jackhumbert/reform/symbol-for-derived-works/application-example-pcb.png

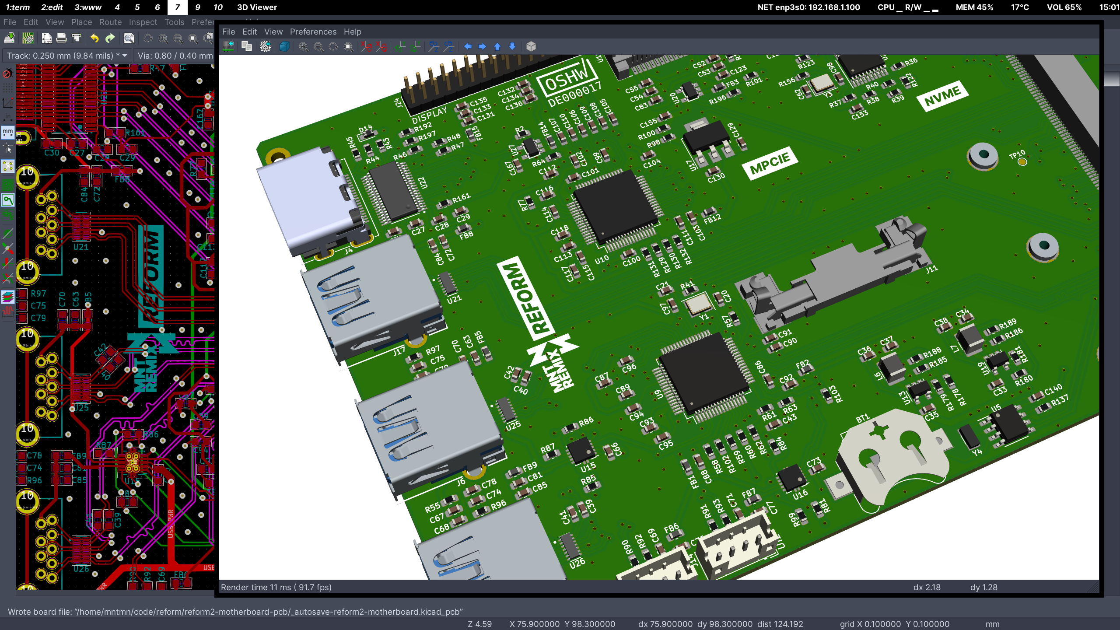
symbol-for-derived-works/application-example-pcb.png
