jackhumbert/reform/reform2-cables/mnt-reform2-serial-cable.png

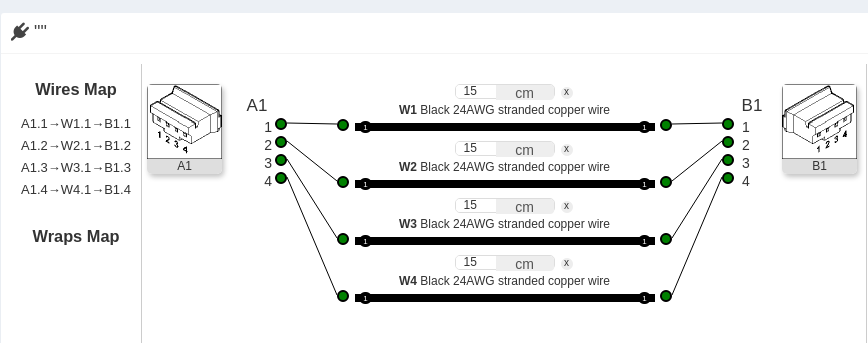
reform2-cables/mnt-reform2-serial-cable.png
