jackhumbert/reform/reform2-cables/mnt-reform2-speakers-cable.png

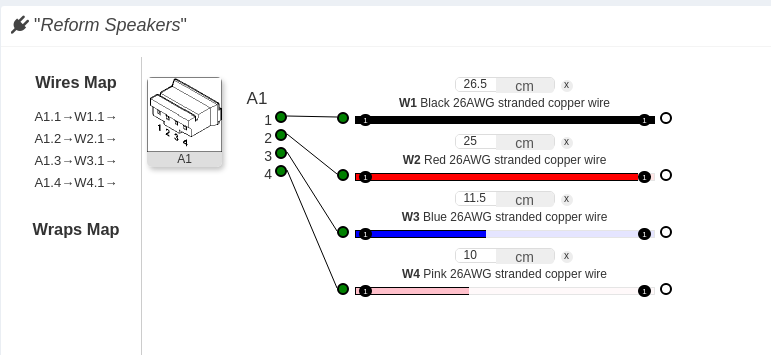
reform2-cables/mnt-reform2-speakers-cable.png
