jackhumbert/reform/reform2-motherboard25-pcb/footprints/mnt-based-reform-symbol.png

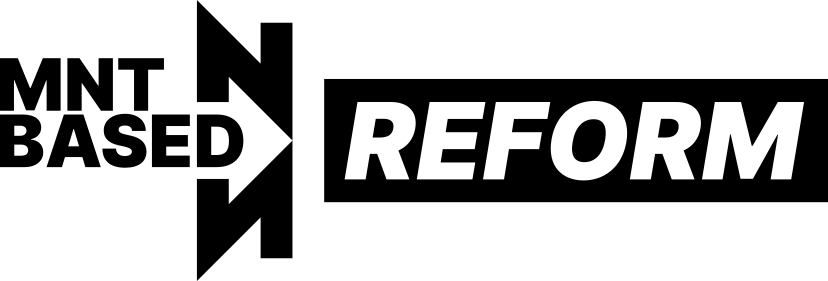
reform2-motherboard25-pcb/footprints/mnt-based-reform-symbol.png
