jackhumbert/reform/reform2-keyboard-pcb/reform2-keyboard_bom_top.csv

Comment | Designator | Footprint | LCSC Part #
Choc | SW1 SW7 SW13 SW19 SW25 SW31 SW37 SW43 SW49 SW55 SW61 SW67 SW73 SW78 SW8 SW14 SW20 SW26 SW32 SW38 SW44 SW50 SW56 SW62 SW68 SW74 SW79 SW9 SW15 SW21 SW27 SW33 SW39 SW45 SW51 SW57 SW63 SW69 SW75 SW80 SW4 SW10 SW16 SW22 SW28 SW34 SW40 SW46 SW52 SW58 SW64 SW70 SW76 SW81 SW5 SW11 SW17 SW23 SW29 SW35 SW41 SW47 SW53 SW59 SW65 SW71 SW77 SW82 SW6 SW12 SW18 SW24 SW30 SW36 SW42 SW3 SW2 SW48 SW54 SW60 SW66 SW72 |  | C400230
MMDL914T1G | D1 D7 D13 D19 D25 D31 D37 D43 D49 D55 D61 D67 D73 D78 D8 D14 D20 D26 D32 D38 D44 D50 D56 D62 D68 D74 D79 D9 D15 D21 D27 D33 D39 D45 D51 D57 D63 D69 D75 D80 D4 D10 D16 D22 D28 D34 D40 D46 D52 D58 D64 D70 D76 D81 D5 D11 D17 D23 D29 D35 D41 D47 D53 D59 D65 D71 D77 D82 D6 D12 D18 D24 D30 D36 D42 D3 D2 D48 D54 D60 D66 D72 |  | C193404
18pF | C1 C2 |  | C107040
1uF | C3 C5 C11 C12 C9 C8 C13 |  | C14664
22 | R2 R1 R17 R18 R19 |  | C107701
0.1uF | C4 C6 |  | C14663
10k | R3 R16 |  | C99198
16MHz | Y1 |  | C70562
RESET | SW83 |  | C318893
SW_DIP_x01 | SW84 |  | C402914
0 | R4 R15 |  | C95177
UART | J2 |  | C265332
AUX | J3 |  | C555410
4.7k | R5 R6 R9 |  | C105428
USB_C_Receptacle_USB2.0 | J4 |  | C165948
5.1k | R13 R14 |  | C105580
MCP1700-3302E_SOT23 | U3 |  | C39051
USBLC6-2SC6 | U4 |  | C2687116
USB | J1 |  | C265332
0ZCJ0075AF2E | F1 |  | C70082
BLM18PG221SH1D | FB1 |  | C14709
BZT52-B5V6J | D164 |  | C173406
AVR-ISP-6 | J5
TPS61185 | U2 |  | C2867853
1M | R11 |  | C107698
4.7uF | C10 C7 |  | C90057
54.9K | R12 |  | C227961
715K | R10 |  | C137685
604K | R8 |  | C245986
62K | R7 |  | C137694
B250-13-F | D83 |  | C2758510
WLED | D84 D85 D86 D87 D88 D89 D90 D91 D94 D95 D96 D97 D98 D99 D100 D101 D104 D105 D106 D107 D108 D109 D110 D111 D114 D115 D116 D117 D118 D119 D120 D121 D124 D125 D126 D127 D128 D129 D130 D131 D134 D135 D136 D137 D138 D139 D140 D141 D144 D145 D146 D147 D148 D149 D150 D151 D154 D155 D156 D157 D158 D159 D160 D161 D92 D93 D102 D103 D112 D113 D122 D123 D132 D133 D142 D143 D152 D153 D162 D163 |  | C389521
10uH | L1 |  | C98364
