jackhumbert/reform/reform2-bom/reform2-batterypack.csv

Designators | Qty | Brand | Part Number
J1 | 1 | Molex | 504050-0591
U1-U8 | 8 | Keystone | 54
