jackhumbert/reform/reform2-case-ports/ports-r1-v2-a-extrude.FCStd

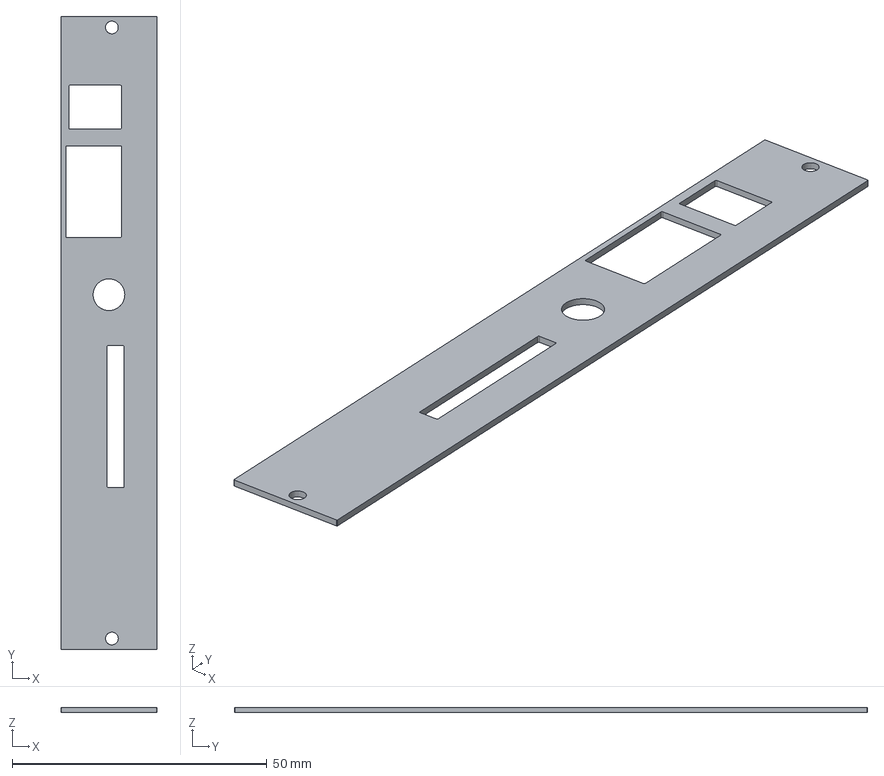
[picture p7: CAD file, 2022-02-27]
reform2-case-ports/ports-r1-v2-a-extrude.FCStd
18.9 x 124.3 x 1.00 mm
