jackhumbert/reform/reform2-imx8mplus/3d-models/FH12-22S-0.5SH.stp

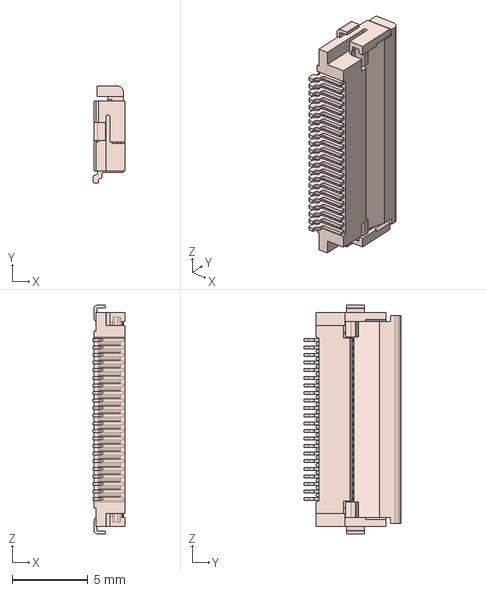
[picture p8: CAD file, 2022-09-06]
reform2-imx8mplus/3d-models/FH12-22S-0.5SH.stp
2.10 x 6.40 x 15.1 mm
