jackhumbert/reform/reform2-motherboard25-pcb/3d-models/HTQFP-80.stp

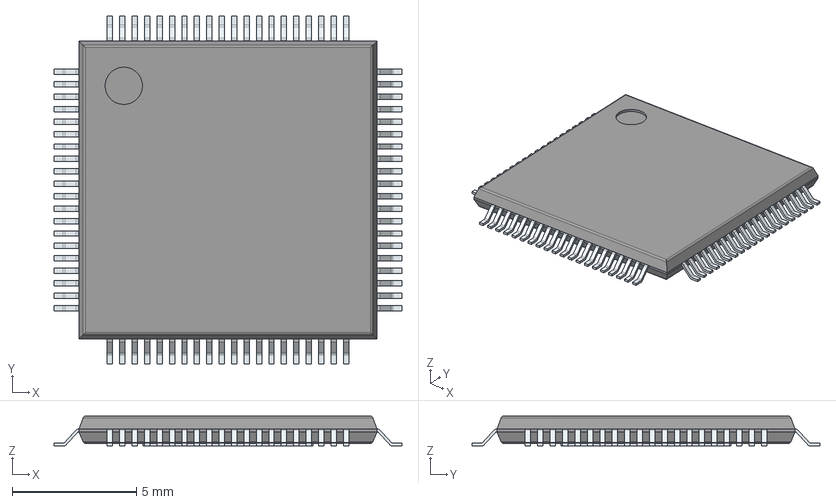
[picture p9: CAD file, 2022-10-27]
reform2-motherboard25-pcb/3d-models/HTQFP-80.stp
14.0 x 14.0 x 1.20 mm
PinsArrayLR
PinsArrayTB
ThermalPad
