jackhumbert/reform/reform2-protected-batterypack-pcb/3d-models/PowerPAK 1212-8 Single Pad.step

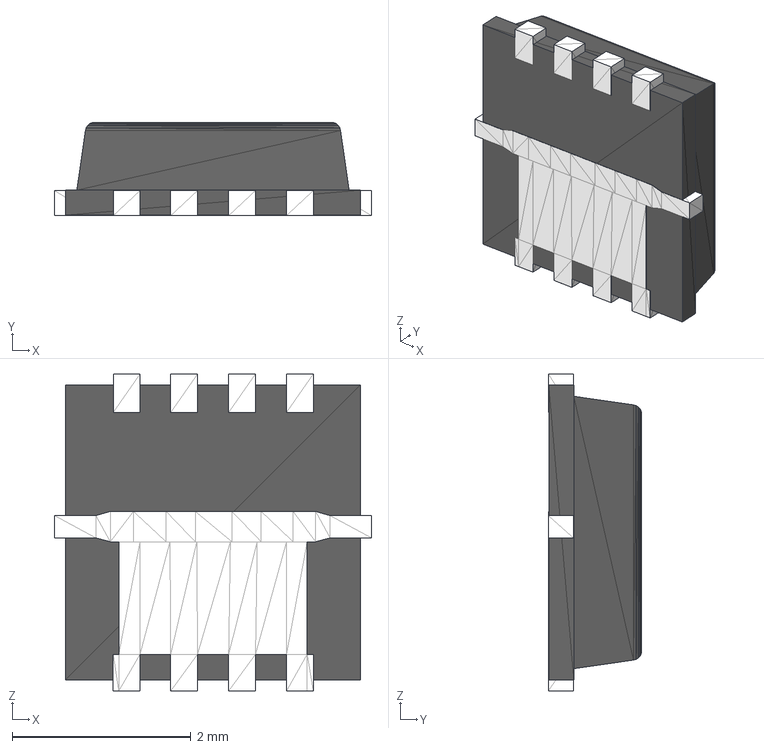
[picture p10: CAD file, 2022-08-30]
reform2-protected-batterypack-pcb/3d-models/PowerPAK 1212-8 Single Pad.step
3.55 x 1.05 x 3.55 mm
