jackhumbert/reform/reform2-trackball-pcb/3d-models/SMD_Polyfuse_1206.stp

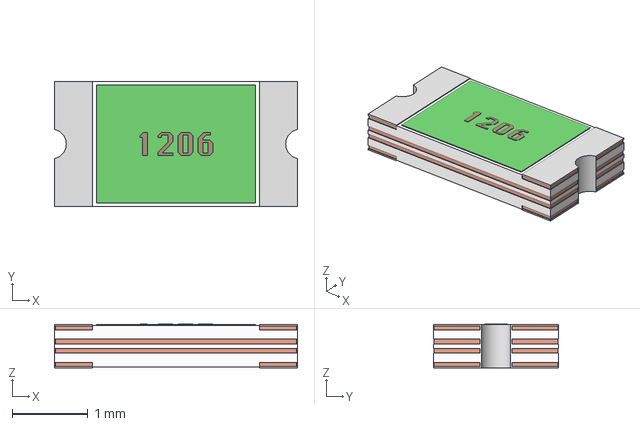
[picture p11: CAD file, 2021-07-25]
reform2-trackball-pcb/3d-models/SMD_Polyfuse_1206.stp
3.20 x 1.65 x 0.575 mm
