jackhumbert/reform/reform2-trackpad-pcb/3d-models/FH12-6S-0.5SH.stp

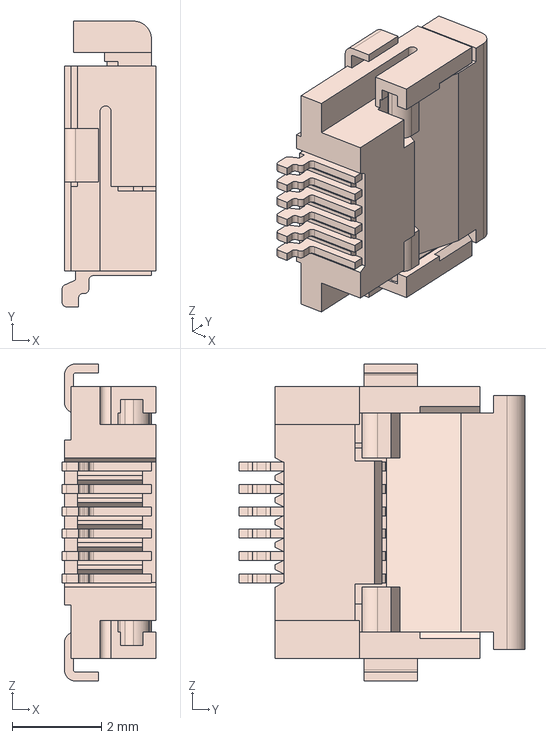
[picture p12: CAD file, 2021-07-25]
reform2-trackpad-pcb/3d-models/FH12-6S-0.5SH.stp
2.10 x 6.40 x 7.10 mm
