jackhumbert/reform/reform2-trackpad-pcb/trackpad-glass-glue-gasket-20200807.step

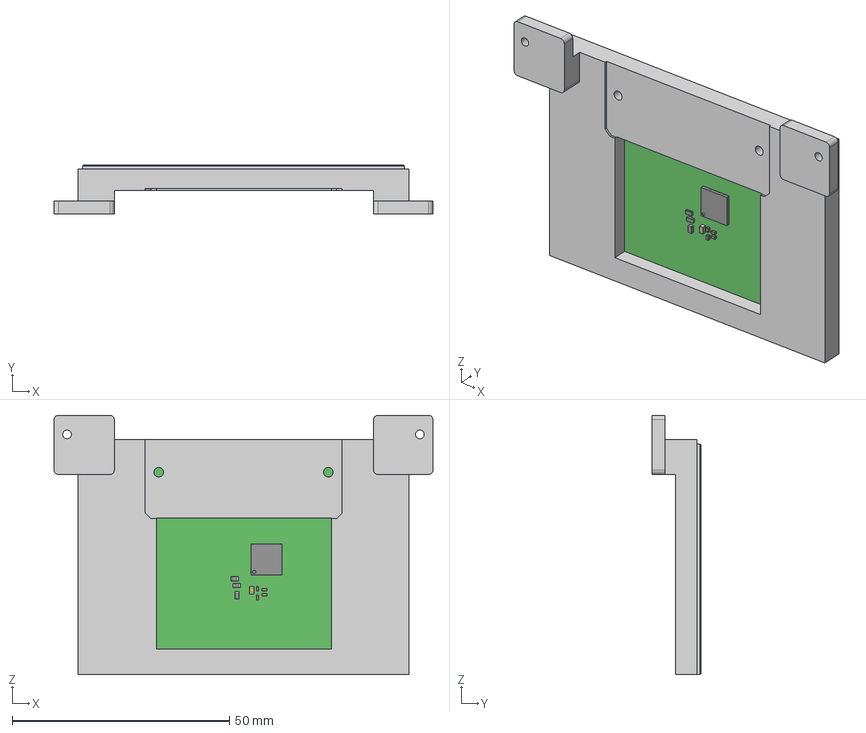
[picture p13: CAD file, 2021-07-30]
reform2-trackpad-pcb/trackpad-glass-glue-gasket-20200807.step
87.2 x 11.4 x 59.6 mm
trackingpad support (1)
glass (1)
GLUE AZOTEQ
GLUE SLA
C-0402 x 4
C-0603
R-0603 x 3
U-QFN-P0.5-7X7-48
GASKET
