jackhumbert/reform/reform2-keyboard3-pcb/3d-models/EG1271A.step

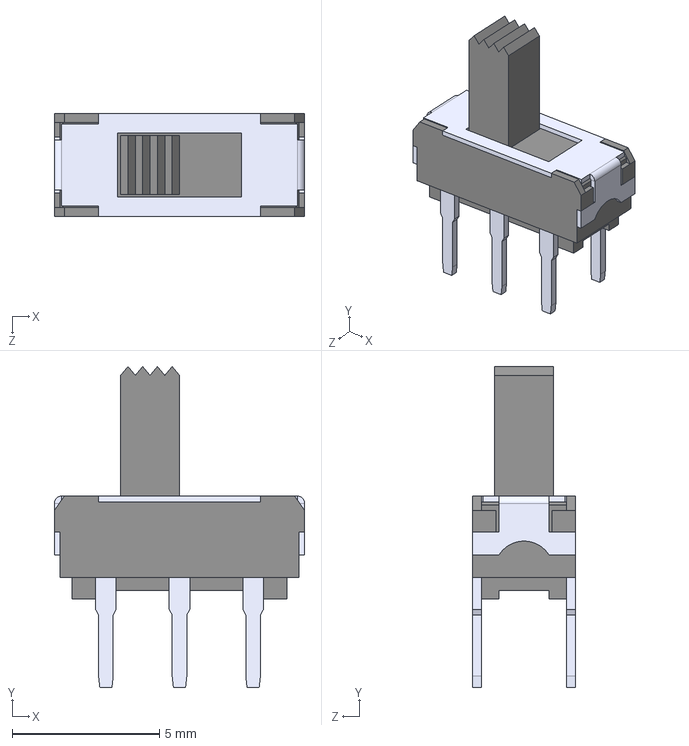
[picture p15: CAD file, 2023-02-02]
reform2-keyboard3-pcb/3d-models/EG1271A.step
8.50 x 10.9 x 3.50 mm
