jackhumbert/reform/reform2-protected-batterypack-pcb/3d-models/KEYSTONE 54 18650.step

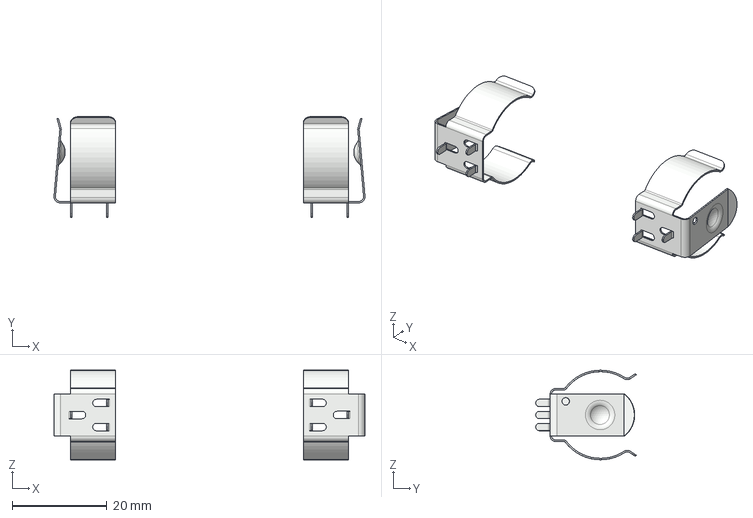
[picture p16: CAD file, 2022-08-30]
reform2-protected-batterypack-pcb/3d-models/KEYSTONE 54 18650.step
65.6 x 21.2 x 18.9 mm
KEYSTONE 54 x 2
