jackhumbert/reform/reform2-motherboard25-pcb/3d-models/srr1210.stp

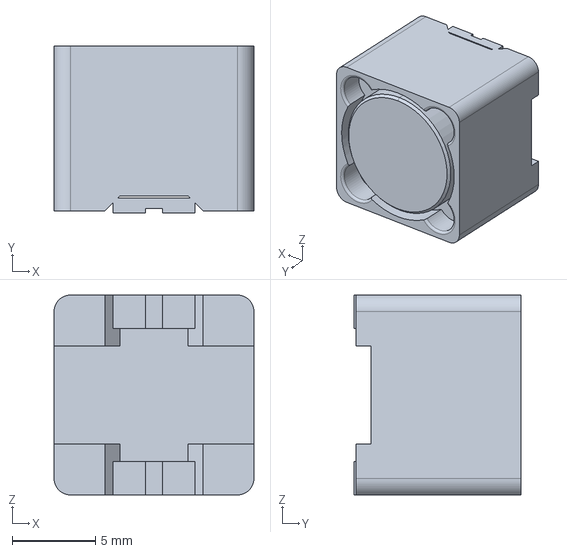
[picture p17: CAD file, 2022-10-14]
reform2-motherboard25-pcb/3d-models/srr1210.stp
12.0 x 10.0 x 12.0 mm
