jackhumbert/reform/reform2-protected-batterypack-pcb/3d-models/Bateria 18650 3.7 V 1300 mAh d.18 mm.STEP

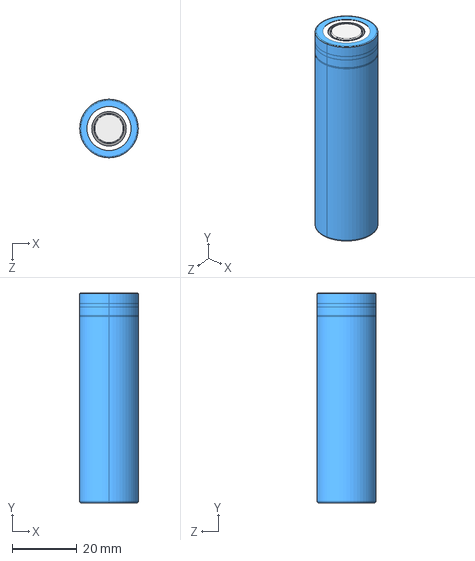
[picture p18: CAD file, 2022-08-30]
reform2-protected-batterypack-pcb/3d-models/Bateria 18650 3.7 V 1300 mAh d.18 mm.STEP
18.1 x 64.7 x 18.1 mm
