jackhumbert/reform/reform2-trackball-pcb/3d-models/c-1734839-6-c-3d.stp

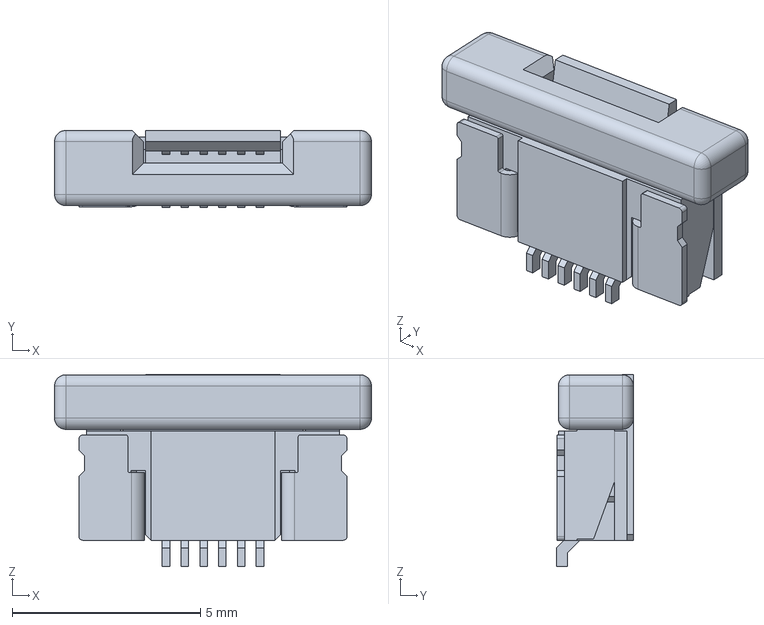
[picture p19: CAD file, 2021-07-25]
reform2-trackball-pcb/3d-models/c-1734839-6-c-3d.stp
8.43 x 2.05 x 5.11 mm
