jackhumbert/reform/reform2-keyboard3-pcb/3d-models/Kailh - keycap 1.5 v2.step

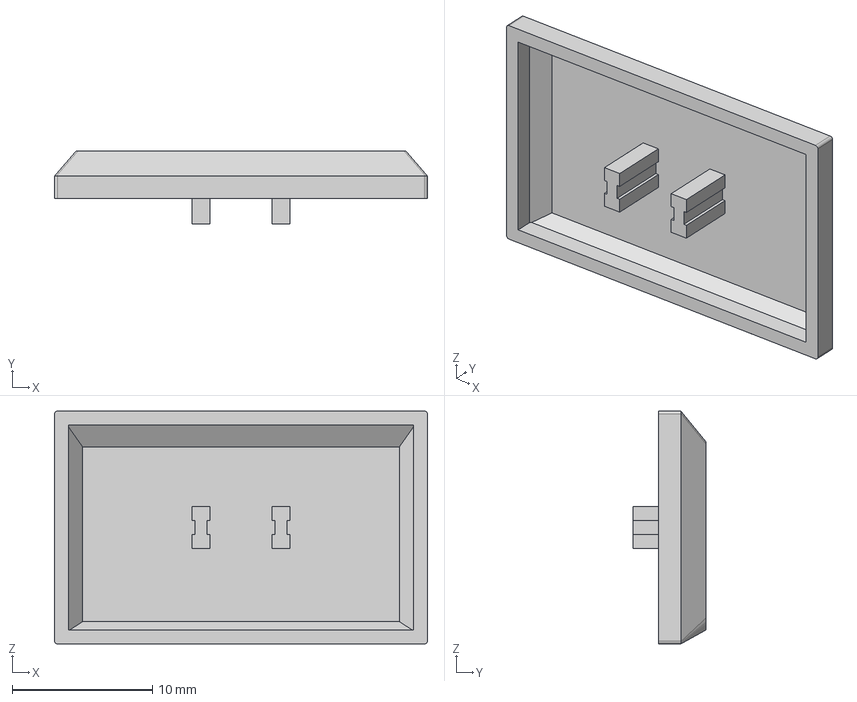
[picture p20: CAD file, 2023-02-02]
reform2-keyboard3-pcb/3d-models/Kailh - keycap 1.5 v2.step
26.6 x 5.23 x 16.6 mm
