jackhumbert/reform/reform2-keyboard3-pcb/3d-models/S4B-PH-SM4-TB.stp

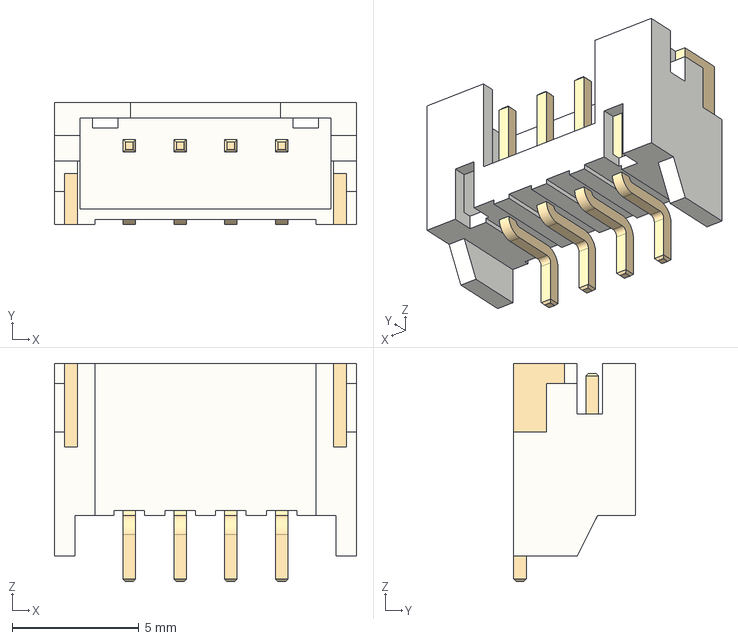
[picture p21: CAD file, 2023-02-02]
reform2-keyboard3-pcb/3d-models/S4B-PH-SM4-TB.stp
11.9 x 4.80 x 8.60 mm
