jackhumbert/reform/reform2-keyboard3-pcb/3d-models/Kailh_keycap-switch_system_1x1.step

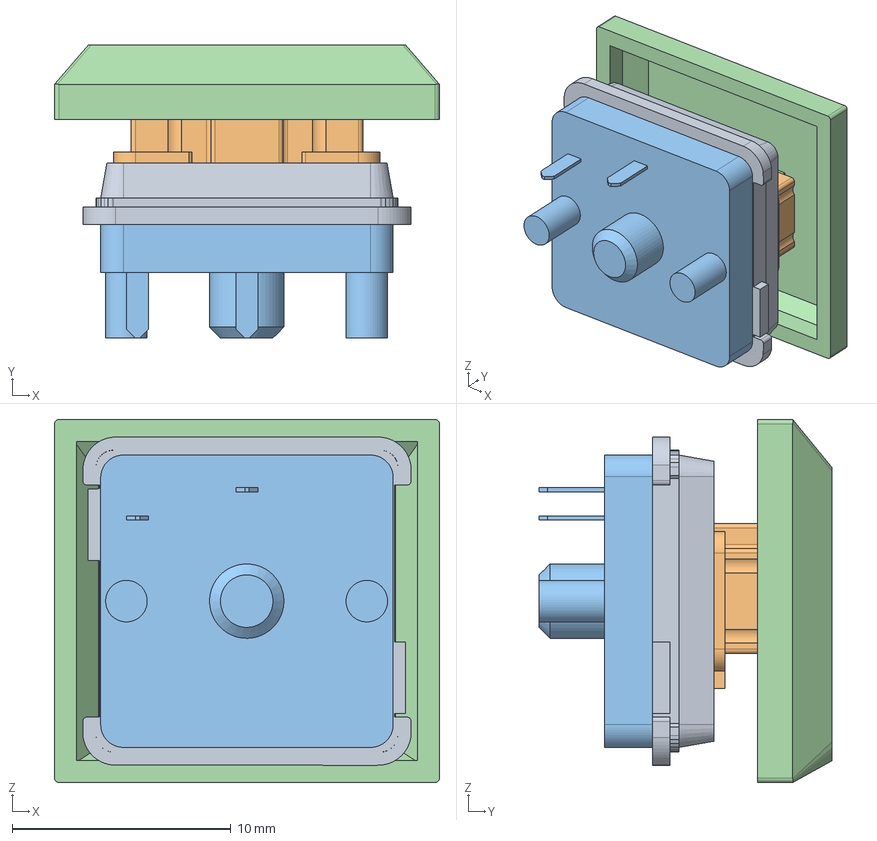
[picture p22: CAD file, 2023-02-02]
reform2-keyboard3-pcb/3d-models/Kailh_keycap-switch_system_1x1.step
17.6 x 13.4 x 16.6 mm
CPG135001D02 BROWN
Kailh_keycap
