jackhumbert/reform/reform2-protected-batterypack-pcb/3d-models/KEYSTONE 54 A.step

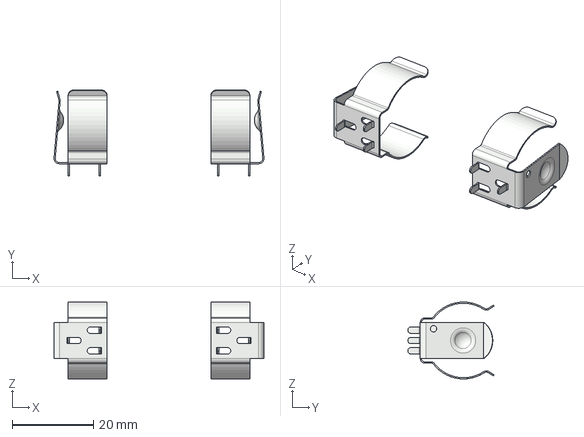
[picture p23: CAD file, 2022-08-30]
reform2-protected-batterypack-pcb/3d-models/KEYSTONE 54 A.step
51.6 x 21.2 x 18.9 mm
KEYSTONE 54 x 2
