jackhumbert/reform/reform2-keyboard3-pcb/3d-models/Kailh_keycap-switch_system_1.5x1.step

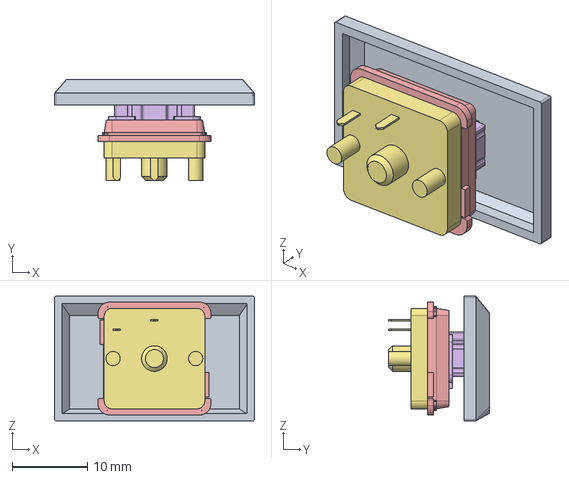
[picture p24: CAD file, 2023-02-02]
reform2-keyboard3-pcb/3d-models/Kailh_keycap-switch_system_1.5x1.step
26.6 x 13.4 x 16.6 mm
