jackhumbert/reform/reform2-motherboard25-pcb/3d-models/SMD_Polyfuse_2920.stp

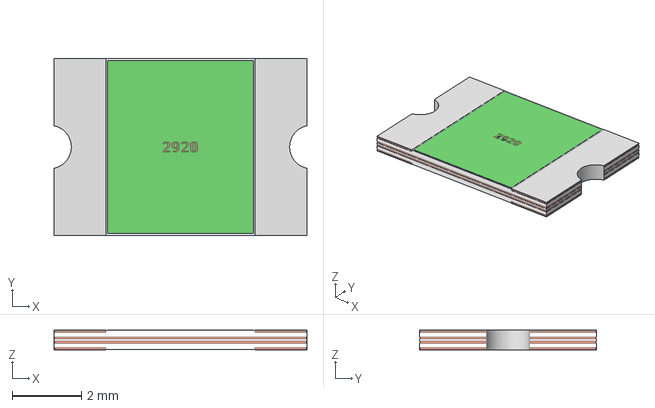
[picture p25: CAD file, 2022-10-14]
reform2-motherboard25-pcb/3d-models/SMD_Polyfuse_2920.stp
7.30 x 5.10 x 0.575 mm
