jackhumbert/reform/reform2-protected-batterypack-pcb/3d-models/POWERPAK 1212-8.STEP

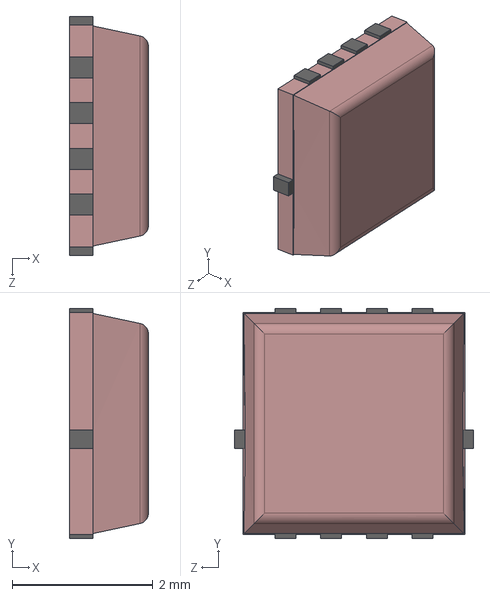
[picture p26: CAD file, 2022-08-30]
reform2-protected-batterypack-pcb/3d-models/POWERPAK 1212-8.STEP
1.12 x 3.27 x 3.40 mm
