jackhumbert/reform/reform2-keyboard3-pcb/3d-models/500SSPxS2M2xEA.stp

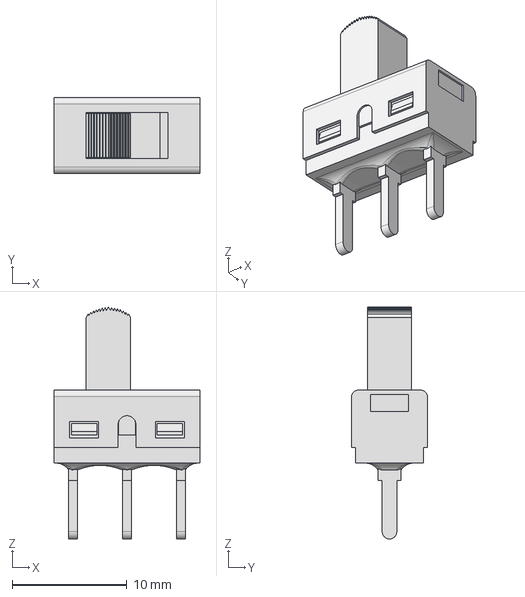
[picture p27: CAD file, 2023-02-02]
reform2-keyboard3-pcb/3d-models/500SSPxS2M2xEA.stp
12.7 x 6.60 x 20.2 mm
