jackhumbert/reform/reform2-motherboard25-pcb/3d-models/CM2020-00TR--3DModel-STEP-56544.STEP

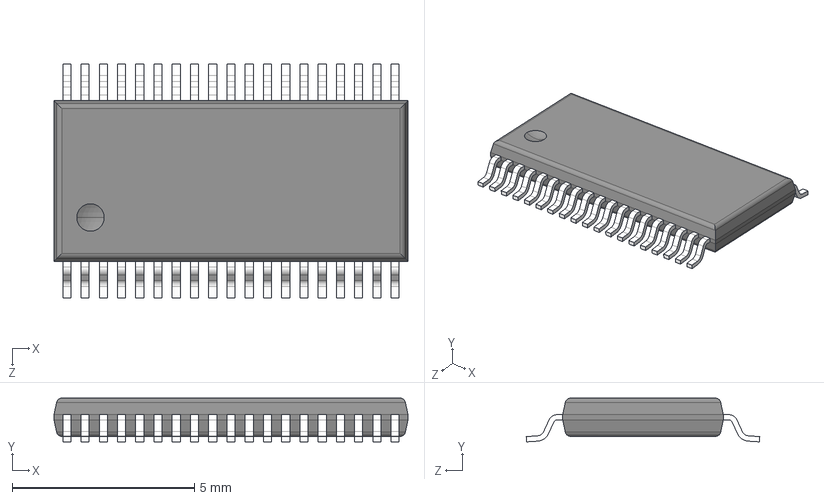
[picture p28: CAD file, 2022-10-14]
reform2-motherboard25-pcb/3d-models/CM2020-00TR--3DModel-STEP-56544.STEP
9.70 x 1.20 x 6.40 mm
