jackhumbert/reform/reform2-protected-batterypack-pcb/3d-models/keystone-PN54.STEP

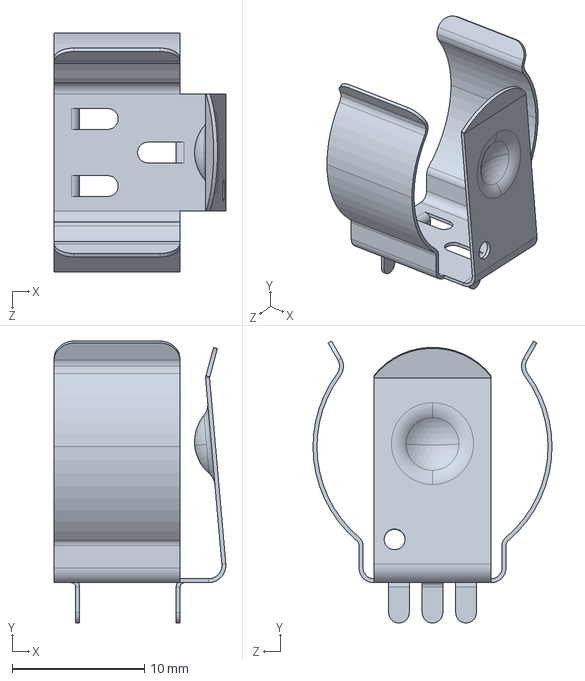
[picture p29: CAD file, 2022-08-30]
reform2-protected-batterypack-pcb/3d-models/keystone-PN54.STEP
13.0 x 21.4 x 18.1 mm
