jackhumbert/reform/reform2-keyboard3-pcb/3d-models/srp4020.stp

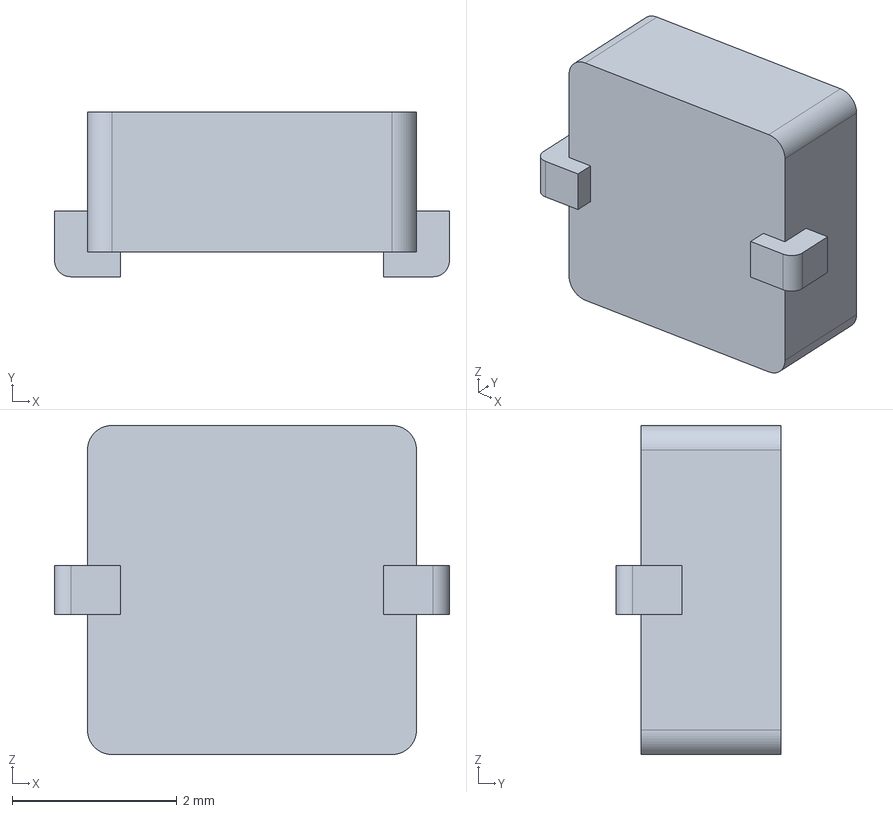
[picture p30: CAD file, 2023-02-02]
reform2-keyboard3-pcb/3d-models/srp4020.stp
4.80 x 2.00 x 4.00 mm
