jackhumbert/reform/reform2-motherboard25-pcb/3d-models/L8BE-1G1T-BFH--3DModel-STEP-56544.STEP

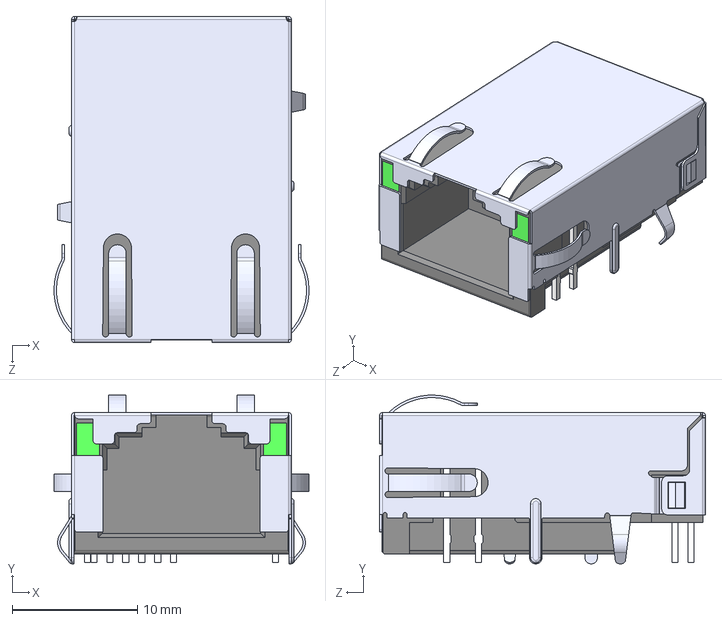
[picture p31: CAD file, 2022-10-14]
reform2-motherboard25-pcb/3d-models/L8BE-1G1T-BFH--3DModel-STEP-56544.STEP
20.4 x 13.5 x 26.1 mm
