jackhumbert/reform/reform2-keyboard3-pcb/3d-models/TYPE-C-31-M-12--3DModel-STEP-56544.STEP

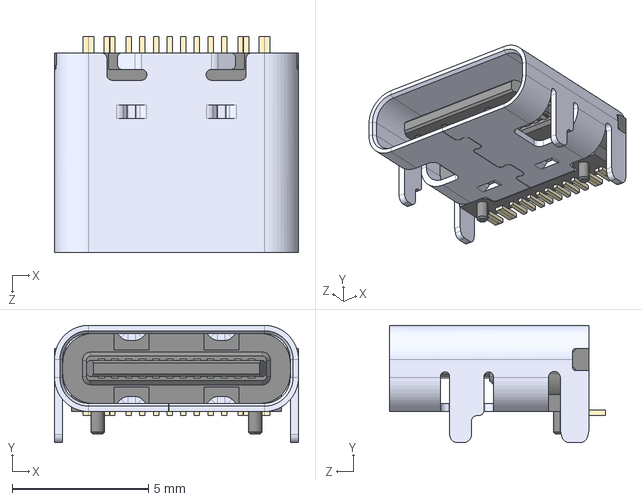
[picture p32: CAD file, 2022-09-01]
reform2-keyboard3-pcb/3d-models/TYPE-C-31-M-12--3DModel-STEP-56544.STEP
8.94 x 4.30 x 7.90 mm
