jackhumbert/reform/reform2-keyboard3-pcb/3d-models/KMR221GLFS.step

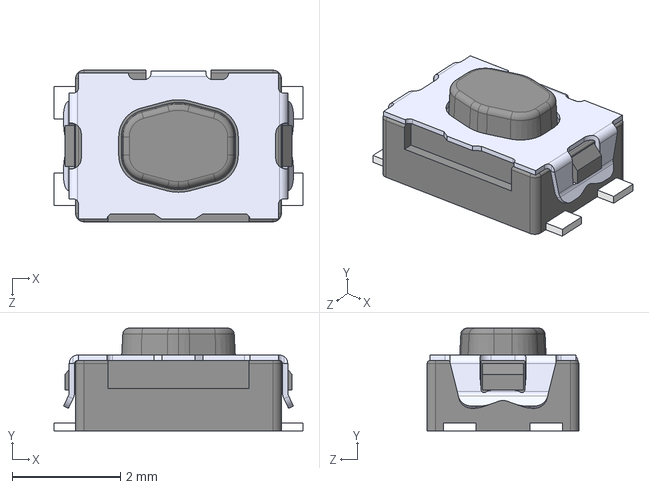
[picture p33: CAD file, 2021-07-25]
reform2-keyboard3-pcb/3d-models/KMR221GLFS.step
4.60 x 1.90 x 2.80 mm
