jackhumbert/reform/reform2-motherboard25-pcb/3d-models/J0G-0003NL.step

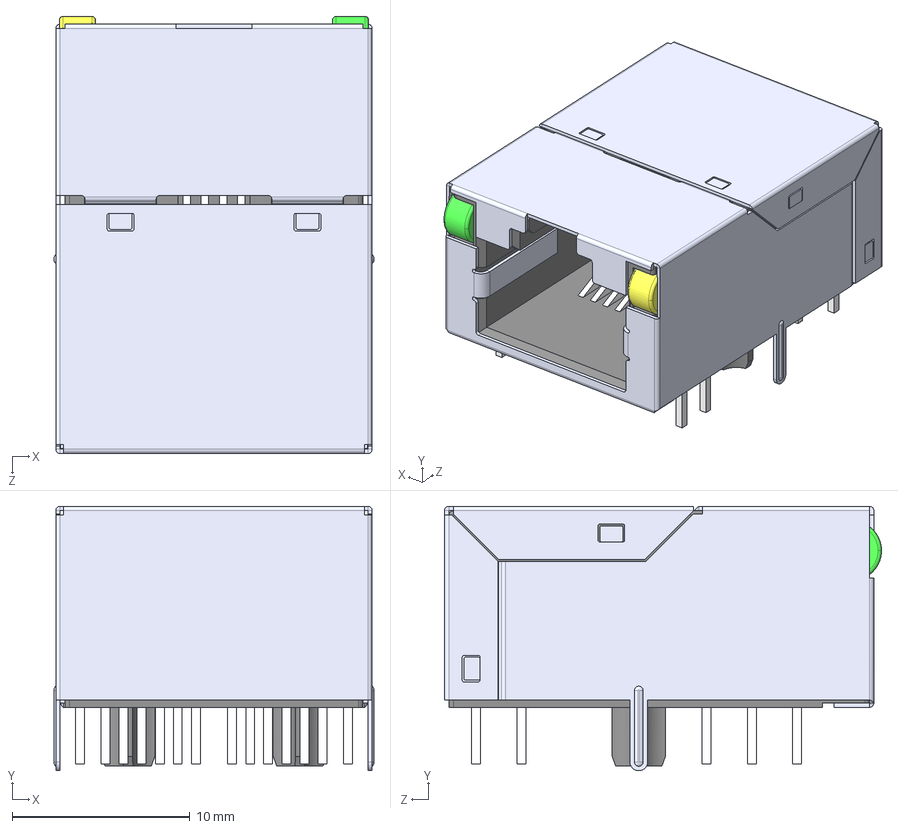
[picture p34: CAD file, 2022-10-14]
reform2-motherboard25-pcb/3d-models/J0G-0003NL.step
18.0 x 14.9 x 24.6 mm
