jackhumbert/reform/reform2-motherboard25-pcb/3d-models/21-0140L_T1655-2.step

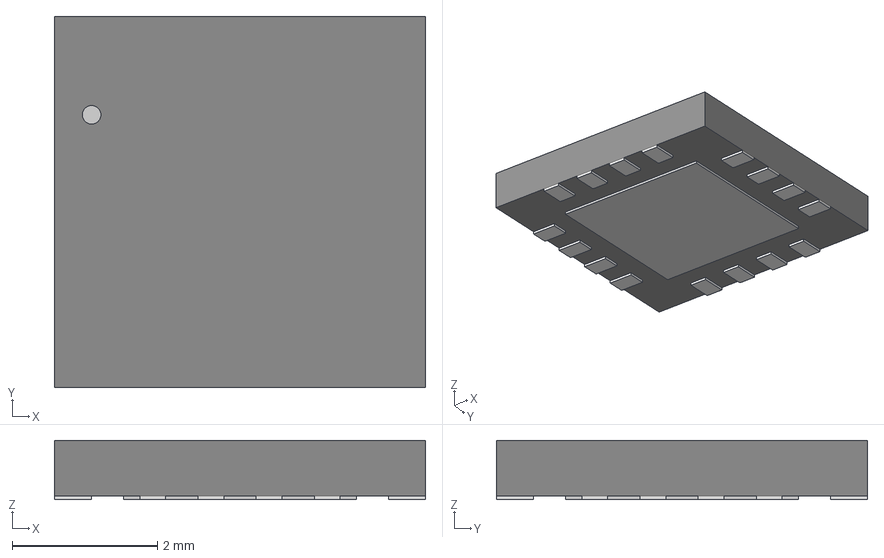
[picture p35: CAD file, 2022-10-14]
reform2-motherboard25-pcb/3d-models/21-0140L_T1655-2.step
5.11 x 5.11 x 0.815 mm
