jackhumbert/reform/reform2-motherboard25-pcb/3d-models/SW3dPS-rapc722.STEP

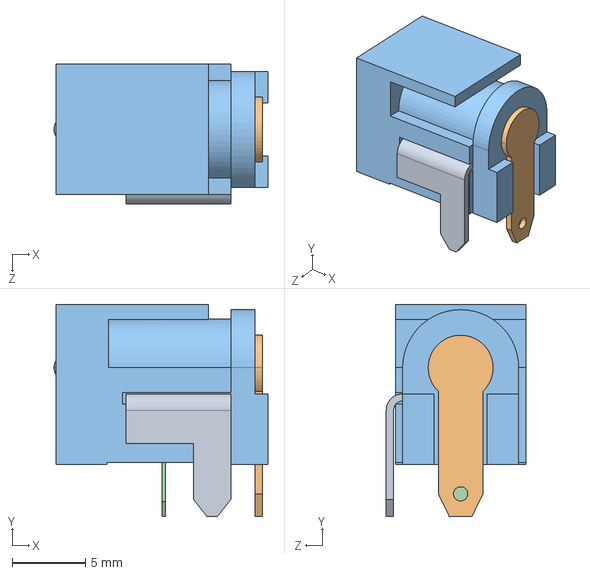
[picture p36: CAD file, 2022-10-14]
reform2-motherboard25-pcb/3d-models/SW3dPS-rapc722.STEP
14.6 x 14.5 x 9.52 mm
