jackhumbert/reform/reform2-motherboard25-pcb/3d-models/sj-43516-smt.step

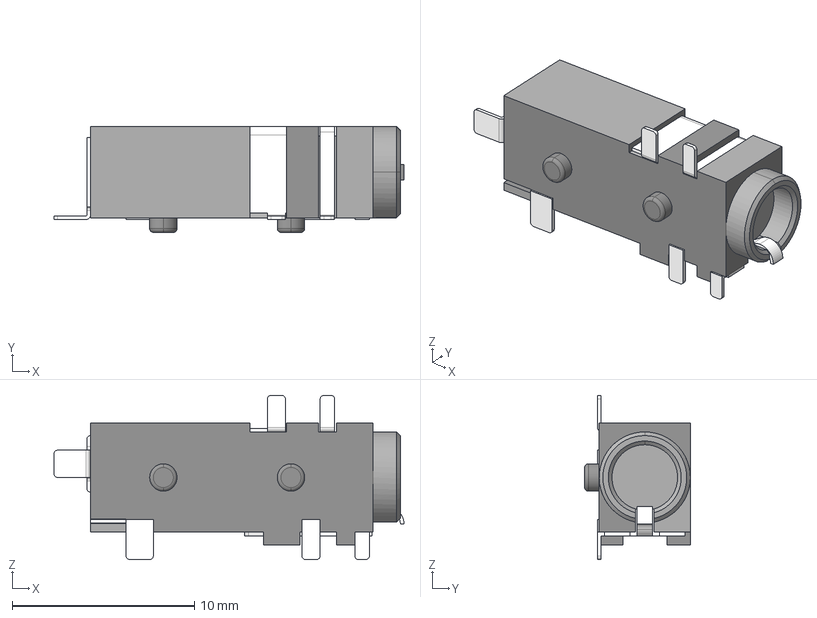
[picture p37: CAD file, 2022-10-14]
reform2-motherboard25-pcb/3d-models/sj-43516-smt.step
19.2 x 5.80 x 9.00 mm
