jackhumbert/reform/reform2-motherboard25-pcb/3d-models/c-5-2069716-2-c-3d.stp

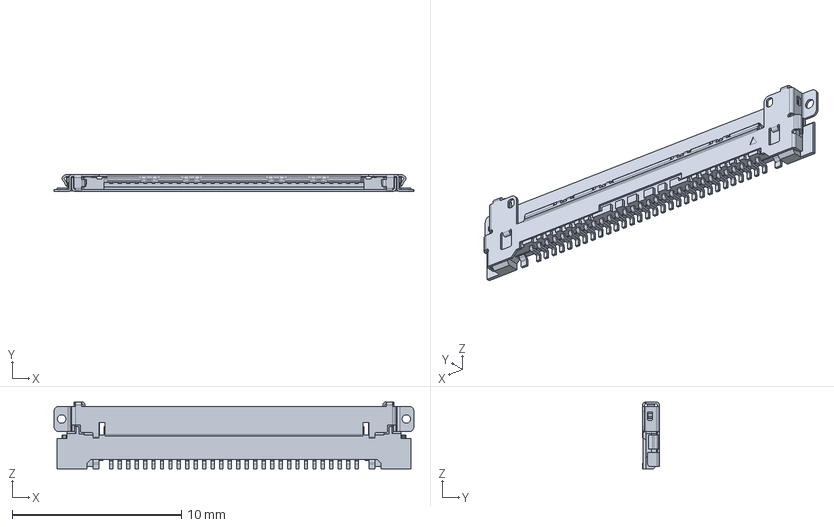
[picture p38: CAD file, 2022-10-14]
reform2-motherboard25-pcb/3d-models/c-5-2069716-2-c-3d.stp
21.2 x 1.00 x 3.95 mm
