jackhumbert/reform/reform2-motherboard25-pcb/3d-models/uj3-ah-4-th.step

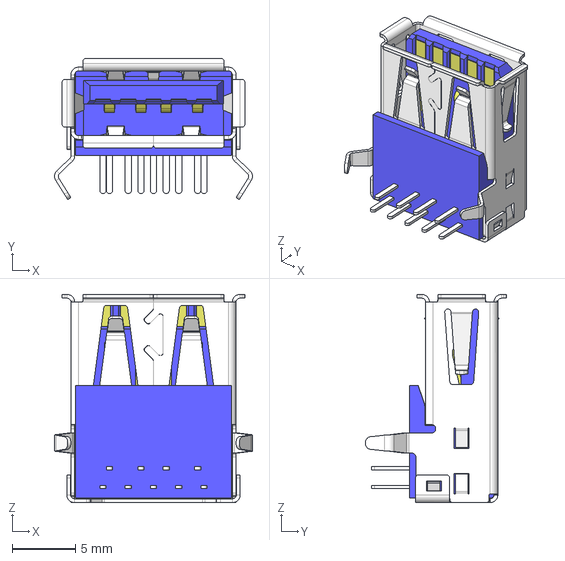
[picture p40: CAD file, 2022-10-14]
reform2-motherboard25-pcb/3d-models/uj3-ah-4-th.step
15.7 x 11.2 x 16.5 mm
