jackhumbert/reform/reform2-motherboard25-pcb/3d-models/KMR243GLFG.stp

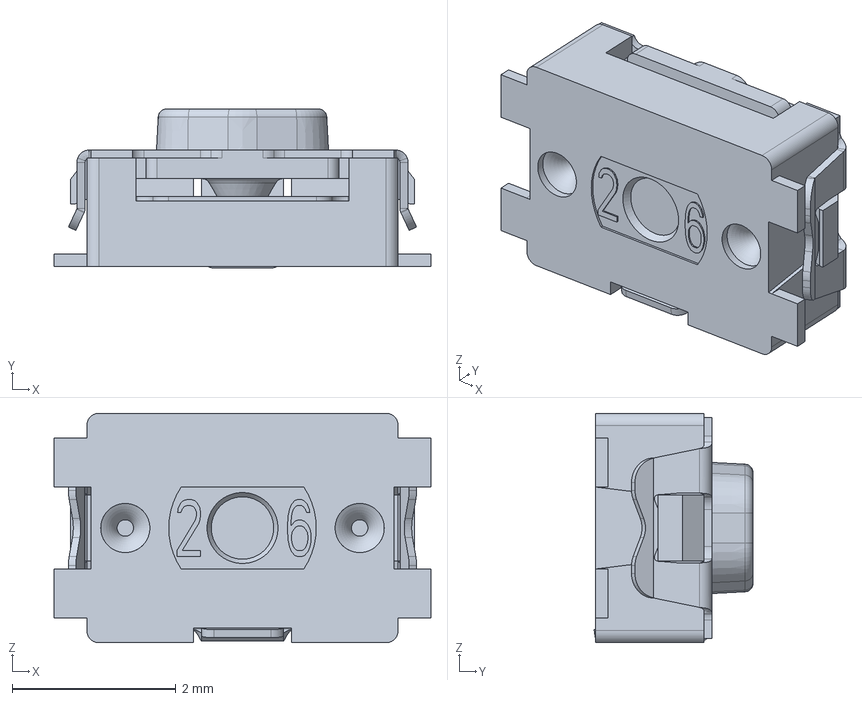
[picture p41: CAD file, 2022-10-14]
reform2-motherboard25-pcb/3d-models/KMR243GLFG.stp
4.60 x 1.94 x 2.80 mm
