jackhumbert/reform/reform2-motherboard25-pcb/3d-models/SP3012-06UTG.stp

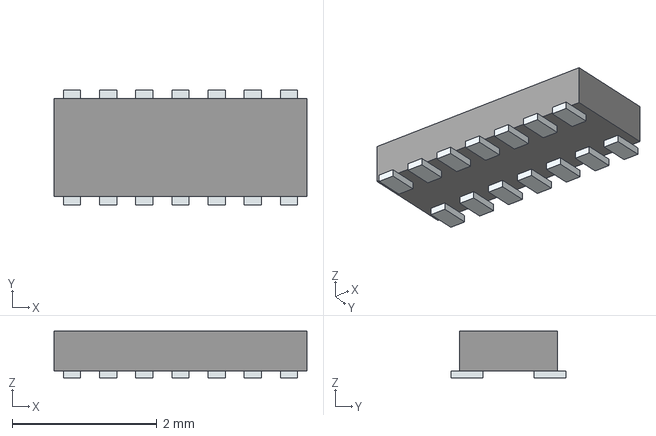
[picture p43: CAD file, 2022-10-14]
reform2-motherboard25-pcb/3d-models/SP3012-06UTG.stp
3.50 x 1.59 x 0.65 mm
Pins
