jackhumbert/reform/reform2-motherboard25-pcb/3d-models/c-1775059-1-d-3d.stp

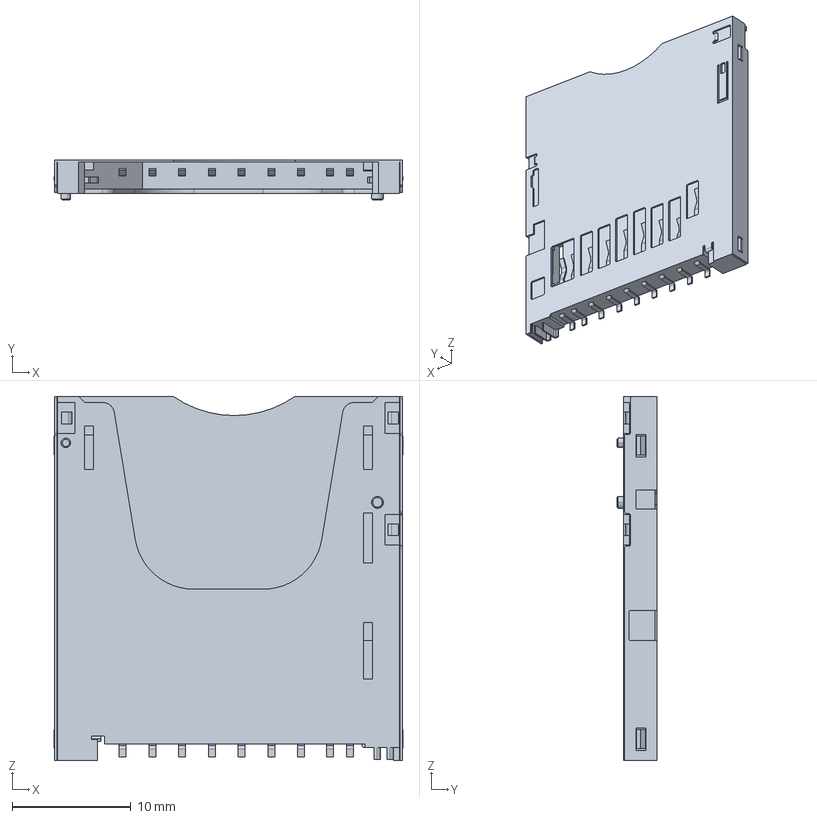
[picture p44: CAD file, 2022-10-14]
reform2-motherboard25-pcb/3d-models/c-1775059-1-d-3d.stp
29.3 x 3.40 x 30.6 mm
