jackhumbert/reform/reform2-motherboard25-pcb/3d-models/FH12-33S-0.5SH.stp

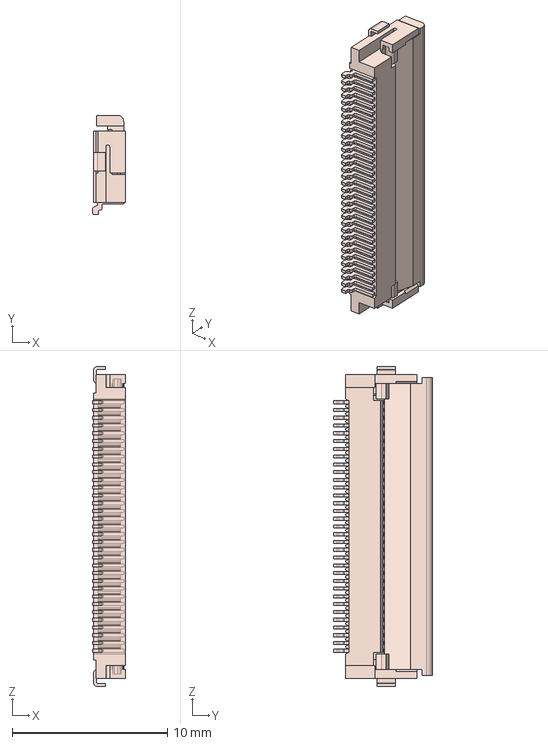
[picture p45: CAD file, 2022-09-06]
reform2-motherboard25-pcb/3d-models/FH12-33S-0.5SH.stp
2.10 x 6.40 x 20.6 mm
