jackhumbert/reform/reform2-motherboard25-pcb/3d-models/PowerPAK SO-8.stp

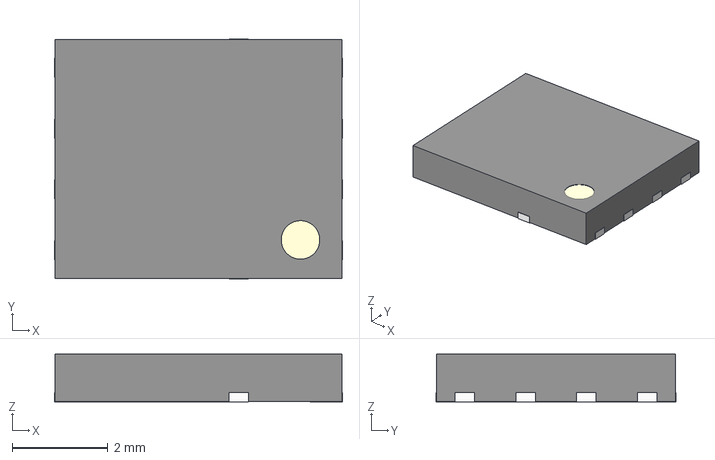
[picture p46: CAD file, 2022-08-30]
reform2-motherboard25-pcb/3d-models/PowerPAK SO-8.stp
6.02 x 5.02 x 1.00 mm
pins
