jackhumbert/reform/(list of files, cad)

Other CAD files:
reform2-trackpad-pcb/3d-models/FH12-6S-0.stl
reform2-case-ports/ports-r1-v2-a.step
reform2-case-ports/ports-r1-v2-b.step
reform2-keyboard3-pcb/3d-models/Kailh_keycap-switch_system_1-5x1.step
reform2-motherboard25-pcb/3d-models/CUI_SJ-43516-SMT-TR.step
reform2-keyboard3-pcb/3d-models/2005280040.stp
reform2-keyboard3-pcb/3d-models/CPG135001D02 BROWN v5.step
reform2-motherboard25-pcb/3d-models/1050170001.stp
reform2-motherboard25-pcb/3d-models/1054051110.stp
reform2-motherboard25-pcb/3d-models/1747981-1.step
reform2-motherboard25-pcb/3d-models/2013357-1.step
reform2-motherboard25-pcb/3d-models/436500500.stp
reform2-motherboard25-pcb/3d-models/480995701.stp
reform2-motherboard25-pcb/3d-models/483930001.stp
reform2-motherboard25-pcb/3d-models/484050003.stp
reform2-motherboard25-pcb/3d-models/5035000993.stp
reform2-motherboard25-pcb/3d-models/5040500591.stp
reform2-motherboard25-pcb/3d-models/629105136821.stp
reform2-motherboard25-pcb/3d-models/679105700.stp
reform2-motherboard25-pcb/3d-models/687133149022_Download_STP_687133149022_rev1.stp
reform2-motherboard25-pcb/3d-models/7447709001.stp
reform2-motherboard25-pcb/3d-models/9774010243R.stp
reform2-protected-batterypack-pcb/3d-models/1053091105.stp
reform2-protected-batterypack-pcb/3d-models/5040500891.stp
reform2-trackball-pcb/3d-models/527450697.stp
reform2-trackball-pcb/3d-models/687106183722_Download_STP_687106183722_rev1.stp
