jackhumbert/reform/reform2-imx8mplus/reform2-imx8mplus.kicad_pcb

## KiCad design reform2-imx8mplus/reform2-imx8mplus.kicad_pcb (2023-02-02)

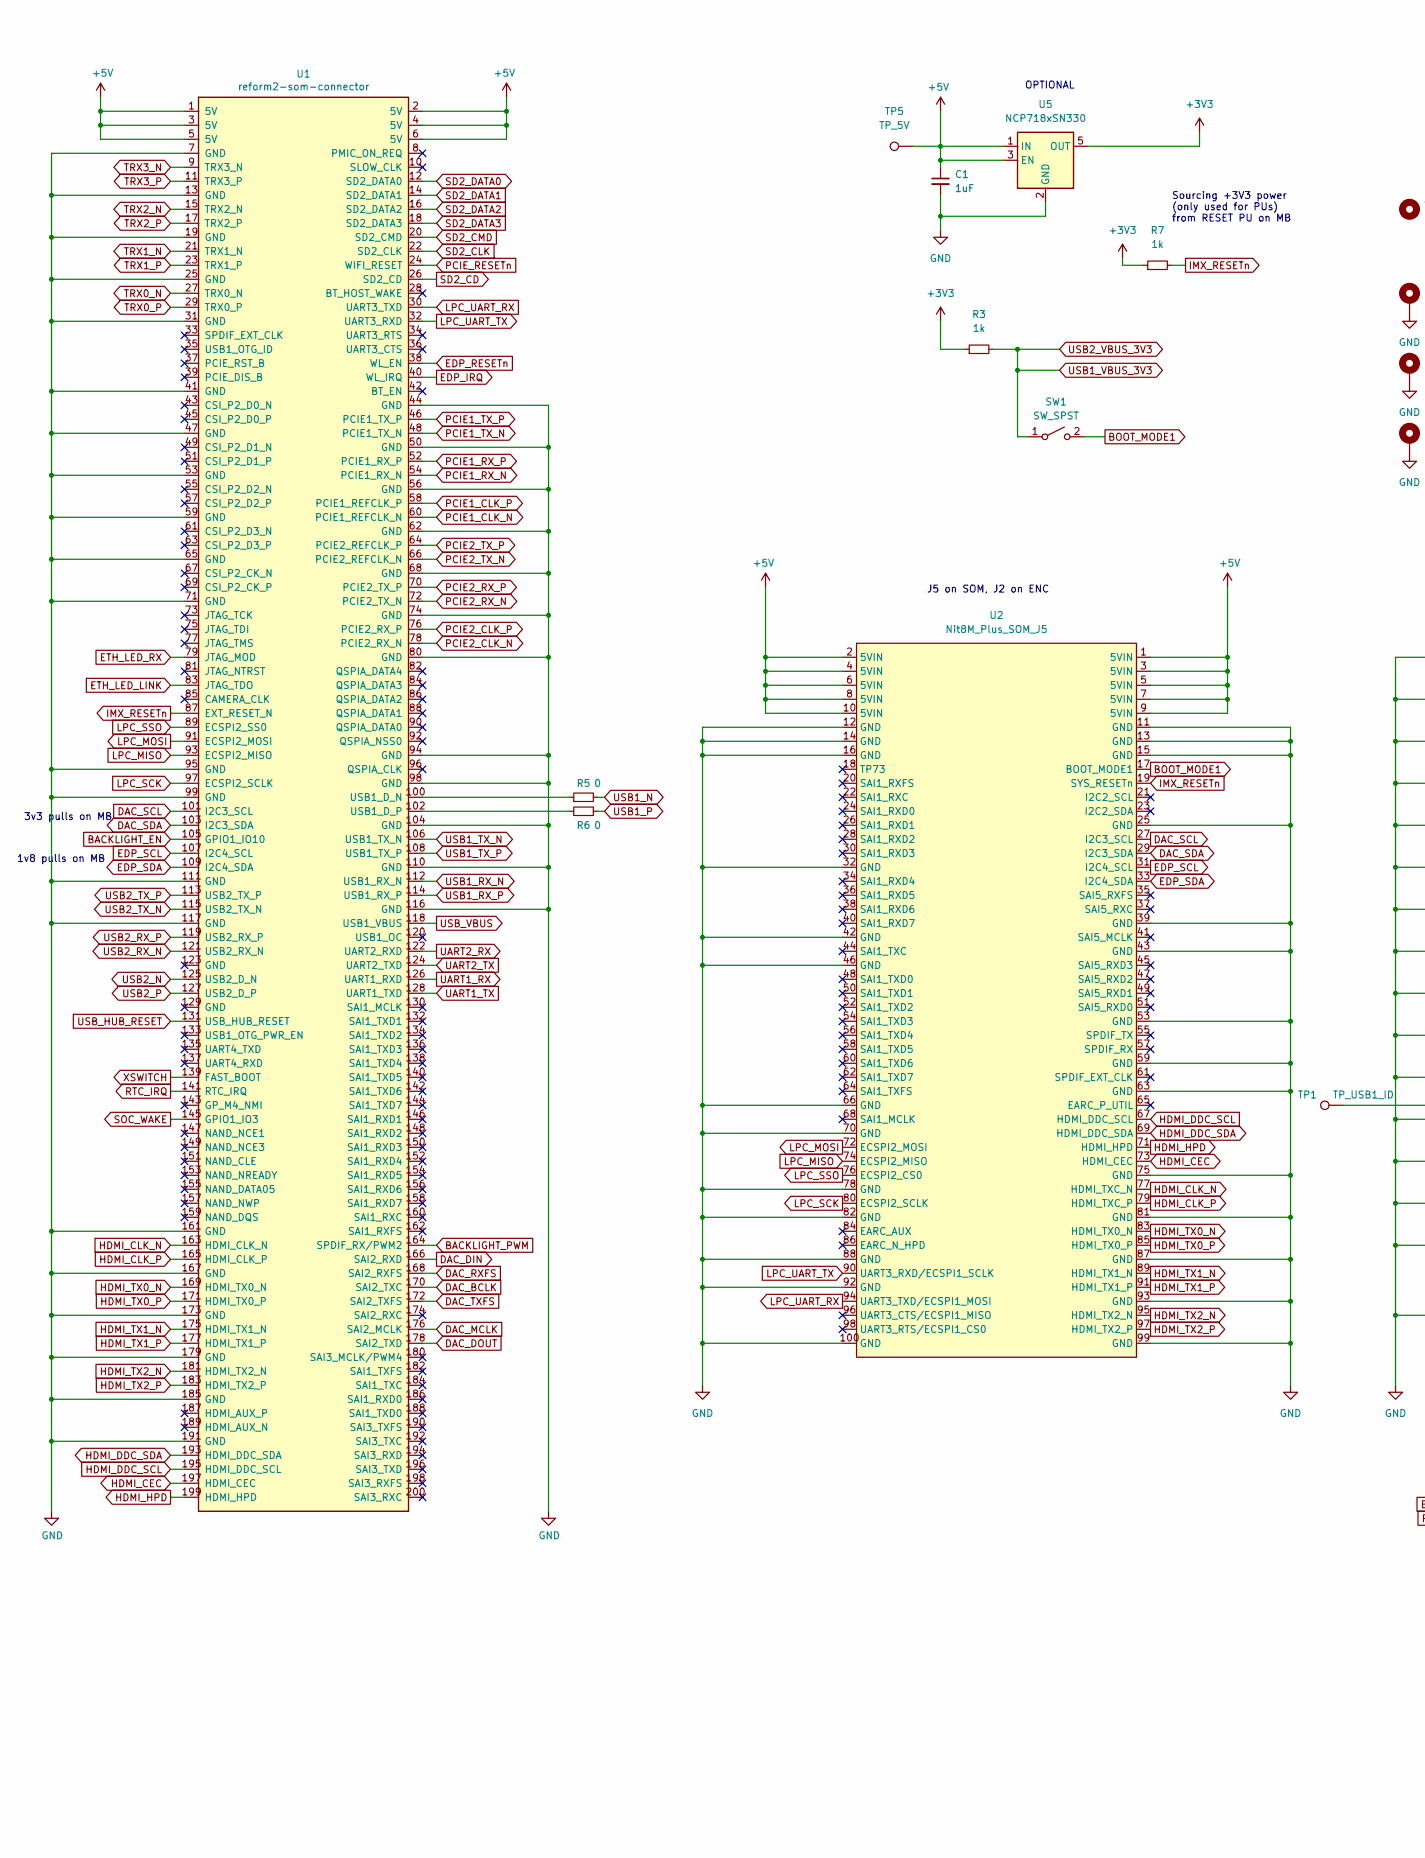
[picture p47: schematic reform2-imx8mplus.kicad_sch, part in row 1, column 1]

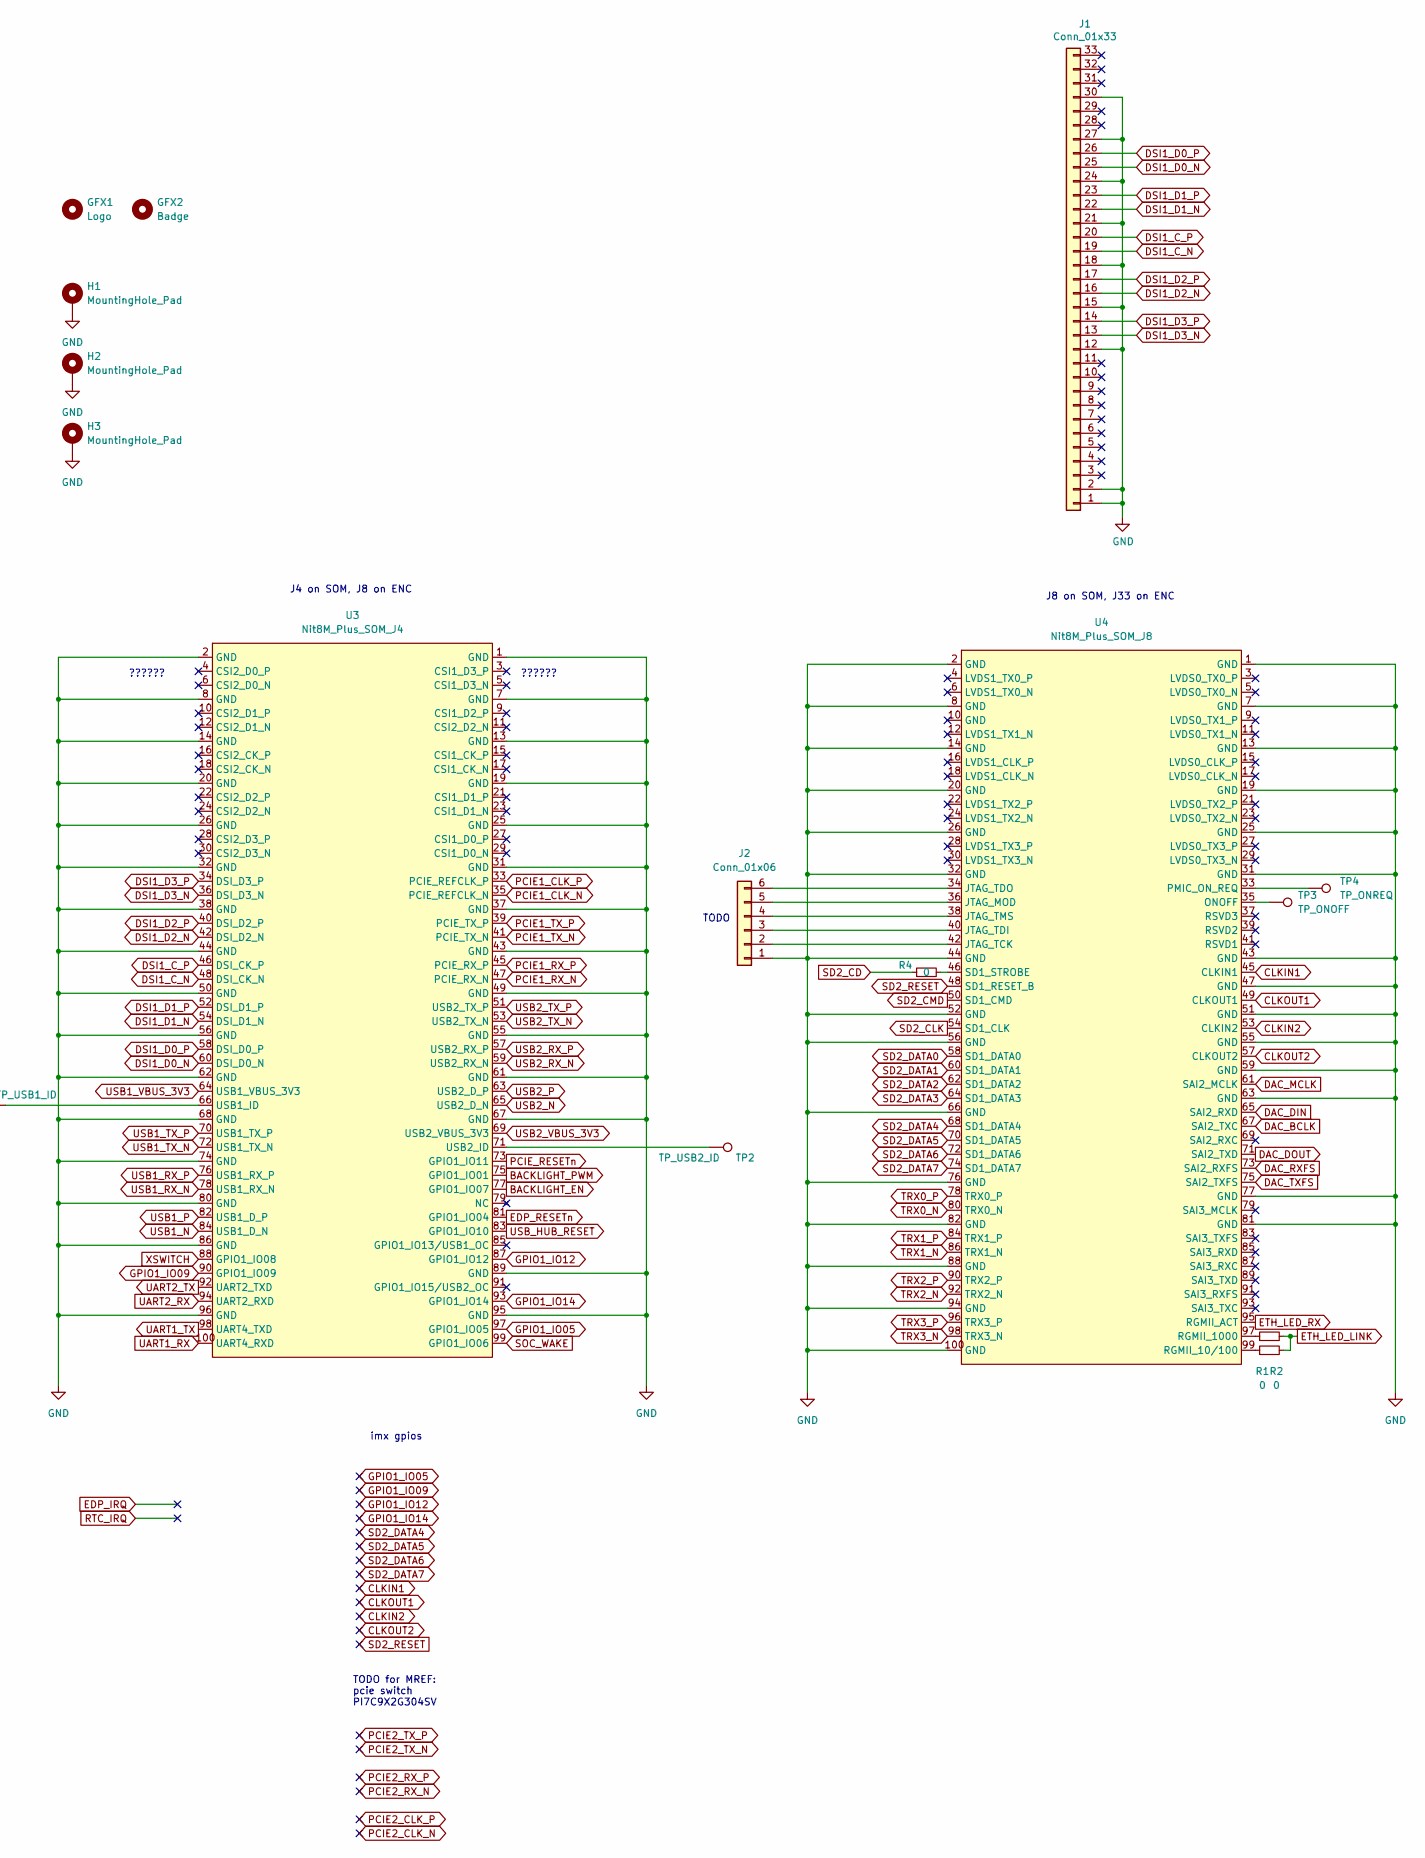
[picture p48: schematic reform2-imx8mplus.kicad_sch, part in row 1, column 2]

Parts:
C1: 1uF; C_0603_1608Metric
GFX1: Logo; mntreform
GFX2: Badge; reform2-imx8mplus-badge
H1, H2, H3: MountingHole_Pad; MountingHole_2.2mm_M2_DIN965_Pad
J1: Conn_01x33; Hirose_FH12-33S-0.5SH_1x33-1MP_P0.50mm_Horizontal; MPN FH12-33S-0.5SH
J2: Conn_01x06; PinHeader_1x06_P2.00mm_Vertical
R1, R2, R5, R6: 0; R_0603_1608Metric
R3, R7: 1k; C_0603_1608Metric
R4: 0; C_0603_1608Metric
SW1: SW_SPST; PinHeader_1x02_P2.00mm_Horizontal
TP1: TP_USB1_ID; TestPoint_Pad_1.0x1.0mm
TP2: TP_USB2_ID; TestPoint_Pad_1.0x1.0mm
TP3: TP_ONOFF; TestPoint_Pad_1.0x1.0mm
TP4: TP_ONREQ; TestPoint_Pad_1.0x1.0mm
TP5: TP_5V; TestPoint_Pad_1.0x1.0mm
U1: reform2-som-connector; ddr2-sodimm200; MPN DNP
U2: Nit8M_Plus_SOM_J5; HRS_DF40C-100DS-0.4V(51)
U3: Nit8M_Plus_SOM_J4; HRS_DF40C-100DS-0.4V(51)
U4: Nit8M_Plus_SOM_J8; HRS_DF40C-100DS-0.4V(51)
U5: NCP718xSN330; SOT-23-5

Connections:
+3V3: R3.1, R7.1, U5.5 (OUT)
+5V: C1.1, TP5.1, U1.1 (5V), U1.2 (5V), U1.3 (5V), U1.4 (5V), U1.5 (5V), U1.6 (5V), U2.1 (5VIN), U2.2 (5VIN), U2.3 (5VIN), U2.4 (5VIN), U2.5 (5VIN), U2.6 (5VIN), U2.7 (5VIN), U2.8 (5VIN), U2.9 (5VIN), U2.10 (5VIN), U5.1 (IN), U5.3 (EN)
BACKLIGHT_EN: U1.105 (GPIO1_IO10), U3.77 (GPIO1_IO07)
BACKLIGHT_PWM: U1.164 (SPDIF_RX/PWM2), U3.75 (GPIO1_IO01)
BOOT_MODE1: SW1.2 (B), U2.17 (BOOT_MODE1)
CLKIN1: U4.45 (CLKIN1)
CLKIN2: U4.53 (CLKIN2)
CLKOUT1: U4.49 (CLKOUT1)
CLKOUT2: U4.57 (CLKOUT2)
DAC_BCLK: U1.170 (SAI2_TXC), U4.67 (SAI2_TXC)
DAC_DIN: U1.166 (SAI2_RXD), U4.65 (SAI2_RXD)
DAC_DOUT: U1.178 (SAI2_TXD), U4.71 (SAI2_TXD)
DAC_MCLK: U1.176 (SAI2_MCLK), U4.61 (SAI2_MCLK)
DAC_RXFS: U1.168 (SAI2_RXFS), U4.73 (SAI2_RXFS)
DAC_SCL: U1.101 (I2C3_SCL), U2.27 (I2C3_SCL)
DAC_SDA: U1.103 (I2C3_SDA), U2.29 (I2C3_SDA)
DAC_TXFS: U1.172 (SAI2_TXFS), U4.75 (SAI2_TXFS)
DSI1_C_N: J1.19, U3.48 (DSI_CK_N)
DSI1_C_P: J1.20, U3.46 (DSI_CK_P)
DSI1_D0_N: J1.25, U3.60 (DSI_D0_N)
DSI1_D0_P: J1.26, U3.58 (DSI_D0_P)
DSI1_D1_N: J1.22, U3.54 (DSI_D1_N)
DSI1_D1_P: J1.23, U3.52 (DSI_D1_P)
DSI1_D2_N: J1.16, U3.42 (DSI_D2_N)
DSI1_D2_P: J1.17, U3.40 (DSI_D2_P)
DSI1_D3_N: J1.13, U3.36 (DSI_D3_N)
DSI1_D3_P: J1.14, U3.34 (DSI_D3_P)
EDP_IRQ: U1.40 (WL_IRQ)
EDP_RESETn: U1.38 (WL_EN), U3.81 (GPIO1_IO04)
EDP_SCL: U1.107 (I2C4_SCL), U2.31 (I2C4_SCL)
EDP_SDA: U1.109 (I2C4_SDA), U2.33 (I2C4_SDA)
ETH_LED_LINK: R1.2, R2.2, U1.83 (JTAG_TDO)
ETH_LED_RX: U1.79 (JTAG_MOD), U4.95 (RGMII_ACT)
GND: C1.2, H1.1, H2.1, H3.1, J1.1, J1.2, J1.12, J1.15, J1.18, J1.21, J1.24, J1.27, J1.30, J2.1, U1.7 (GND), U1.13 (GND), U1.19 (GND), U1.25 (GND), U1.31 (GND), U1.41 (GND), U1.44 (GND), U1.47 (GND), U1.50 (GND), U1.53 (GND), U1.56 (GND), U1.59 (GND), U1.62 (GND), U1.65 (GND), U1.68 (GND), U1.71 (GND), U1.74 (GND), U1.80 (GND), U1.94 (GND), U1.95 (GND), U1.98 (GND), U1.99 (GND), U1.104 (GND), U1.110 (GND), U1.111 (GND), U1.116 (GND), U1.117 (GND), U1.161 (GND), U1.167 (GND), U1.173 (GND), U1.179 (GND), U1.185 (GND), U1.191 (GND), U2.11 (GND), U2.12 (GND), U2.13 (GND), U2.14 (GND), U2.15 (GND), U2.16 (GND), U2.25 (GND), U2.32 (GND), U2.39 (GND), U2.42 (GND), U2.43 (GND), U2.46 (GND), U2.53 (GND), U2.59 (GND), U2.63 (GND), U2.66 (GND), U2.70 (GND), U2.75 (GND), U2.78 (GND), U2.81 (GND), U2.82 (GND), U2.87 (GND), U2.88 (GND), U2.92 (GND), U2.93 (GND), U2.99 (GND), U2.100 (GND), U3.1 (GND), U3.2 (GND), U3.7 (GND), U3.8 (GND), U3.13 (GND), U3.14 (GND), U3.19 (GND), U3.20 (GND), U3.25 (GND), U3.26 (GND), U3.31 (GND), U3.32 (GND), U3.37 (GND), U3.38 (GND), U3.43 (GND), U3.44 (GND), U3.49 (GND), U3.50 (GND), U3.55 (GND), U3.56 (GND), U3.61 (GND), U3.62 (GND), U3.67 (GND), U3.68 (GND), U3.74 (GND), U3.80 (GND), U3.86 (GND), U3.89 (GND), U3.95 (GND), U3.96 (GND), U4.1 (GND), U4.2 (GND), U4.7 (GND), U4.8 (GND), U4.13 (GND), U4.14 (GND), U4.19 (GND), U4.20 (GND), U4.25 (GND), U4.26 (GND), U4.31 (GND), U4.32 (GND), U4.43 (GND), U4.44 (GND), U4.47 (GND), U4.51 (GND), U4.52 (GND), U4.55 (GND), U4.56 (GND), U4.59 (GND), U4.63 (GND), U4.66 (GND), U4.76 (GND), U4.77 (GND), U4.81 (GND), U4.82 (GND), U4.88 (GND), U4.94 (GND), U4.100 (GND), U5.2 (GND)
GPIO1_IO05: U3.97 (GPIO1_IO05)
GPIO1_IO09: U3.90 (GPIO1_IO09)
GPIO1_IO12: U3.87 (GPIO1_IO12)
GPIO1_IO14: U3.93 (GPIO1_IO14)
HDMI_CEC: U1.197 (HDMI_CEC), U2.73 (HDMI_CEC)
HDMI_CLK_N: U1.163 (HDMI_CLK_N), U2.77 (HDMI_TXC_N)
HDMI_CLK_P: U1.165 (HDMI_CLK_P), U2.79 (HDMI_TXC_P)
HDMI_DDC_SCL: U1.195 (HDMI_DDC_SCL), U2.67 (HDMI_DDC_SCL)
HDMI_DDC_SDA: U1.193 (HDMI_DDC_SDA), U2.69 (HDMI_DDC_SDA)
HDMI_HPD: U1.199 (HDMI_HPD), U2.71 (HDMI_HPD)
HDMI_TX0_N: U1.169 (HDMI_TX0_N), U2.83 (HDMI_TX0_N)
HDMI_TX0_P: U1.171 (HDMI_TX0_P), U2.85 (HDMI_TX0_P)
HDMI_TX1_N: U1.175 (HDMI_TX1_N), U2.89 (HDMI_TX1_N)
HDMI_TX1_P: U1.177 (HDMI_TX1_P), U2.91 (HDMI_TX1_P)
HDMI_TX2_N: U1.181 (HDMI_TX2_N), U2.95 (HDMI_TX2_N)
HDMI_TX2_P: U1.183 (HDMI_TX2_P), U2.97 (HDMI_TX2_P)
IMX_RESETn: R7.2, U1.87 (EXT_RESET_N), U2.19 (SYS_RESETn)
LPC_MISO: U1.93 (ECSPI2_MISO), U2.74 (ECSPI2_MISO)
LPC_MOSI: U1.91 (ECSPI2_MOSI), U2.72 (ECSPI2_MOSI)
LPC_SCK: U1.97 (ECSPI2_SCLK), U2.80 (ECSPI2_SCLK)
LPC_SSO: U1.89 (ECSPI2_SS0), U2.76 (ECSPI2_CS0)
LPC_UART_RX: U1.30 (UART3_TXD), U2.94 (UART3_TXD/ECSPI1_MOSI)
LPC_UART_TX: U1.32 (UART3_RXD), U2.90 (UART3_RXD/ECSPI1_SCLK)
unnamed: J2.2, U4.42 (JTAG_TCK)
unnamed: J2.3, U4.40 (JTAG_TDI)
unnamed: J2.4, U4.38 (JTAG_TMS)
unnamed: J2.5, U4.36 (JTAG_MOD)
unnamed: J2.6, U4.34 (JTAG_TDO)
unnamed: R1.1, U4.97 (RGMII_1000)
unnamed: R2.1, U4.99 (RGMII_10/100)
unnamed: R4.2, U4.46 (SD1_STROBE)
unnamed: R5.1, U1.100 (USB1_D_N)
unnamed: R6.1, U1.102 (USB1_D_P)
unnamed: TP1.1, U3.66 (USB1_ID)
unnamed: TP2.1, U3.71 (USB2_ID)
unnamed: TP3.1, U4.35 (ONOFF)
unnamed: TP4.1, U4.33 (PMIC_ON_REQ)
PCIE1_CLK_N: U1.60 (PCIE1_REFCLK_N), U3.35 (PCIE_REFCLK_N)
PCIE1_CLK_P: U1.58 (PCIE1_REFCLK_P), U3.33 (PCIE_REFCLK_P)
PCIE1_RX_N: U1.54 (PCIE1_RX_N), U3.47 (PCIE_RX_N)
PCIE1_RX_P: U1.52 (PCIE1_RX_P), U3.45 (PCIE_RX_P)
PCIE1_TX_N: U1.48 (PCIE1_TX_N), U3.41 (PCIE_TX_N)
PCIE1_TX_P: U1.46 (PCIE1_TX_P), U3.39 (PCIE_TX_P)
PCIE2_CLK_N: U1.78 (PCIE2_RX_N)
PCIE2_CLK_P: U1.76 (PCIE2_RX_P)
PCIE2_RX_N: U1.72 (PCIE2_TX_N)
PCIE2_RX_P: U1.70 (PCIE2_TX_P)
PCIE2_TX_N: U1.66 (PCIE2_REFCLK_N)
PCIE2_TX_P: U1.64 (PCIE2_REFCLK_P)
PCIE_RESETn: U1.24 (WIFI_RESET), U3.73 (GPIO1_IO11)
RTC_IRQ: U1.141 (RTC_IRQ)
SD2_CD: R4.1, U1.26 (SD2_CD)
SD2_CLK: U1.22 (SD2_CLK), U4.54 (SD1_CLK)
SD2_CMD: U1.20 (SD2_CMD), U4.50 (SD1_CMD)
SD2_DATA0: U1.12 (SD2_DATA0), U4.58 (SD1_DATA0)
SD2_DATA1: U1.14 (SD2_DATA1), U4.60 (SD1_DATA1)
SD2_DATA2: U1.16 (SD2_DATA2), U4.62 (SD1_DATA2)
SD2_DATA3: U1.18 (SD2_DATA3), U4.64 (SD1_DATA3)
SD2_DATA4: U4.68 (SD1_DATA4)
SD2_DATA5: U4.70 (SD1_DATA5)
SD2_DATA6: U4.72 (SD1_DATA6)
SD2_DATA7: U4.74 (SD1_DATA7)
SD2_RESET: U4.48 (SD1_RESET_B)
SOC_WAKE: U1.145 (GPIO1_IO3), U3.99 (GPIO1_IO06)
TRX0_N: U1.27 (TRX0_N), U4.80 (TRX0_N)
TRX0_P: U1.29 (TRX0_P), U4.78 (TRX0_P)
TRX1_N: U1.21 (TRX1_N), U4.86 (TRX1_N)
TRX1_P: U1.23 (TRX1_P), U4.84 (TRX1_P)
TRX2_N: U1.15 (TRX2_N), U4.92 (TRX2_N)
TRX2_P: U1.17 (TRX2_P), U4.90 (TRX2_P)
TRX3_N: U1.9 (TRX3_N), U4.98 (TRX3_N)
TRX3_P: U1.11 (TRX3_P), U4.96 (TRX3_P)
UART1_RX: U1.126 (UART1_RXD), U3.100 (UART4_RXD)
UART1_TX: U1.128 (UART1_TXD), U3.98 (UART4_TXD)
UART2_RX: U1.122 (UART2_RXD), U3.94 (UART2_RXD)
UART2_TX: U1.124 (UART2_TXD), U3.92 (UART2_TXD)
USB1_N: R5.2, U3.84 (USB1_D_N)
USB1_P: R6.2, U3.82 (USB1_D_P)
USB1_RX_N: U1.112 (USB1_RX_N), U3.78 (USB1_RX_N)
USB1_RX_P: U1.114 (USB1_RX_P), U3.76 (USB1_RX_P)
USB1_TX_N: U1.106 (USB1_TX_N), U3.72 (USB1_TX_N)
USB1_TX_P: U1.108 (USB1_TX_P), U3.70 (USB1_TX_P)
USB1_VBUS_3V3: R3.2, SW1.1 (A), U3.64 (USB1_VBUS_3V3), U3.69 (USB2_VBUS_3V3)
USB2_N: U1.125 (USB2_D_N), U3.65 (USB2_D_N)
USB2_P: U1.127 (USB2_D_P), U3.63 (USB2_D_P)
USB2_RX_N: U1.121 (USB2_RX_N), U3.59 (USB2_RX_N)
USB2_RX_P: U1.119 (USB2_RX_P), U3.57 (USB2_RX_P)
USB2_TX_N: U1.115 (USB2_TX_N), U3.53 (USB2_TX_N)
USB2_TX_P: U1.113 (USB2_TX_P), U3.51 (USB2_TX_P)
USB_HUB_RESET: U1.131 (USB_HUB_RESET), U3.83 (GPIO1_IO10)
USB_VBUS: U1.118 (USB1_VBUS)
XSWITCH: U1.139 (FAST_BOOT), U3.88 (GPIO1_IO08)

Notes on the sheet:
J4 on SOM, J8 on ENC
3v3 pulls on MB
OPTIONAL
imx gpios
1v8 pulls on MB
J8 on SOM, J33 on ENC
??????
TODO
J5 on SOM, J2 on ENC
Sourcing +3V3 power (only used for PUs) from RESET PU on MB
TODO for MREF: pcie switch PI7C9X2G304SV

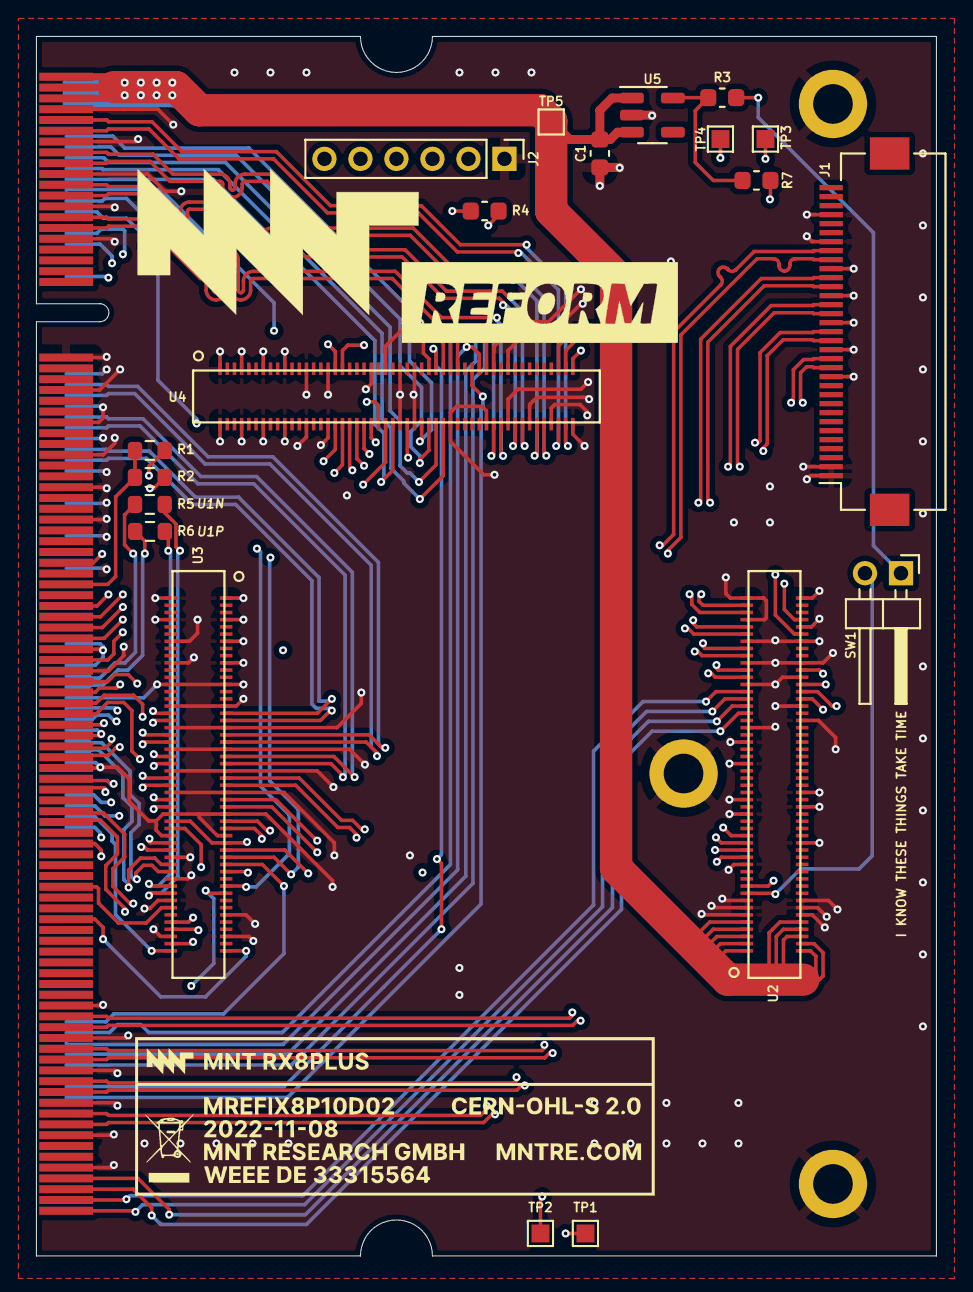
[picture p49: board reform2-imx8mplus.kicad_pcb from above]

Board: 6 copper layers, 50.0 x 67.8 mm, 26 parts (0 on the bottom side), 104 nets.
