jackhumbert/reform/reform2-motherboard25-pcb/reform2-motherboard25.kicad_pcb

## KiCad design reform2-motherboard25-pcb/reform2-motherboard25.kicad_pcb (2022-10-14)

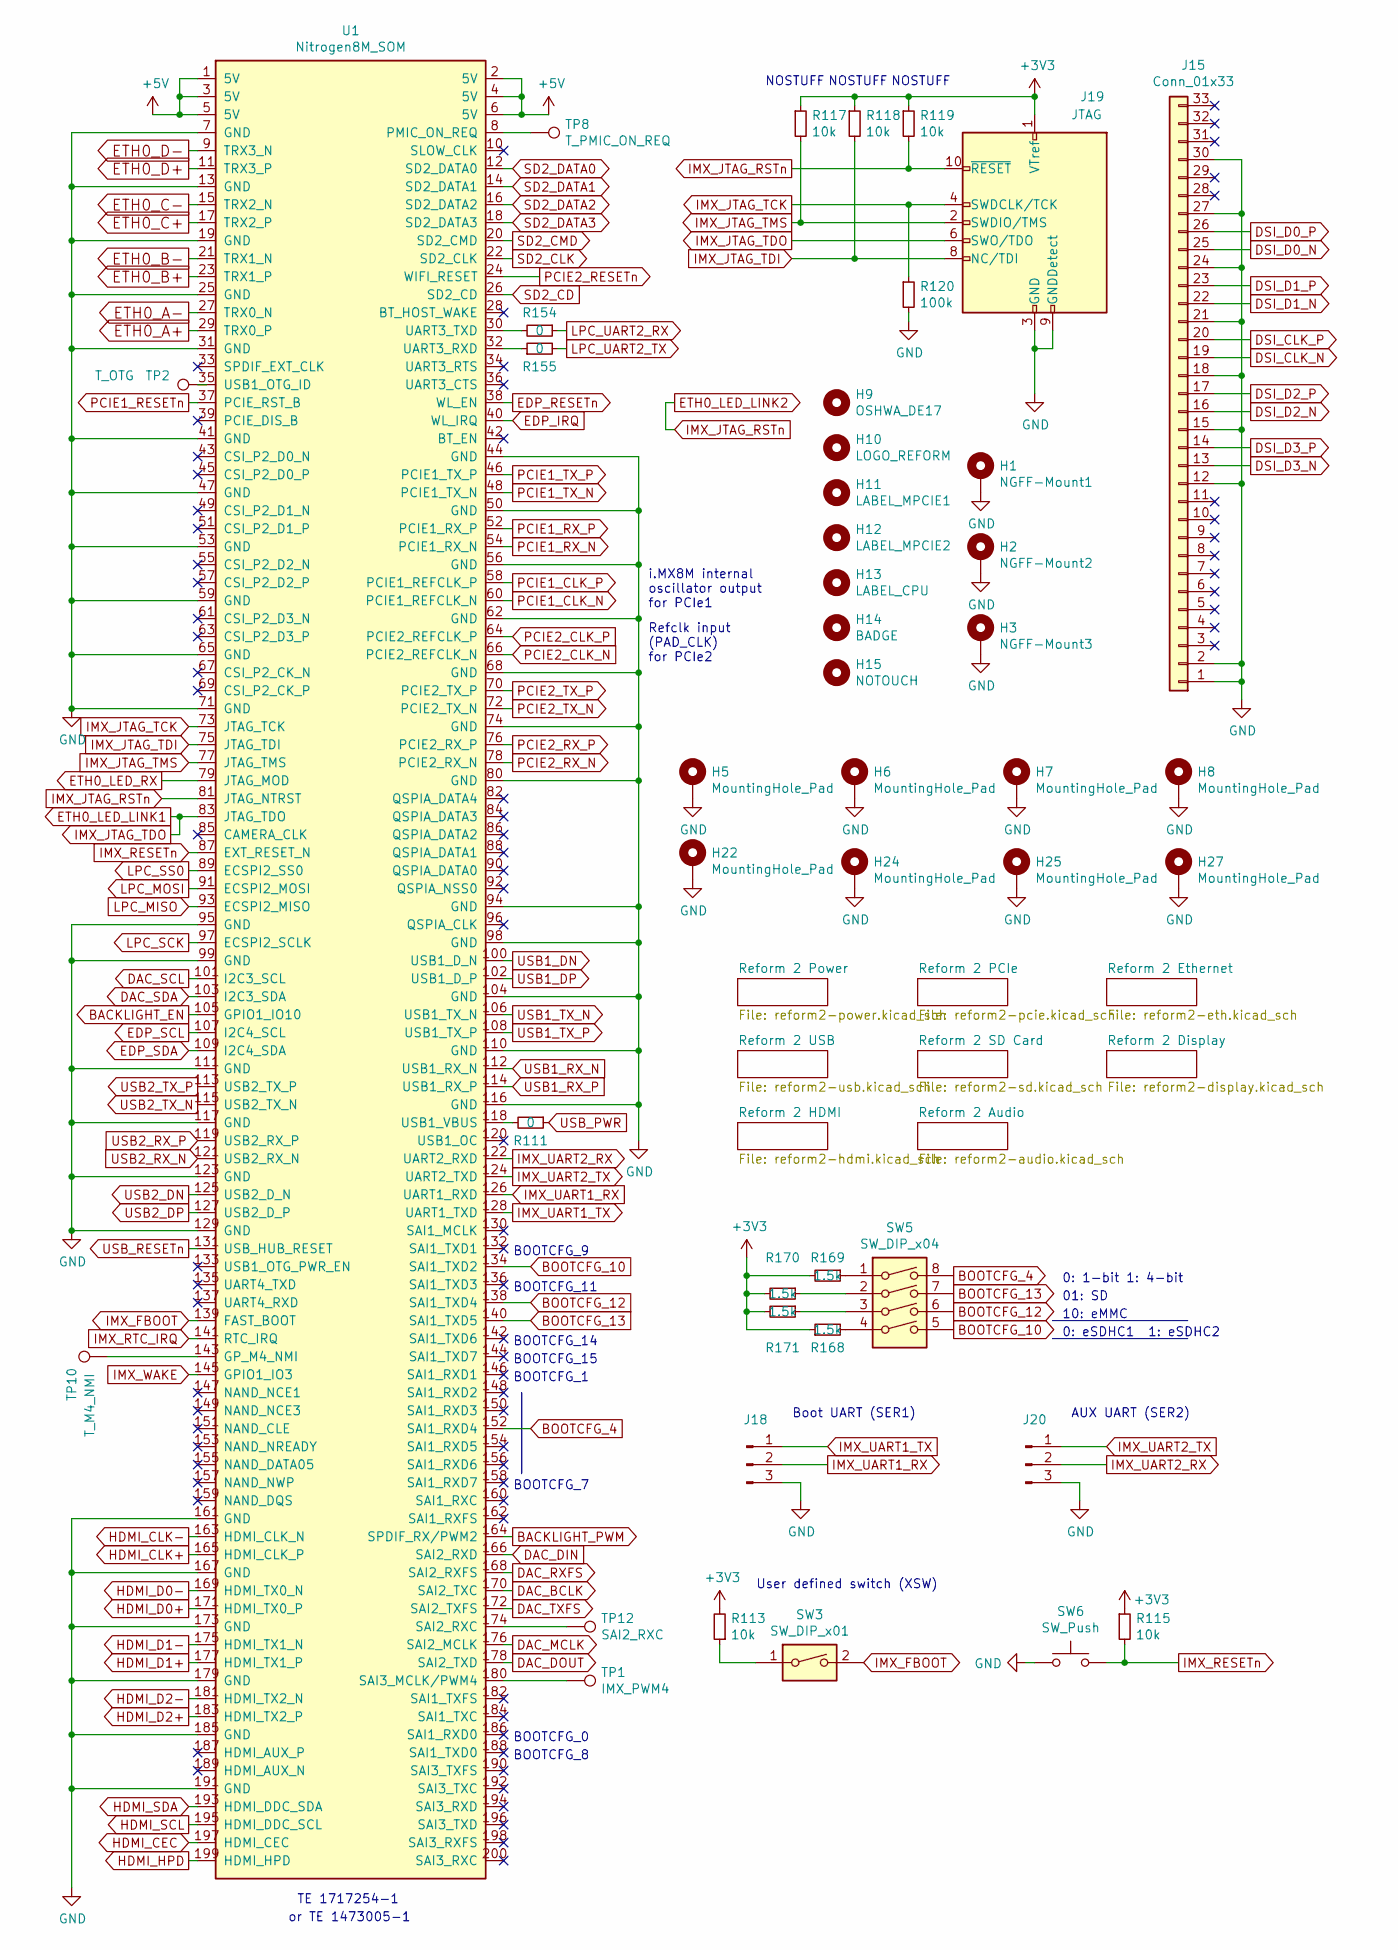
[picture p50: schematic reform2-motherboard25.kicad_sch, MNT Reform 2]

Parts:
H1: NGFF-Mount1; WA-SMSI-M2
H2: NGFF-Mount2; WA-SMSI-M2
H3: NGFF-Mount3; WA-SMSI-M2
H5, H6, H7, H8: MountingHole_Pad; MountingHole_2.2mm_M2_DIN965_Pad
H9: OSHWA_DE17; oshwa-de17
H10: LOGO_REFORM; mntreform
H11: LABEL_MPCIE1; mpcie
H12: LABEL_MPCIE2; nvme
H13: LABEL_CPU; cpu
H14: BADGE; reform2-motherboard-badge
H15: NOTOUCH; ESD-Logo_8.9x8mm_SilkScreen
H22, H24, H25, H27: MountingHole_Pad; WA-SMSI-M2
J15: Conn_01x33; Hirose_FH12-33S-0.5SH_1x33-1MP_P0.50mm_Horizontal
J18: Conn_01x03_Male; PinHeader_1x03_P2.54mm_Horizontal
J19: JTAG; PinHeader_2x05_P1.27mm_Vertical
J20: Conn_01x03_Male; PinHeader_1x03_P2.54mm_Vertical
R111, R154, R155: 0; R_0603_1608Metric
R113, R115, R117, R118, R119: 10k; R_0603_1608Metric
R120: 100k; R_0603_1608Metric
R168, R169, R170, R171: 1.5k; R_0603_1608Metric
SW3: SW_DIP_x01; SW_DIP_SPSTx01_Slide_Omron_A6S-110x_W8.9mm_P2.54mm
SW5: SW_DIP_x04; SW_DIP_SPSTx04_Slide_Copal_CHS-04B_W7.62mm_P1.27mm
SW6: SW_Push; UK-B0206-G3.8-250-JZ
TP1: IMX_PWM4; TestPoint_Pad_D1.0mm
TP2: T_OTG; TestPoint_Pad_D1.0mm
TP8: T_PMIC_ON_REQ; TestPoint_Pad_D1.0mm
TP10: T_M4_NMI; TestPoint_Pad_D1.0mm
TP12: SAI2_RXC; TestPoint_Pad_D1.0mm
U1: Nitrogen8M_SOM; TE_1473149-4

Connections:
+3V3: J19.1 (VTref), R113.2, R115.1, R117.1, R118.1, R119.1, R168.1, R169.2, R170.2, R171.2; also elsewhere on the board
+5V: U1.1 (5V), U1.2 (5V), U1.3 (5V), U1.4 (5V), U1.5 (5V), U1.6 (5V); also elsewhere on the board
BACKLIGHT_EN: U1.105 (GPIO1_IO10); also elsewhere on the board
BACKLIGHT_PWM: U1.164 (SPDIF_RX/PWM2); also elsewhere on the board
BOOTCFG_4: SW5.8, U1.152 (SAI1_RXD4)
BOOTCFG_10: SW5.5, U1.134 (SAI1_TXD2)
BOOTCFG_12: SW5.6, U1.138 (SAI1_TXD4)
BOOTCFG_13: SW5.7, U1.140 (SAI1_TXD5)
DAC_BCLK: U1.170 (SAI2_TXC); also elsewhere on the board
DAC_DIN: U1.166 (SAI2_RXD); also elsewhere on the board
DAC_DOUT: U1.178 (SAI2_TXD); also elsewhere on the board
DAC_MCLK: U1.176 (SAI2_MCLK); also elsewhere on the board
DAC_RXFS: U1.168 (SAI2_RXFS); also elsewhere on the board
DAC_SCL: U1.101 (I2C3_SCL); also elsewhere on the board
DAC_SDA: U1.103 (I2C3_SDA); also elsewhere on the board
DAC_TXFS: U1.172 (SAI2_TXFS); also elsewhere on the board
DSI_CLK_N: J15.19; also elsewhere on the board
DSI_CLK_P: J15.20; also elsewhere on the board
DSI_D0_N: J15.25; also elsewhere on the board
DSI_D0_P: J15.26; also elsewhere on the board
DSI_D1_N: J15.22; also elsewhere on the board
DSI_D1_P: J15.23; also elsewhere on the board
DSI_D2_N: J15.16; also elsewhere on the board
DSI_D2_P: J15.17; also elsewhere on the board
DSI_D3_N: J15.13; also elsewhere on the board
DSI_D3_P: J15.14; also elsewhere on the board
EDP_IRQ: U1.40 (WL_IRQ); also elsewhere on the board
EDP_RESETn: U1.38 (WL_EN); also elsewhere on the board
EDP_SCL: U1.107 (I2C4_SCL); also elsewhere on the board
EDP_SDA: U1.109 (I2C4_SDA); also elsewhere on the board
ETH0_A+: U1.29 (TRX0_P); also elsewhere on the board
ETH0_A-: U1.27 (TRX0_N); also elsewhere on the board
ETH0_B+: U1.23 (TRX1_P); also elsewhere on the board
ETH0_B-: U1.21 (TRX1_N); also elsewhere on the board
ETH0_C+: U1.17 (TRX2_P); also elsewhere on the board
ETH0_C-: U1.15 (TRX2_N); also elsewhere on the board
ETH0_D+: U1.11 (TRX3_P); also elsewhere on the board
ETH0_D-: U1.9 (TRX3_N); also elsewhere on the board
ETH0_LED_LINK1: J19.6 (SWO/TDO), U1.83 (JTAG_TDO); also elsewhere on the board
ETH0_LED_LINK2: J19.10 (~RESET), R119.2, U1.81 (JTAG_NTRST); also elsewhere on the board
ETH0_LED_RX: U1.79 (JTAG_MOD); also elsewhere on the board
GND: H1.1, H2.1, H3.1, H5.1, H6.1, H7.1, H8.1, H22.1, H24.1, H25.1, H27.1, J15.1, J15.2, J15.12, J15.15, J15.18, J15.21, J15.24, J15.27, J15.30, J18.3, J19.3 (GND), J19.5 (GND), J19.9 (GNDDetect), J20.3, R120.2, SW6.1, U1.7 (GND), U1.13 (GND), U1.19 (GND), U1.25 (GND), U1.31 (GND), U1.41 (GND), U1.44 (GND), U1.47 (GND), U1.50 (GND), U1.53 (GND), U1.56 (GND), U1.59 (GND), U1.62 (GND), U1.65 (GND), U1.68 (GND), U1.71 (GND), U1.74 (GND), U1.80 (GND), U1.94 (GND), U1.95 (GND), U1.98 (GND), U1.99 (GND), U1.104 (GND), U1.110 (GND), U1.111 (GND), U1.116 (GND), U1.117 (GND), U1.123 (GND), U1.129 (GND), U1.161 (GND), U1.167 (GND), U1.173 (GND), U1.179 (GND), U1.185 (GND), U1.191 (GND); also elsewhere on the board
HDMI_CEC: U1.197 (HDMI_CEC); also elsewhere on the board
HDMI_CLK+: U1.165 (HDMI_CLK_P); also elsewhere on the board
HDMI_CLK-: U1.163 (HDMI_CLK_N); also elsewhere on the board
HDMI_D0+: U1.171 (HDMI_TX0_P); also elsewhere on the board
HDMI_D0-: U1.169 (HDMI_TX0_N); also elsewhere on the board
HDMI_D1+: U1.177 (HDMI_TX1_P); also elsewhere on the board
HDMI_D1-: U1.175 (HDMI_TX1_N); also elsewhere on the board
HDMI_D2+: U1.183 (HDMI_TX2_P); also elsewhere on the board
HDMI_D2-: U1.181 (HDMI_TX2_N); also elsewhere on the board
HDMI_HPD: U1.199 (HDMI_HPD); also elsewhere on the board
HDMI_SCL: U1.195 (HDMI_DDC_SCL); also elsewhere on the board
HDMI_SDA: U1.193 (HDMI_DDC_SDA); also elsewhere on the board
IMX_FBOOT: SW3.2, U1.139 (FAST_BOOT)
IMX_JTAG_TCK: J19.4 (SWDCLK/TCK), R120.1, U1.73 (JTAG_TCK)
IMX_JTAG_TDI: J19.8 (NC/TDI), R118.2, U1.75 (JTAG_TDI)
IMX_JTAG_TMS: J19.2 (SWDIO/TMS), R117.2, U1.77 (JTAG_TMS)
IMX_RESETn: R115.2, SW6.2, U1.87 (EXT_RESET_N); also elsewhere on the board
IMX_RTC_IRQ: U1.141 (RTC_IRQ); also elsewhere on the board
IMX_UART1_RX: J18.2, U1.126 (UART1_RXD)
IMX_UART1_TX: J18.1, U1.128 (UART1_TXD)
IMX_UART2_RX: J20.2, U1.122 (UART2_RXD)
IMX_UART2_TX: J20.1, U1.124 (UART2_TXD)
IMX_WAKE: U1.145 (GPIO1_IO3); also elsewhere on the board
LPC_MISO: U1.93 (ECSPI2_MISO); also elsewhere on the board
LPC_MOSI: U1.91 (ECSPI2_MOSI); also elsewhere on the board
LPC_SCK: U1.97 (ECSPI2_SCLK); also elsewhere on the board
LPC_SS0: U1.89 (ECSPI2_SS0); also elsewhere on the board
LPC_UART2_RX: R154.1; also elsewhere on the board
LPC_UART2_TX: R155.2; also elsewhere on the board
unnamed: R111.2, U1.118 (USB1_VBUS)
unnamed: R113.1, SW3.1
unnamed: R154.2, U1.30 (UART3_TXD)
unnamed: R155.1, U1.32 (UART3_RXD)
unnamed: R168.2, SW5.4
unnamed: R169.1, SW5.1
unnamed: R170.1, SW5.2
unnamed: R171.1, SW5.3
unnamed: TP1.1, U1.180 (SAI3_MCLK/PWM4)
unnamed: TP2.1, U1.35 (USB1_OTG_ID)
unnamed: TP8.1, U1.8 (PMIC_ON_REQ)
unnamed: TP10.1, U1.143 (GP_M4_NMI)
unnamed: TP12.1, U1.174 (SAI2_RXC)
PCIE1_CLK_N: U1.60 (PCIE1_REFCLK_N); also elsewhere on the board
PCIE1_CLK_P: U1.58 (PCIE1_REFCLK_P); also elsewhere on the board
PCIE1_RESETn: U1.37 (PCIE_RST_B); also elsewhere on the board
PCIE1_RX_N: U1.54 (PCIE1_RX_N); also elsewhere on the board
PCIE1_RX_P: U1.52 (PCIE1_RX_P); also elsewhere on the board
PCIE1_TX_N: U1.48 (PCIE1_TX_N); also elsewhere on the board
PCIE1_TX_P: U1.46 (PCIE1_TX_P); also elsewhere on the board
PCIE2_CLK_N: U1.66 (PCIE2_REFCLK_N); also elsewhere on the board
PCIE2_CLK_P: U1.64 (PCIE2_REFCLK_P); also elsewhere on the board
PCIE2_RESETn: U1.24 (WIFI_RESET); also elsewhere on the board
PCIE2_RX_N: U1.78 (PCIE2_RX_N); also elsewhere on the board
PCIE2_RX_P: U1.76 (PCIE2_RX_P); also elsewhere on the board
PCIE2_TX_N: U1.72 (PCIE2_TX_N); also elsewhere on the board
PCIE2_TX_P: U1.70 (PCIE2_TX_P); also elsewhere on the board
SD2_CD: U1.26 (SD2_CD); also elsewhere on the board
SD2_CLK: U1.22 (SD2_CLK); also elsewhere on the board
SD2_CMD: U1.20 (SD2_CMD); also elsewhere on the board
SD2_DATA0: U1.12 (SD2_DATA0); also elsewhere on the board
SD2_DATA1: U1.14 (SD2_DATA1); also elsewhere on the board
SD2_DATA2: U1.16 (SD2_DATA2); also elsewhere on the board
SD2_DATA3: U1.18 (SD2_DATA3); also elsewhere on the board
USB1_DN: U1.100 (USB1_D_N); also elsewhere on the board
USB1_DP: U1.102 (USB1_D_P); also elsewhere on the board
USB1_RX_N: U1.112 (USB1_RX_N)
USB1_RX_P: U1.114 (USB1_RX_P)
USB1_TX_N: U1.106 (USB1_TX_N)
USB1_TX_P: U1.108 (USB1_TX_P)
USB2_DN: U1.125 (USB2_D_N); also elsewhere on the board
USB2_DP: U1.127 (USB2_D_P); also elsewhere on the board
USB2_RX_N: U1.121 (USB2_RX_N); also elsewhere on the board
USB2_RX_P: U1.119 (USB2_RX_P); also elsewhere on the board
USB2_TX_N: U1.115 (USB2_TX_N); also elsewhere on the board
USB2_TX_P: U1.113 (USB2_TX_P); also elsewhere on the board
USB_PWR: R111.1; also elsewhere on the board
USB_RESETn: U1.131 (USB_HUB_RESET); also elsewhere on the board

Notes on the sheet:
NOSTUFF
01: SD
BOOTCFG_7
BOOTCFG_0
10: eMMC
TE 1717254-1
BOOTCFG_9
Boot UART (SER1)
User defined switch (XSW)
BOOTCFG_14
BOOTCFG_15
0: 1-bit 1: 4-bit
BOOTCFG_1
BOOTCFG_11
BOOTCFG_8
i.MX8M internal oscillator output for PCIe1
Refclk input (PAD_CLK) for PCIe2
or TE 1473005-1
AUX UART (SER2)
0: eSDHC1 1: eSDHC2
