jackhumbert/reform/reform2-motherboard25-pcb/reform2-motherboard25.kicad_pcb

## KiCad design reform2-motherboard25-pcb/reform2-motherboard25.kicad_pcb (continued)

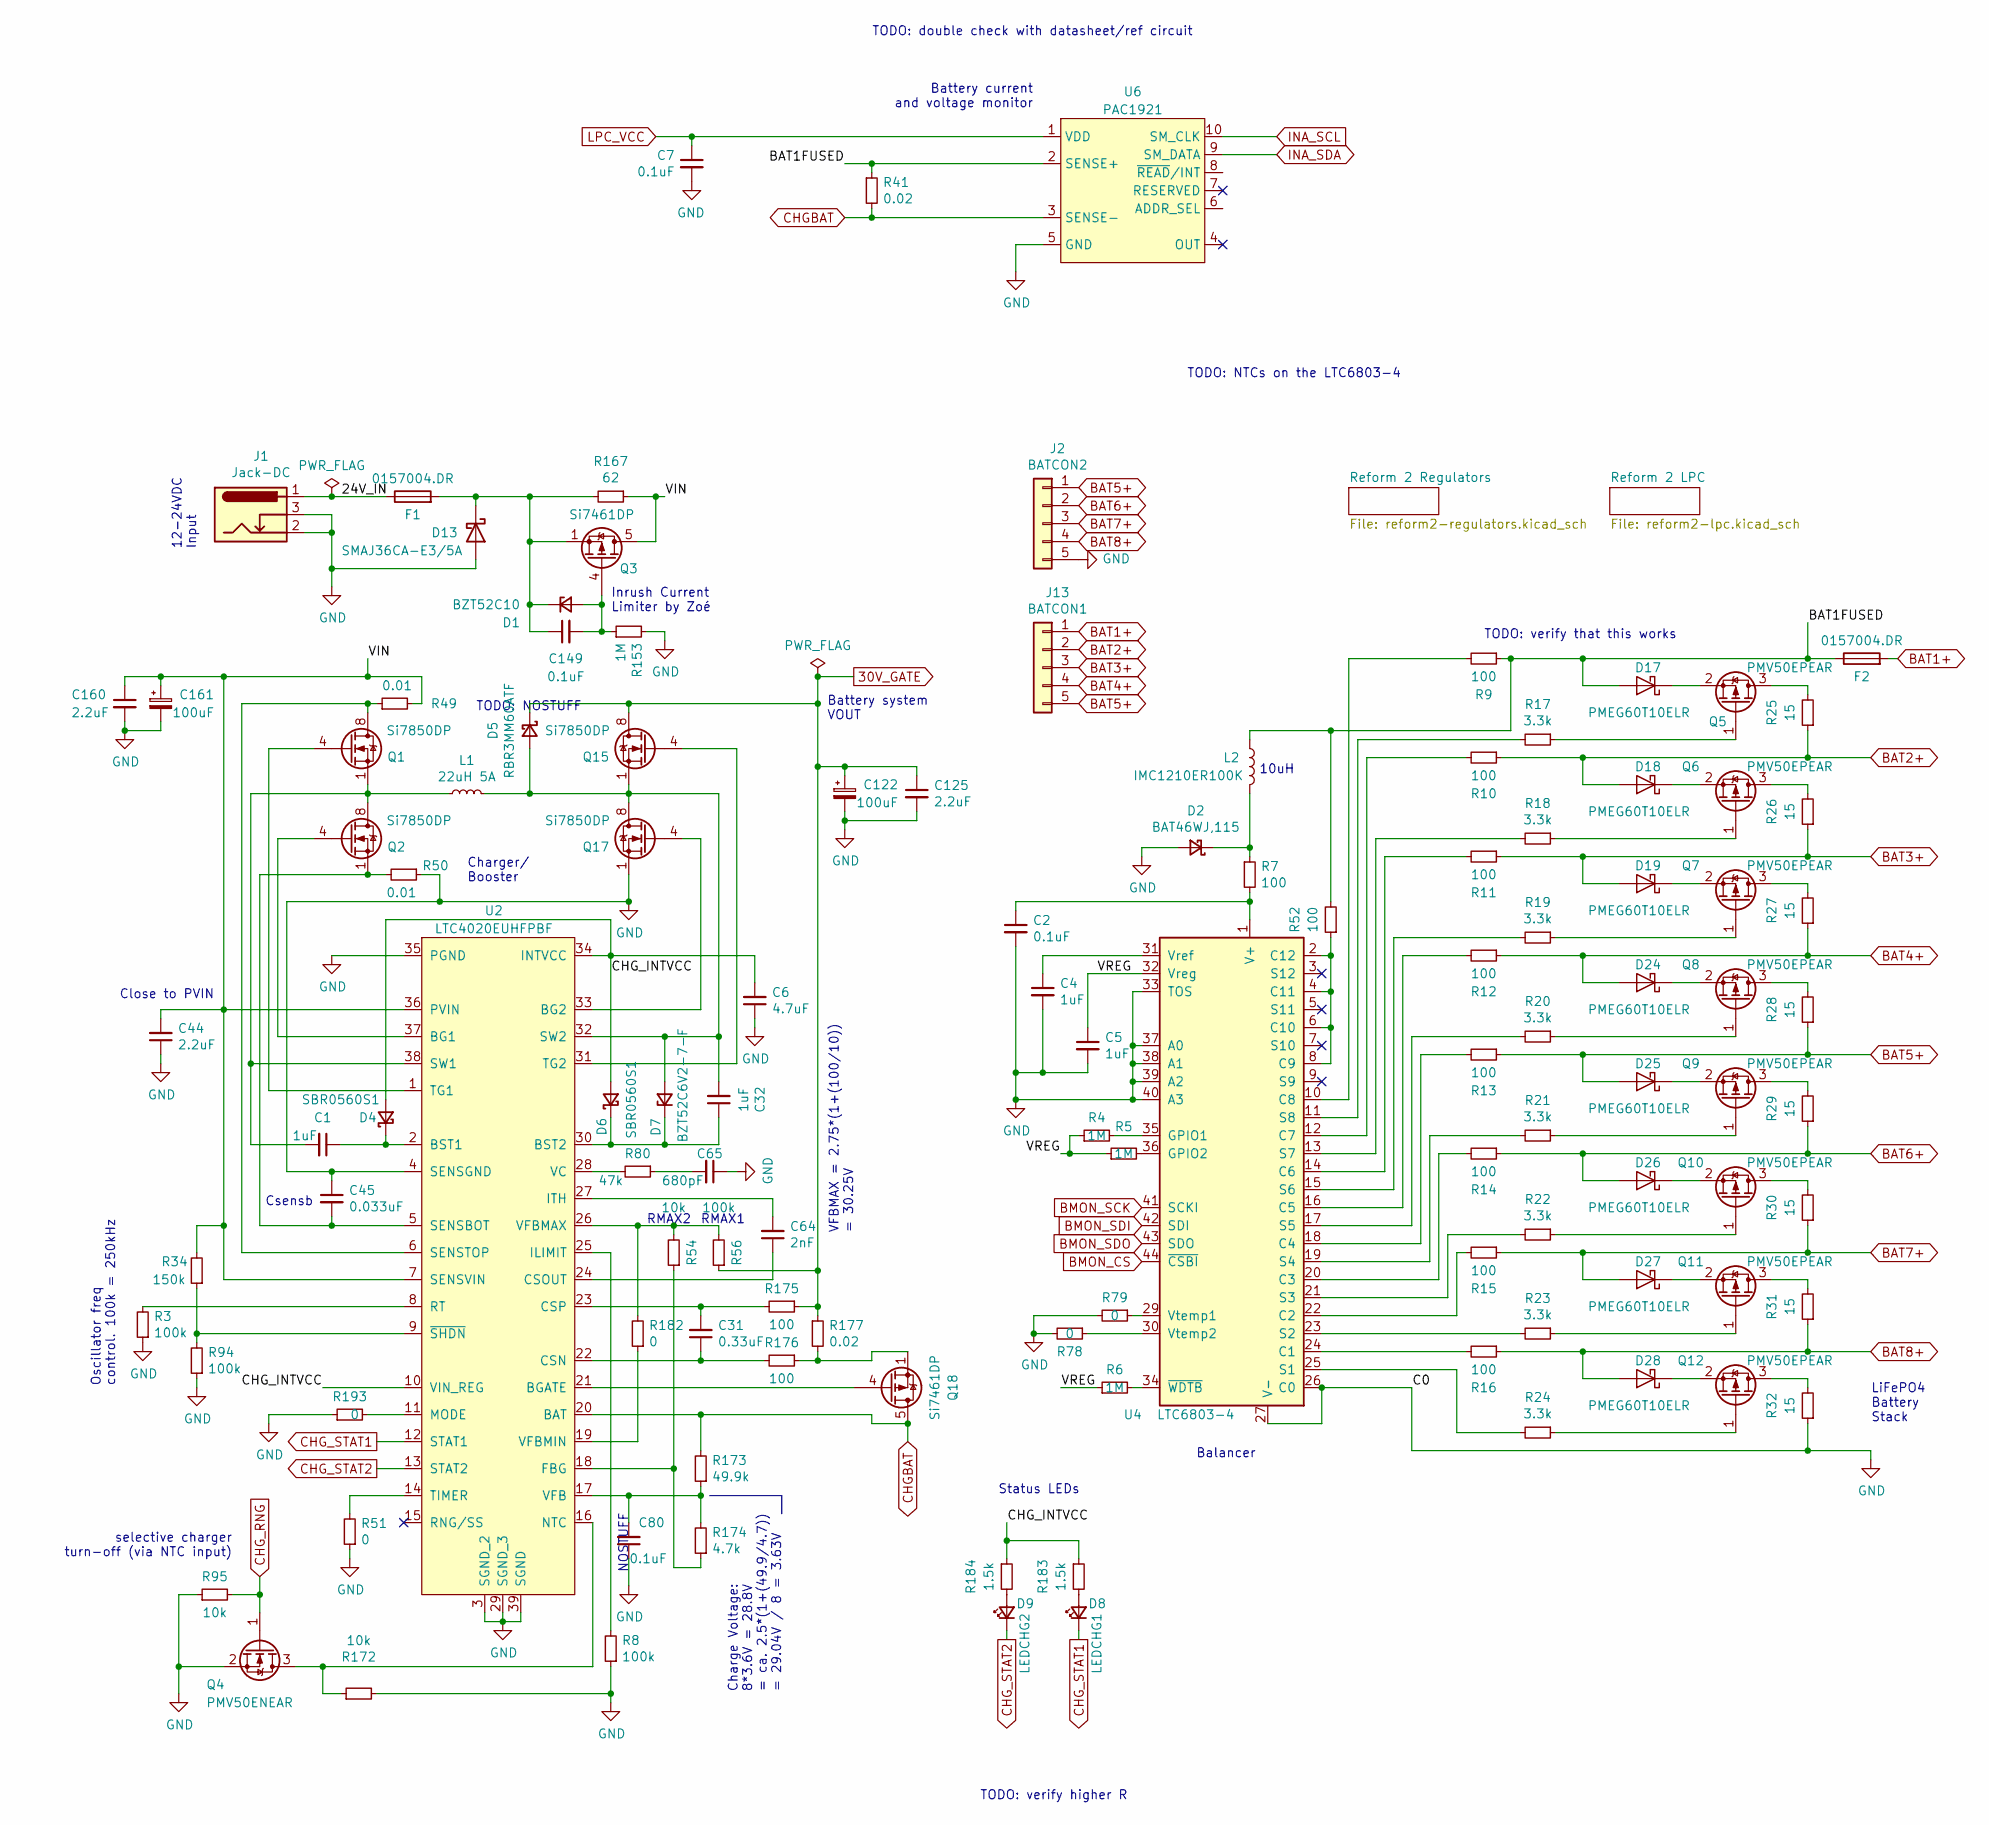
[picture p51: schematic reform2-power.kicad_sch, MNT Reform 2 Power System]

Parts:
C1, C4, C5, C32: 1uF; C_0603_1608Metric
C2, C7, C80, C149: 0.1uF; C_0603_1608Metric
C6: 4.7uF; C_0603_1608Metric
C31: 0.33uF; C_0603_1608Metric
C44, C125, C160: 2.2uF; C_0603_1608Metric
C45: 0.033uF; C_0603_1608Metric
C64: 2nF; C_0603_1608Metric
C65: 680pF; C_0603_1608Metric
C122, C161: 100uF; CP_Elec_6.3x7.7
D1: BZT52C10; D_SOD-123
D2: BAT46WJ,115; D_SOD-323
D4, D6: SBR0560S1; D_SOD-123
D5: RBR3MM60ATF; D_SOD-123
D7: BZT52C6V2-7-F; D_SOD-123
D8: LEDCHG1; LED_0603_1608Metric
D9: LEDCHG2; LED_0603_1608Metric
D13: SMAJ36CA-E3/5A; D_SMA
D17, D18, D19, D24, D25, D26, D27, D28: PMEG60T10ELR; Nexperia_CFP3_SOD-123W
F1, F2: 0157004.DR; fuse_smf
J1: Jack-DC; SWC_RAPC712X
J2: BATCON2; Molex_Pico-Lock_504050-0591_1x05-1MP_P1.50mm_Horizontal
J13: BATCON1; Molex_Pico-Lock_504050-0591_1x05-1MP_P1.50mm_Horizontal
L1: 22uH 5A; L_12x12mm_H6mm
L2: IMC1210ER100K; L_1210_3225Metric
Q1, Q2, Q15, Q17: Si7850DP; PowerPAK_SO-8_Single_8Pads
Q3, Q18: Si7461DP; PowerPAK_SO-8_Single_8Pads
Q4: PMV50ENEAR; SOT-23
Q5, Q6, Q7, Q8, Q9, Q10, Q11, Q12: PMV50EPEAR; SOT-23
R3, R8, R56, R94: 100k; R_0603_1608Metric
R4, R5, R6, R153: 1M; R_0603_1608Metric
R7, R9, R10, R11, R12, R13, R14, R15, R16, R52, R175, R176: 100; R_0603_1608Metric
R17, R18, R19, R20, R21, R22, R23, R24: 3.3k; R_0603_1608Metric
R25, R26, R27, R28, R29, R30, R31, R32: 15; R_2512_6332Metric
R34: 150k; R_0603_1608Metric
R41, R177: 0.02; R_0612_1632Metric
R49, R50: 0.01; R_0612_1632Metric
R51, R78, R79, R182, R193: 0; R_0603_1608Metric
R54, R95, R172: 10k; R_0603_1608Metric
R80: 47k; R_0603_1608Metric
R167: 62; R_0603_1608Metric
R173: 49.9k; R_0603_1608Metric
R174: 4.7k; R_0603_1608Metric
R183, R184: 1.5k; R_0603_1608Metric
U2: LTC4020EUHFPBF; QFN-38-1EP_5x7mm_P0.5mm_EP3.15x5.15mm
U4: LTC6803-4; SSOP-44_5.3x12.8mm_P0.5mm
U6: PAC1921

Connections:
30V_GATE: C122.1, C125.1, D5.1 (K), Q15.5 (D), Q15.6 (D), Q15.7 (D), Q15.8 (D), R56.1, R175.1, R177.1; also elsewhere on the board
/Reform 2 Power/24V_IN: F1.1, J1.1
/Reform 2 Power/BAT1FUSED: D17.2 (A), F2.1, L2.1, R9.1, R41.1, R52.2, U6.2 (SENSE+)
/Reform 2 Power/CHG_INTVCC: C6.2, D4.2 (A), D6.2 (A), R183.1, R184.1, U2.10 (VIN_REG), U2.34 (INTVCC)
/Reform 2 Power/VIN: C44.2, C160.1, C161.1, Q3.5 (D), Q3.6 (D), Q3.7 (D), Q3.8 (D), R34.2, R49.2, R167.1, U2.7 (SENSVIN), U2.36 (PVIN)
/Reform 2 Power/VREG: C5.1, R4.1, R5.1, R6.1, U4.32 (Vreg)
BAT1+: F2.2, J13.1
BAT2+: D18.2 (A), J13.2, R10.1, R25.1
BAT3+: D19.2 (A), J13.3, R11.1, R26.1
BAT4+: D24.2 (A), J13.4, R12.1, R27.1
BAT5+: D25.2 (A), J2.1, J13.5, R13.1, R28.1
BAT6+: D26.2 (A), J2.2, R14.1, R29.1
BAT7+: D27.2 (A), J2.3, R15.1, R30.1
BAT8+: D28.2 (A), J2.4, R16.1, R31.1
BMON_CS: U4.44 (~CSBI); also elsewhere on the board
BMON_SCK: U4.41 (SCKI); also elsewhere on the board
BMON_SDI: U4.42 (SDI); also elsewhere on the board
BMON_SDO: U4.43 (SDO); also elsewhere on the board
CHGBAT: Q18.5 (D), Q18.6 (D), Q18.7 (D), Q18.8 (D), R41.2, R173.2, U2.20 (BAT), U6.3 (SENSE-)
CHG_RNG: Q4.1 (G), R95.2; also elsewhere on the board
CHG_STAT1: D8.1 (K), U2.12 (STAT1)
CHG_STAT2: D9.1 (K), U2.13 (STAT2)
GND: C2.2, C4.2, C5.2, C6.1, C7.2, C44.1, C45.1, C65.1, C80.1, C122.2, C125.2, C160.2, C161.2, D2.2 (A), D13.2 (A), J1.2, J1.3, J2.5, Q4.2 (S), Q17.1 (S), Q17.2 (S), Q17.3 (S), R3.1, R8.1, R32.1, R50.1, R51.1, R78.2, R79.2, R94.1, R95.1, R153.2, R172.2, R193.1, U2.3 (SGND_2), U2.4 (SENSGND), U2.29 (SGND_3), U2.35 (PGND), U2.39 (SGND), U4.26 (C0), U4.27 (V-), U4.33 (TOS), U4.37 (A0), U4.38 (A1), U4.39 (A2), U4.40 (A3), U6.5 (GND); also elsewhere on the board
INA_SCL: U6.10 (SM_CLK); also elsewhere on the board
INA_SDA: U6.9 (SM_DATA); also elsewhere on the board
LPC_VCC: C7.1, U6.1 (VDD); also elsewhere on the board
unnamed: C1.1, D4.1 (K), U2.2 (BST1)
unnamed: C1.2, L1.1, Q1.1 (S), Q1.2 (S), Q1.3 (S), Q2.5 (D), Q2.6 (D), Q2.7 (D), Q2.8 (D), U2.38 (SW1)
unnamed: C2.1, R7.2, U4.1 (V+)
unnamed: C4.1, U4.31 (Vref)
unnamed: C31.1, R176.2, U2.22 (CSN)
unnamed: C31.2, R175.2, U2.23 (CSP)
unnamed: C32.1, D6.1 (K), D7.1 (K), U2.30 (BST2)
unnamed: C32.2, D5.2 (A), D7.2 (A), L1.2, Q15.1 (S), Q15.2 (S), Q15.3 (S), Q17.5 (D), Q17.6 (D), Q17.7 (D), Q17.8 (D), U2.32 (SW2)
unnamed: C45.2, Q2.1 (S), Q2.2 (S), Q2.3 (S), R50.2, U2.5 (SENSBOT)
unnamed: C64.1, U2.24 (CSOUT)
unnamed: C64.2, U2.27 (ITH)
unnamed: C65.2, R80.1
unnamed: C80.2, R173.1, R174.2, U2.17 (VFB)
unnamed: C149.1, D1.1 (K), D13.1 (K), F1.2, Q3.1 (S), Q3.2 (S), Q3.3 (S), R167.2
unnamed: C149.2, D1.2 (A), Q3.4 (G), R153.1
unnamed: D2.1 (K), L2.2, R7.1
unnamed: D8.2 (A), R183.2
unnamed: D9.2 (A), R184.2
unnamed: Q1.4 (G), U2.1 (TG1)
unnamed: Q1.5 (D), Q1.6 (D), Q1.7 (D), Q1.8 (D), R49.1, U2.6 (SENSTOP)
unnamed: Q2.4 (G), U2.37 (BG1)
unnamed: Q4.3 (D), R172.1, U2.16 (NTC)
unnamed: Q5.1 (G), R17.1
unnamed: D17.1 (K), Q5.2 (S)
unnamed: Q5.3 (D), R25.2
unnamed: Q6.1 (G), R18.1
unnamed: D18.1 (K), Q6.2 (S)
unnamed: Q6.3 (D), R26.2
unnamed: Q7.1 (G), R19.1
unnamed: D19.1 (K), Q7.2 (S)
unnamed: Q7.3 (D), R27.2
unnamed: Q8.1 (G), R20.1
unnamed: D24.1 (K), Q8.2 (S)
unnamed: Q8.3 (D), R28.2
unnamed: Q9.1 (G), R21.1
unnamed: D25.1 (K), Q9.2 (S)
unnamed: Q9.3 (D), R29.2
unnamed: Q10.1 (G), R22.1
unnamed: D26.1 (K), Q10.2 (S)
unnamed: Q10.3 (D), R30.2
unnamed: Q11.1 (G), R23.1
unnamed: D27.1 (K), Q11.2 (S)
unnamed: Q11.3 (D), R31.2
unnamed: Q12.1 (G), R24.1
unnamed: D28.1 (K), Q12.2 (S)
unnamed: Q12.3 (D), R32.2
unnamed: Q15.4 (G), U2.31 (TG2)
unnamed: Q17.4 (G), U2.33 (BG2)
unnamed: Q18.1 (S), Q18.2 (S), Q18.3 (S), R176.1, R177.2
unnamed: Q18.4 (G), U2.21 (BGATE)
unnamed: R3.2, U2.8 (RT)
unnamed: R4.2, U4.35 (GPIO1)
unnamed: R5.2, U4.36 (GPIO2)
unnamed: R6.2, U4.34 (~WDTB)
unnamed: R8.2, U2.25 (ILIMIT)
unnamed: R9.2, U4.10 (C8)
unnamed: R10.2, U4.12 (C7)
unnamed: R11.2, U4.14 (C6)
unnamed: R12.2, U4.16 (C5)
unnamed: R13.2, U4.18 (C4)
unnamed: R14.2, U4.20 (C3)
unnamed: R15.2, U4.22 (C2)
unnamed: R16.2, U4.24 (C1)
unnamed: R17.2, U4.11 (S8)
unnamed: R18.2, U4.13 (S7)
unnamed: R19.2, U4.15 (S6)
unnamed: R20.2, U4.17 (S5)
unnamed: R21.2, U4.19 (S4)
unnamed: R22.2, U4.21 (S3)
unnamed: R23.2, U4.23 (S2)
unnamed: R24.2, U4.25 (S1)
unnamed: R34.1, R94.2, U2.9 (~SHDN)
unnamed: R51.2, U2.14 (TIMER)
unnamed: R52.1, U4.2 (C12), U4.4 (C11), U4.6 (C10), U4.8 (C9)
unnamed: R78.1, U4.30 (Vtemp2)
unnamed: R79.1, U4.29 (Vtemp1)
unnamed: R80.2, U2.28 (VC)
unnamed: R54.1, R174.1, U2.18 (FBG)
unnamed: R182.1, U2.19 (VFBMIN)
unnamed: R54.2, R56.2, R182.2, U2.26 (VFBMAX)
unnamed: R193.2, U2.11 (MODE)

Notes on the sheet:
Oscillator freq control. 100k = 250kHz
TODO: double check with datasheet/ref circuit
Csensb
Charge Voltage: 8*3.6V = 28.8V = ca. 2.5*(1+(49.9/4.7)) = 29.04V / 8 = 3.63V
Close to PVIN
Battery current and voltage monitor
10uH
TODO: verify higher R
12-24VDC Input
Inrush Current Limiter by Zoé
LiFePO4 Battery Stack
Battery system VOUT
selective charger turn-off (via NTC input)
TODO: NTCs on the LTC6803-4
Status LEDs
VFBMAX = 2.75*(1+(100/10)) = 30.25V
RMAX2
RMAX1
Balancer
TODO: verify that this works
Charger/ Booster
TODO: NOSTUFF
NOSTUFF

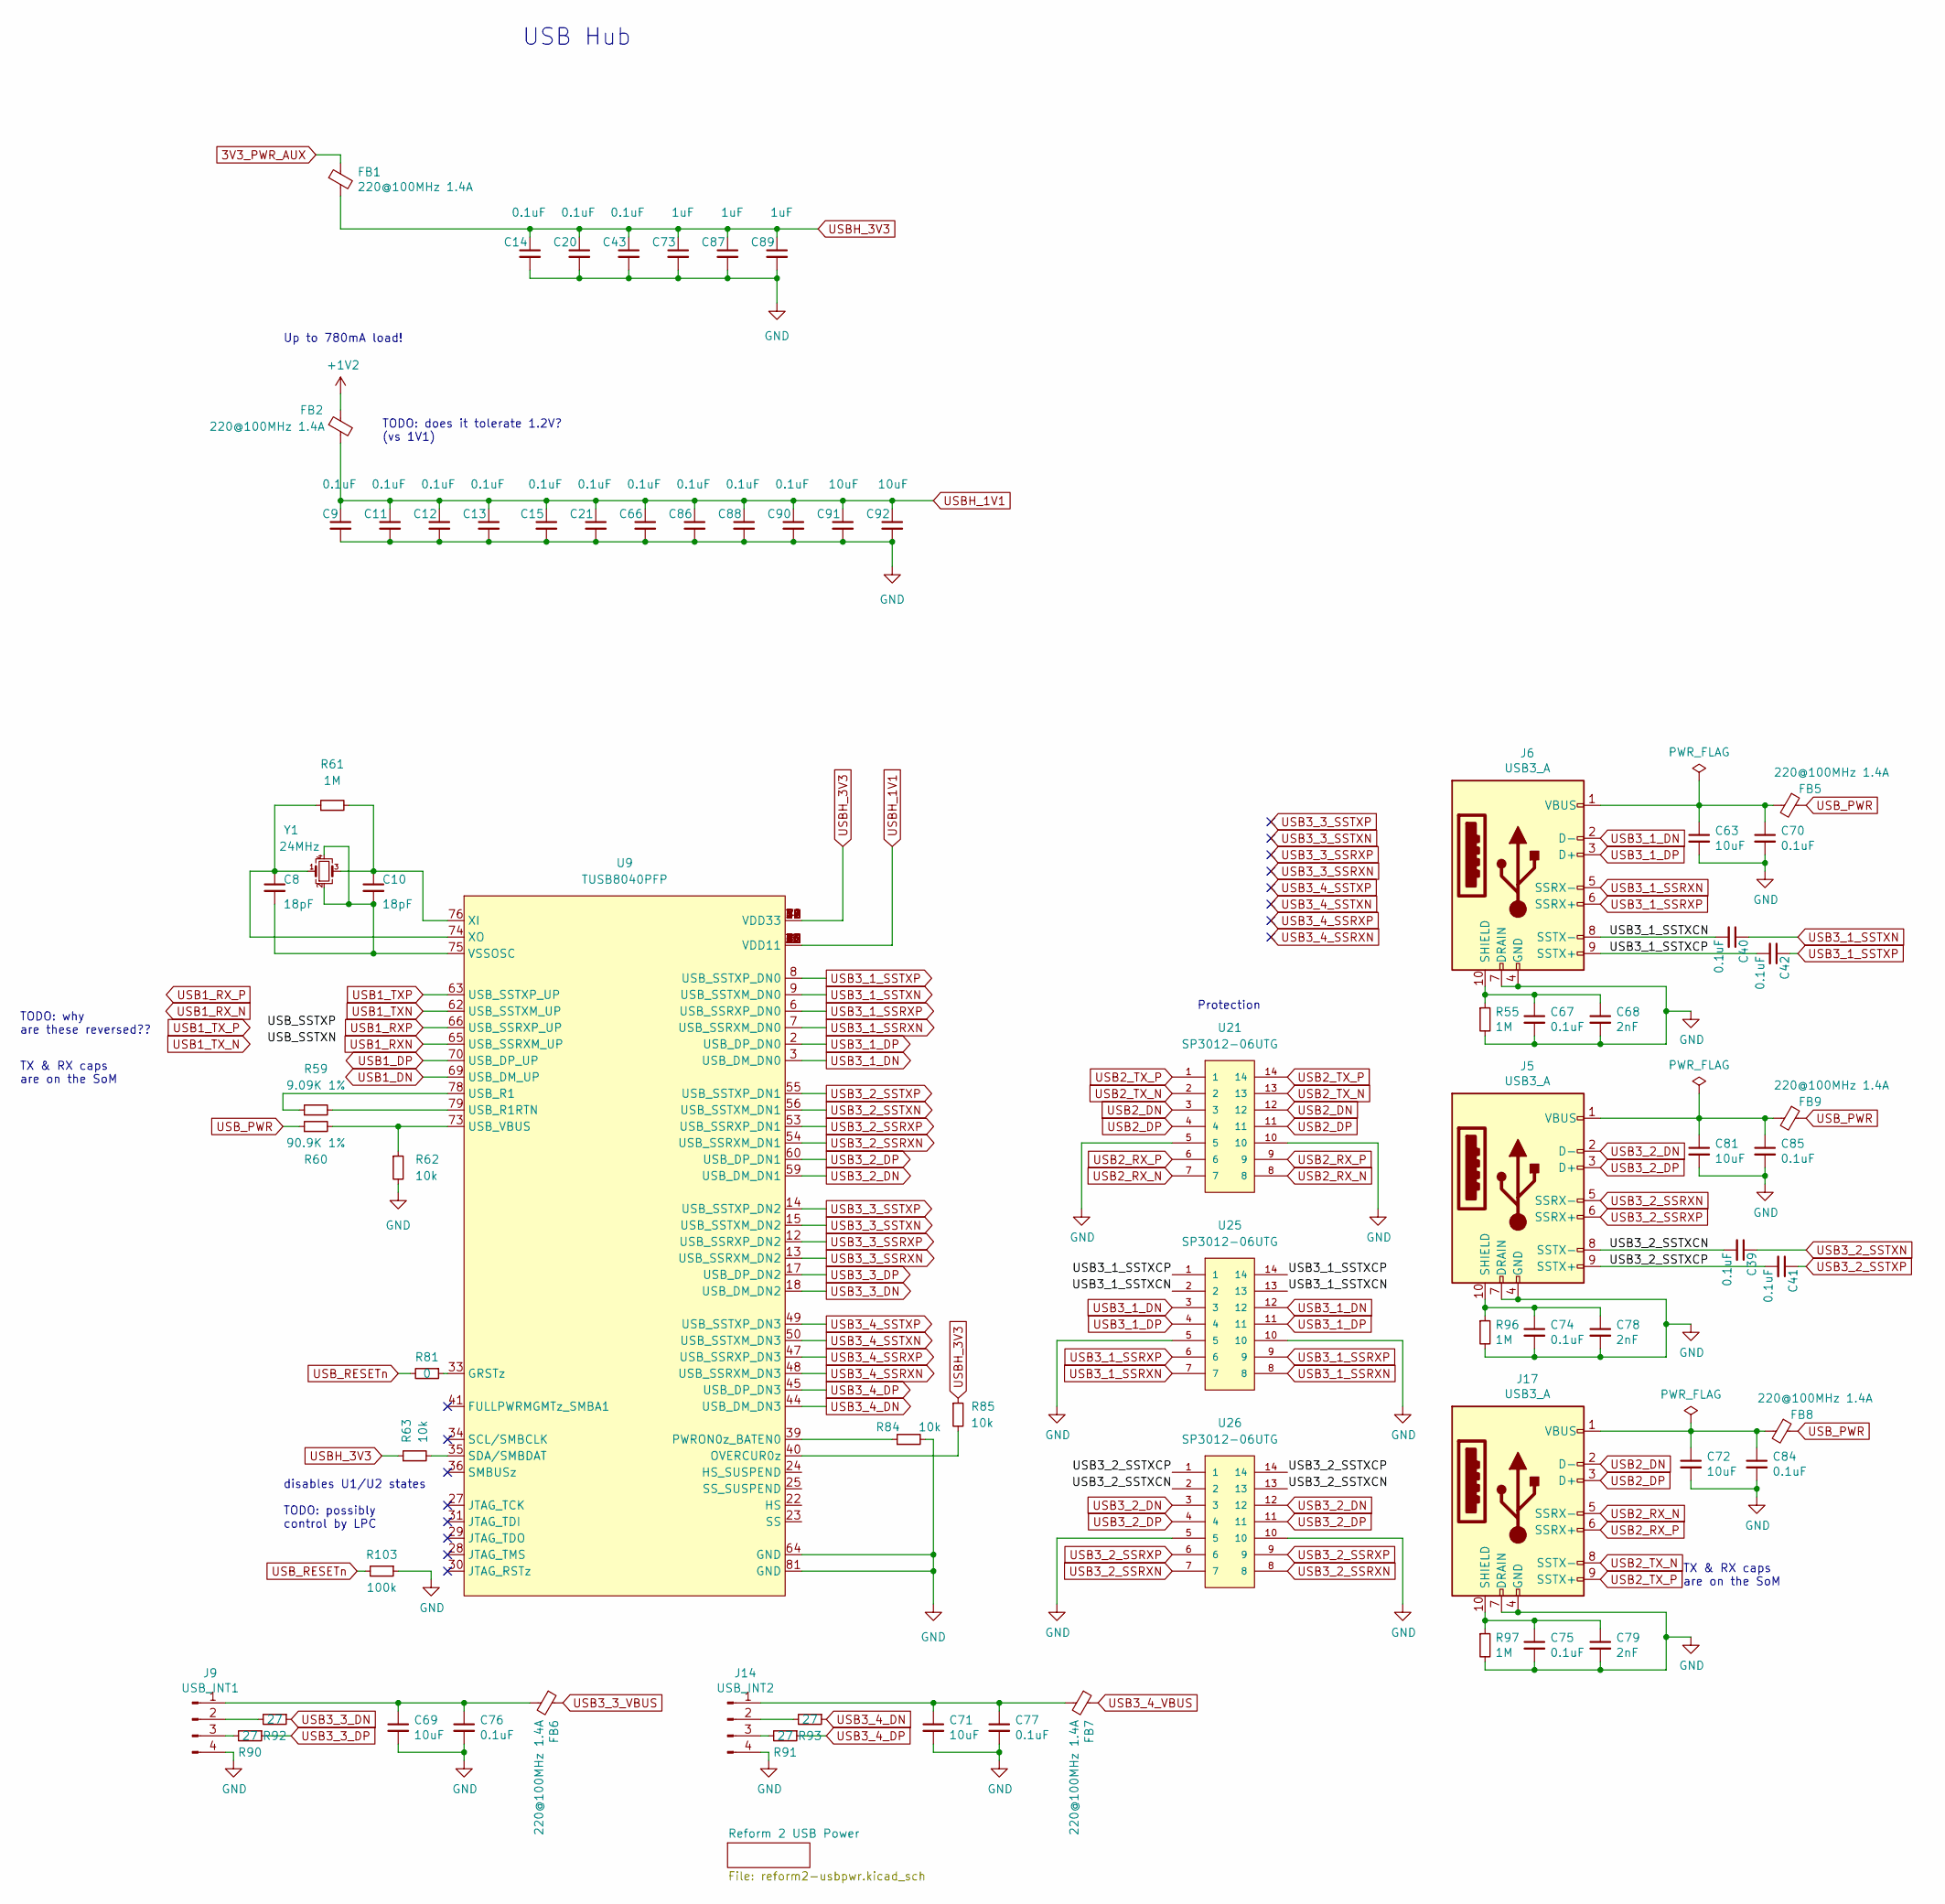
[picture p52: schematic reform2-usb.kicad_sch, MNT Reform 2 USB]

Parts:
C8, C10: 18pF; C_0603_1608Metric; LCSC C107040
C9, C11, C12, C13, C14, C15, C20, C21, C43, C66, C86, C88, C90: 0.1uF; C_0402_1005Metric; LCSC C1525
C39, C40, C41, C42, C67, C70, C74, C75, C76, C77, C84, C85: 0.1uF; C_0603_1608Metric
C63, C69, C71, C72, C81: 10uF; C_0603_1608Metric
C68, C78, C79: 2nF; C_0603_1608Metric
C73, C87, C89: 1uF; C_0402_1005Metric; LCSC C14445
C91, C92: 10uF; C_0402_1005Metric; LCSC C315248
FB1, FB2, FB5, FB6, FB7, FB8, FB9: 220@100MHz 1.4A; L_0603_1608Metric
J5, J6, J17: USB3_A; 692121030100
J9: USB_INT1; JST_PH_B4B-PH-K_1x04_P2.00mm_Vertical
J14: USB_INT2; JST_PH_B4B-PH-K_1x04_P2.00mm_Vertical
R55, R96, R97: 1M; R_0603_1608Metric
R59: 9.09K 1%; R_0402_1005Metric; LCSC C400642
R60: 90.9K 1%; R_0402_1005Metric; LCSC C26989
R61: 1M; R_0402_1005Metric; LCSC C144787
R62, R63, R84, R85: 10k; R_0402_1005Metric; LCSC C60490
R81: 0; R_0402_1005Metric; LCSC C242160
R90, R91, R92, R93: 27; R_0603_1608Metric
R103: 100k; R_0603_1608Metric
U9: TUSB8040PFP; QFP50P1400X1400X120-81N; LCSC C2872001
U21, U25, U26: SP3012-06UTG; SON50P350X135X55-14N
Y1: 24MHz; Crystal_SMD_Abracon_ABM8G-4Pin_3.2x2.5mm; LCSC C91744

Connections:
3V3_PWR_AUX: FB1.1; also elsewhere on the board
+1V2: FB2.1; also elsewhere on the board
/Reform 2 USB/USB3_1_SSTXCN: C40.2, J6.8 (SSTX-), U25.2, U25.13
/Reform 2 USB/USB3_1_SSTXCP: C42.2, J6.9 (SSTX+), U25.1, U25.14
/Reform 2 USB/USB3_2_SSTXCN: C39.2, J5.8 (SSTX-), U26.2, U26.13
/Reform 2 USB/USB3_2_SSTXCP: C41.2, J5.9 (SSTX+), U26.1, U26.14
GND: C9.2, C11.2, C12.2, C13.2, C14.2, C15.2, C20.2, C21.2, C43.2, C63.2, C66.2, C67.2, C68.2, C69.2, C70.2, C71.2, C72.2, C73.2, C74.2, C75.2, C76.2, C77.2, C78.2, C79.2, C81.2, C84.2, C85.2, C86.2, C87.2, C88.2, C89.2, C90.2, C91.2, C92.2, J5.4 (GND), J5.7 (DRAIN), J6.4 (GND), J6.7 (DRAIN), J9.4, J14.4, J17.4 (GND), J17.7 (DRAIN), R55.2, R62.2, R84.2, R96.2, R97.2, R103.1, U9.64 (GND), U9.81 (GND), U21.5, U21.10, U25.5, U25.10, U26.5, U26.10; also elsewhere on the board
unnamed: C8.1, R61.1, U9.74 (XO), Y1.1
unnamed: C10.1, R61.2, U9.76 (XI), Y1.3
unnamed: C8.2, C10.2, U9.75 (VSSOSC), Y1.2, Y1.4
unnamed: C63.1, C70.1, FB5.2, J6.1 (VBUS)
unnamed: C67.1, C68.1, J6.10 (SHIELD), R55.1
unnamed: C69.1, C76.1, FB6.2, J9.1
unnamed: C71.1, C77.1, FB7.2, J14.1
unnamed: C72.1, C84.1, FB8.2, J17.1 (VBUS)
unnamed: C74.1, C78.1, J5.10 (SHIELD), R96.1
unnamed: C75.1, C79.1, J17.10 (SHIELD), R97.1
unnamed: C81.1, C85.1, FB9.2, J5.1 (VBUS)
unnamed: J9.2, R92.2
unnamed: J9.3, R90.2
unnamed: J14.2, R93.2
unnamed: J14.3, R91.2
unnamed: R59.1, U9.78 (USB_R1)
unnamed: R59.2, U9.79 (USB_R1RTN)
unnamed: R60.2, R62.1, U9.73 (USB_VBUS)
unnamed: R63.2, U9.35 (SDA/SMBDAT)
unnamed: R81.1, U9.33 (GRSTz)
unnamed: R84.1, U9.39 (PWRON0z_BATEN0)
unnamed: R85.2, U9.40 (OVERCUR0z)
USB1_DN: U9.69 (USB_DM_UP); also elsewhere on the board
USB1_DP: U9.70 (USB_DP_UP); also elsewhere on the board
USB1_RXN: U9.65 (USB_SSRXM_UP)
USB1_RXP: U9.66 (USB_SSRXP_UP)
USB1_TXN: U9.62 (USB_SSTXM_UP)
USB1_TXP: U9.63 (USB_SSTXP_UP)
USB2_DN: J17.2 (D-), U21.3, U21.12; also elsewhere on the board
USB2_DP: J17.3 (D+), U21.4, U21.11; also elsewhere on the board
USB2_RX_N: J17.5 (SSRX-), U21.7, U21.8; also elsewhere on the board
USB2_RX_P: J17.6 (SSRX+), U21.6, U21.9; also elsewhere on the board
USB2_TX_N: J17.8 (SSTX-), U21.2, U21.13; also elsewhere on the board
USB2_TX_P: J17.9 (SSTX+), U21.1, U21.14; also elsewhere on the board
USB3_1_DN: J6.2 (D-), U9.3 (USB_DM_DN0), U25.3, U25.12
USB3_1_DP: J6.3 (D+), U9.2 (USB_DP_DN0), U25.4, U25.11
USB3_1_SSRXN: J6.5 (SSRX-), U9.7 (USB_SSRXM_DN0), U25.7, U25.8
USB3_1_SSRXP: J6.6 (SSRX+), U9.6 (USB_SSRXP_DN0), U25.6, U25.9
USB3_1_SSTXN: C40.1, U9.9 (USB_SSTXM_DN0)
USB3_1_SSTXP: C42.1, U9.8 (USB_SSTXP_DN0)
USB3_2_DN: J5.2 (D-), U9.59 (USB_DM_DN1), U26.3, U26.12
USB3_2_DP: J5.3 (D+), U9.60 (USB_DP_DN1), U26.4, U26.11
USB3_2_SSRXN: J5.5 (SSRX-), U9.54 (USB_SSRXM_DN1), U26.7, U26.8
USB3_2_SSRXP: J5.6 (SSRX+), U9.53 (USB_SSRXP_DN1), U26.6, U26.9
USB3_2_SSTXN: C39.1, U9.56 (USB_SSTXM_DN1)
USB3_2_SSTXP: C41.1, U9.55 (USB_SSTXP_DN1)
USB3_3_DN: R92.1, U9.18 (USB_DM_DN2)
USB3_3_DP: R90.1, U9.17 (USB_DP_DN2)
USB3_3_SSRXN: U9.13 (USB_SSRXM_DN2)
USB3_3_SSRXP: U9.12 (USB_SSRXP_DN2)
USB3_3_SSTXN: U9.15 (USB_SSTXM_DN2)
USB3_3_SSTXP: U9.14 (USB_SSTXP_DN2)
USB3_3_VBUS: FB6.1
USB3_4_DN: R93.1, U9.44 (USB_DM_DN3)
USB3_4_DP: R91.1, U9.45 (USB_DP_DN3)
USB3_4_SSRXN: U9.48 (USB_SSRXM_DN3)
USB3_4_SSRXP: U9.47 (USB_SSRXP_DN3)
USB3_4_SSTXN: U9.50 (USB_SSTXM_DN3)
USB3_4_SSTXP: U9.49 (USB_SSTXP_DN3)
USB3_4_VBUS: FB7.1
USBH_1V1: C9.1, C11.1, C12.1, C13.1, C15.1, C21.1, C66.1, C86.1, C88.1, C90.1, C91.1, C92.1, FB2.2, U9.1 (VDD11), U9.5 (VDD11), U9.10 (VDD11), U9.11 (VDD11), U9.16 (VDD11), U9.20 (VDD11), U9.26 (VDD11), U9.32 (VDD11), U9.37 (VDD11), U9.42 (VDD11), U9.46 (VDD11), U9.51 (VDD11), U9.52 (VDD11), U9.57 (VDD11), U9.61 (VDD11), U9.67 (VDD11), U9.71 (VDD11)
USBH_3V3: C14.1, C20.1, C43.1, C73.1, C87.1, C89.1, FB1.2, R63.1, R85.1, U9.4 (VDD33), U9.19 (VDD33), U9.21 (VDD33), U9.38 (VDD33), U9.43 (VDD33), U9.58 (VDD33), U9.68 (VDD33), U9.72 (VDD33), U9.77 (VDD33), U9.80 (VDD33)
USB_PWR: FB5.1, FB8.1, FB9.1, R60.1; also elsewhere on the board
USB_RESETn: R81.2, R103.2; also elsewhere on the board

Notes on the sheet:
USB Hub
Up to 780mA load!
TODO: does it tolerate 1.2V? (vs 1V1)
TX & RX caps are on the SoM
disables U1/U2 states TODO: possibly control by LPC
TODO: why are these reversed??
Protection

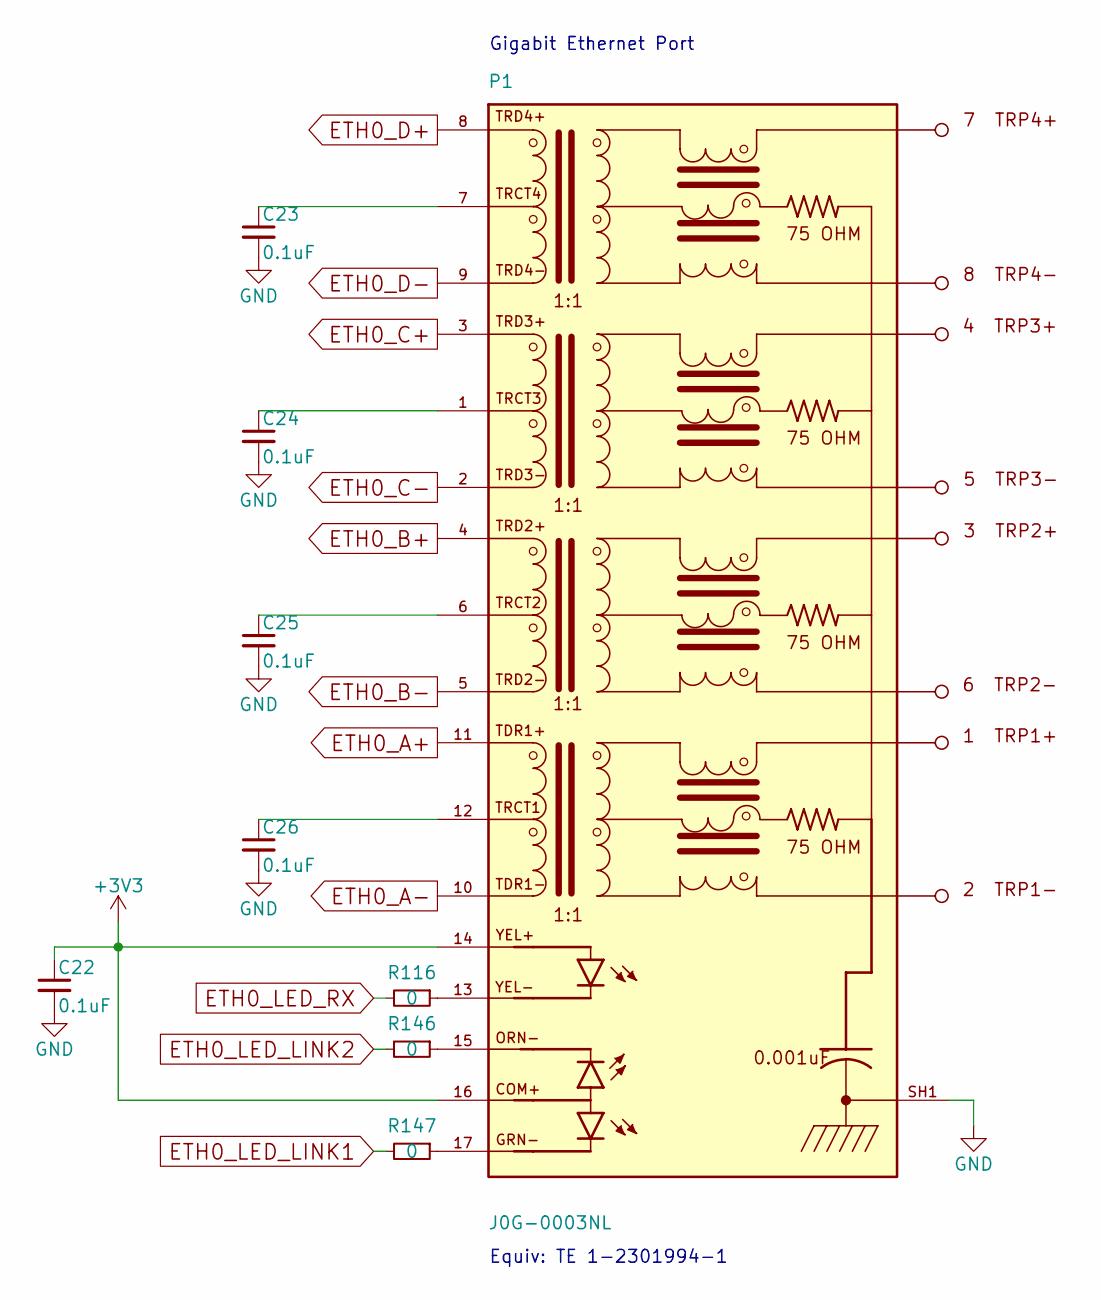
[picture p53: schematic reform2-eth.kicad_sch, MNT Reform 2 Ethernet]

Parts:
C22, C23, C24, C25, C26: 0.1uF; C_0603_1608Metric
P1: J0G-0003NL; PULSE_J0G-0003NL
R116, R146, R147: 0; R_0603_1608Metric

Connections:
+3V3: C22.1, P1.14 (YEL+), P1.16 (COM+); also elsewhere on the board
ETH0_A+: P1.11 (TDR1+); also elsewhere on the board
ETH0_A-: P1.10 (TDR1-); also elsewhere on the board
ETH0_B+: P1.4 (TRD2+); also elsewhere on the board
ETH0_B-: P1.5 (TRD2-); also elsewhere on the board
ETH0_C+: P1.3 (TRD3+); also elsewhere on the board
ETH0_C-: P1.2 (TRD3-); also elsewhere on the board
ETH0_D+: P1.8 (TRD4+); also elsewhere on the board
ETH0_D-: P1.9 (TRD4-); also elsewhere on the board
ETH0_LED_LINK1: R147.2; also elsewhere on the board
ETH0_LED_LINK2: R146.2; also elsewhere on the board
ETH0_LED_RX: R116.2; also elsewhere on the board
GND: C22.2, C23.2, C24.2, C25.2, C26.2, P1.SH1 (SHIELD), P1.SH2 (SHIELD); also elsewhere on the board
unnamed: C23.1, P1.7 (TRCT4)
unnamed: C24.1, P1.1 (TRCT3)
unnamed: C25.1, P1.6 (TRCT2)
unnamed: C26.1, P1.12 (TRCT1)
unnamed: P1.13 (YEL-), R116.1
unnamed: P1.15 (ORN-), R146.1
unnamed: P1.17 (GRN-), R147.1

Notes on the sheet:
Equiv: TE 1-2301994-1
Gigabit Ethernet Port

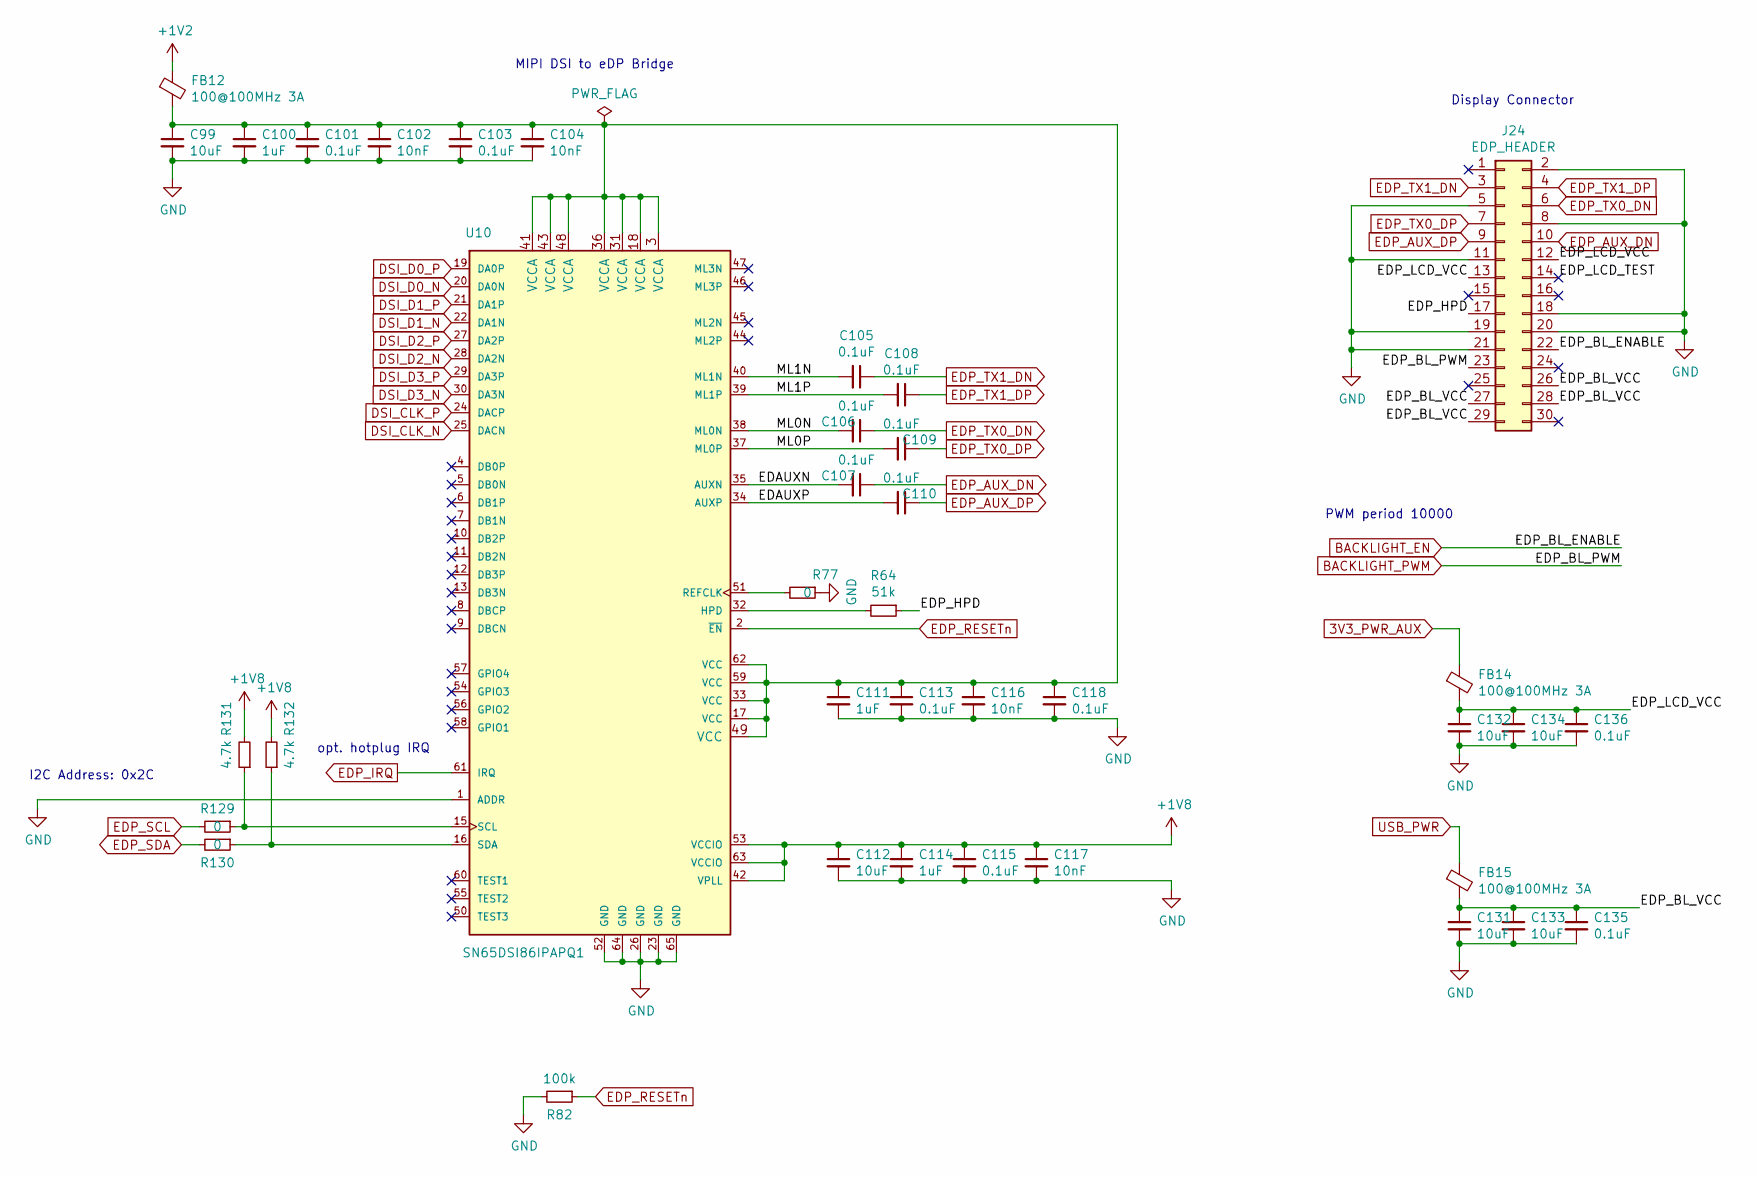
[picture p54: schematic reform2-display.kicad_sch, MNT Reform 2 Internal Display]

Parts:
C99, C112, C131, C132, C133, C134: 10uF; C_0603_1608Metric
C100, C111, C114: 1uF; C_0603_1608Metric
C101, C103, C105, C106, C107, C108, C109, C110, C113, C115, C118, C135, C136: 0.1uF; C_0603_1608Metric
C102, C104, C116, C117: 10nF; C_0603_1608Metric
FB12, FB14, FB15: 100@100MHz 3A; L_0603_1608Metric
J24: EDP_HEADER; PinHeader_2x15_P2.00mm_Vertical
R64: 51k; R_0603_1608Metric
R77, R129, R130: 0; R_0603_1608Metric
R82: 100k; R_0603_1608Metric
R131, R132: 4.7k; R_0603_1608Metric
U10: SN65DSI86IPAPQ1; HTQFP-64-1EP_10x10mm_P0.5mm_EP8x8mm

Connections:
3V3_PWR_AUX: FB14.1; also elsewhere on the board
+1V2: FB12.1; also elsewhere on the board
+1V8: C112.1, C114.1, C115.1, C117.1, R131.2, R132.2, U10.42 (VPLL), U10.53 (VCCIO), U10.63 (VCCIO); also elsewhere on the board
/Reform 2 Display/EDAUXN: C107.2, U10.35 (AUXN)
/Reform 2 Display/EDAUXP: C110.2, U10.34 (AUXP)
/Reform 2 Display/EDP_BL_VCC: C131.1, C133.1, C135.1, FB15.2, J24.26, J24.27, J24.28, J24.29
/Reform 2 Display/EDP_HPD: J24.17, R64.1
/Reform 2 Display/EDP_LCD_TEST: J24.14
/Reform 2 Display/EDP_LCD_VCC: C132.1, C134.1, C136.1, FB14.2, J24.12, J24.13
/Reform 2 Display/ML0N: C106.2, U10.38 (ML0N)
/Reform 2 Display/ML0P: C109.2, U10.37 (ML0P)
/Reform 2 Display/ML1N: C105.2, U10.40 (ML1N)
/Reform 2 Display/ML1P: C108.2, U10.39 (ML1P)
BACKLIGHT_EN: J24.22; also elsewhere on the board
BACKLIGHT_PWM: J24.23; also elsewhere on the board
DSI_CLK_N: U10.25 (DACN); also elsewhere on the board
DSI_CLK_P: U10.24 (DACP); also elsewhere on the board
DSI_D0_N: U10.20 (DA0N); also elsewhere on the board
DSI_D0_P: U10.19 (DA0P); also elsewhere on the board
DSI_D1_N: U10.22 (DA1N); also elsewhere on the board
DSI_D1_P: U10.21 (DA1P); also elsewhere on the board
DSI_D2_N: U10.28 (DA2N); also elsewhere on the board
DSI_D2_P: U10.27 (DA2P); also elsewhere on the board
DSI_D3_N: U10.30 (DA3N); also elsewhere on the board
DSI_D3_P: U10.29 (DA3P); also elsewhere on the board
EDP_AUX_DN: C107.1, J24.10
EDP_AUX_DP: C110.1, J24.9
EDP_IRQ: U10.61 (IRQ); also elsewhere on the board
EDP_RESETn: R82.1, U10.2 (~EN); also elsewhere on the board
EDP_SCL: R129.2; also elsewhere on the board
EDP_SDA: R130.2; also elsewhere on the board
EDP_TX0_DN: C106.1, J24.6
EDP_TX0_DP: C109.1, J24.7
EDP_TX1_DN: C105.1, J24.3
EDP_TX1_DP: C108.1, J24.4
GND: C99.2, C100.2, C101.2, C102.2, C103.2, C104.2, C111.2, C112.2, C113.2, C114.2, C115.2, C116.2, C117.2, C118.2, C131.2, C132.2, C133.2, C134.2, C135.2, C136.2, J24.2, J24.5, J24.8, J24.11, J24.18, J24.19, J24.20, J24.21, R77.1, R82.2, U10.1 (ADDR), U10.23 (GND), U10.26 (GND), U10.52 (GND), U10.64 (GND), U10.65 (GND); also elsewhere on the board
unnamed: C99.1, C100.1, C101.1, C102.1, C103.1, C104.1, C111.1, C113.1, C116.1, C118.1, FB12.2, U10.3 (VCCA), U10.17 (VCC), U10.18 (VCCA), U10.31 (VCCA), U10.33 (VCC), U10.36 (VCCA), U10.41 (VCCA), U10.43 (VCCA), U10.48 (VCCA), U10.49 (VCC), U10.59 (VCC), U10.62 (VCC)
unnamed: R64.2, U10.32 (HPD)
unnamed: R77.2, U10.51 (REFCLK)
unnamed: R129.1, R131.1, U10.15 (SCL)
unnamed: R130.1, R132.1, U10.16 (SDA)
USB_PWR: FB15.1; also elsewhere on the board

Notes on the sheet:
PWM period 10000
MIPI DSI to eDP Bridge
opt. hotplug IRQ
Display Connector
I2C Address: 0x2C
