jackhumbert/reform/reform2-motherboard25-pcb/reform2-motherboard25.kicad_pcb

## KiCad design reform2-motherboard25-pcb/reform2-motherboard25.kicad_pcb (continued)

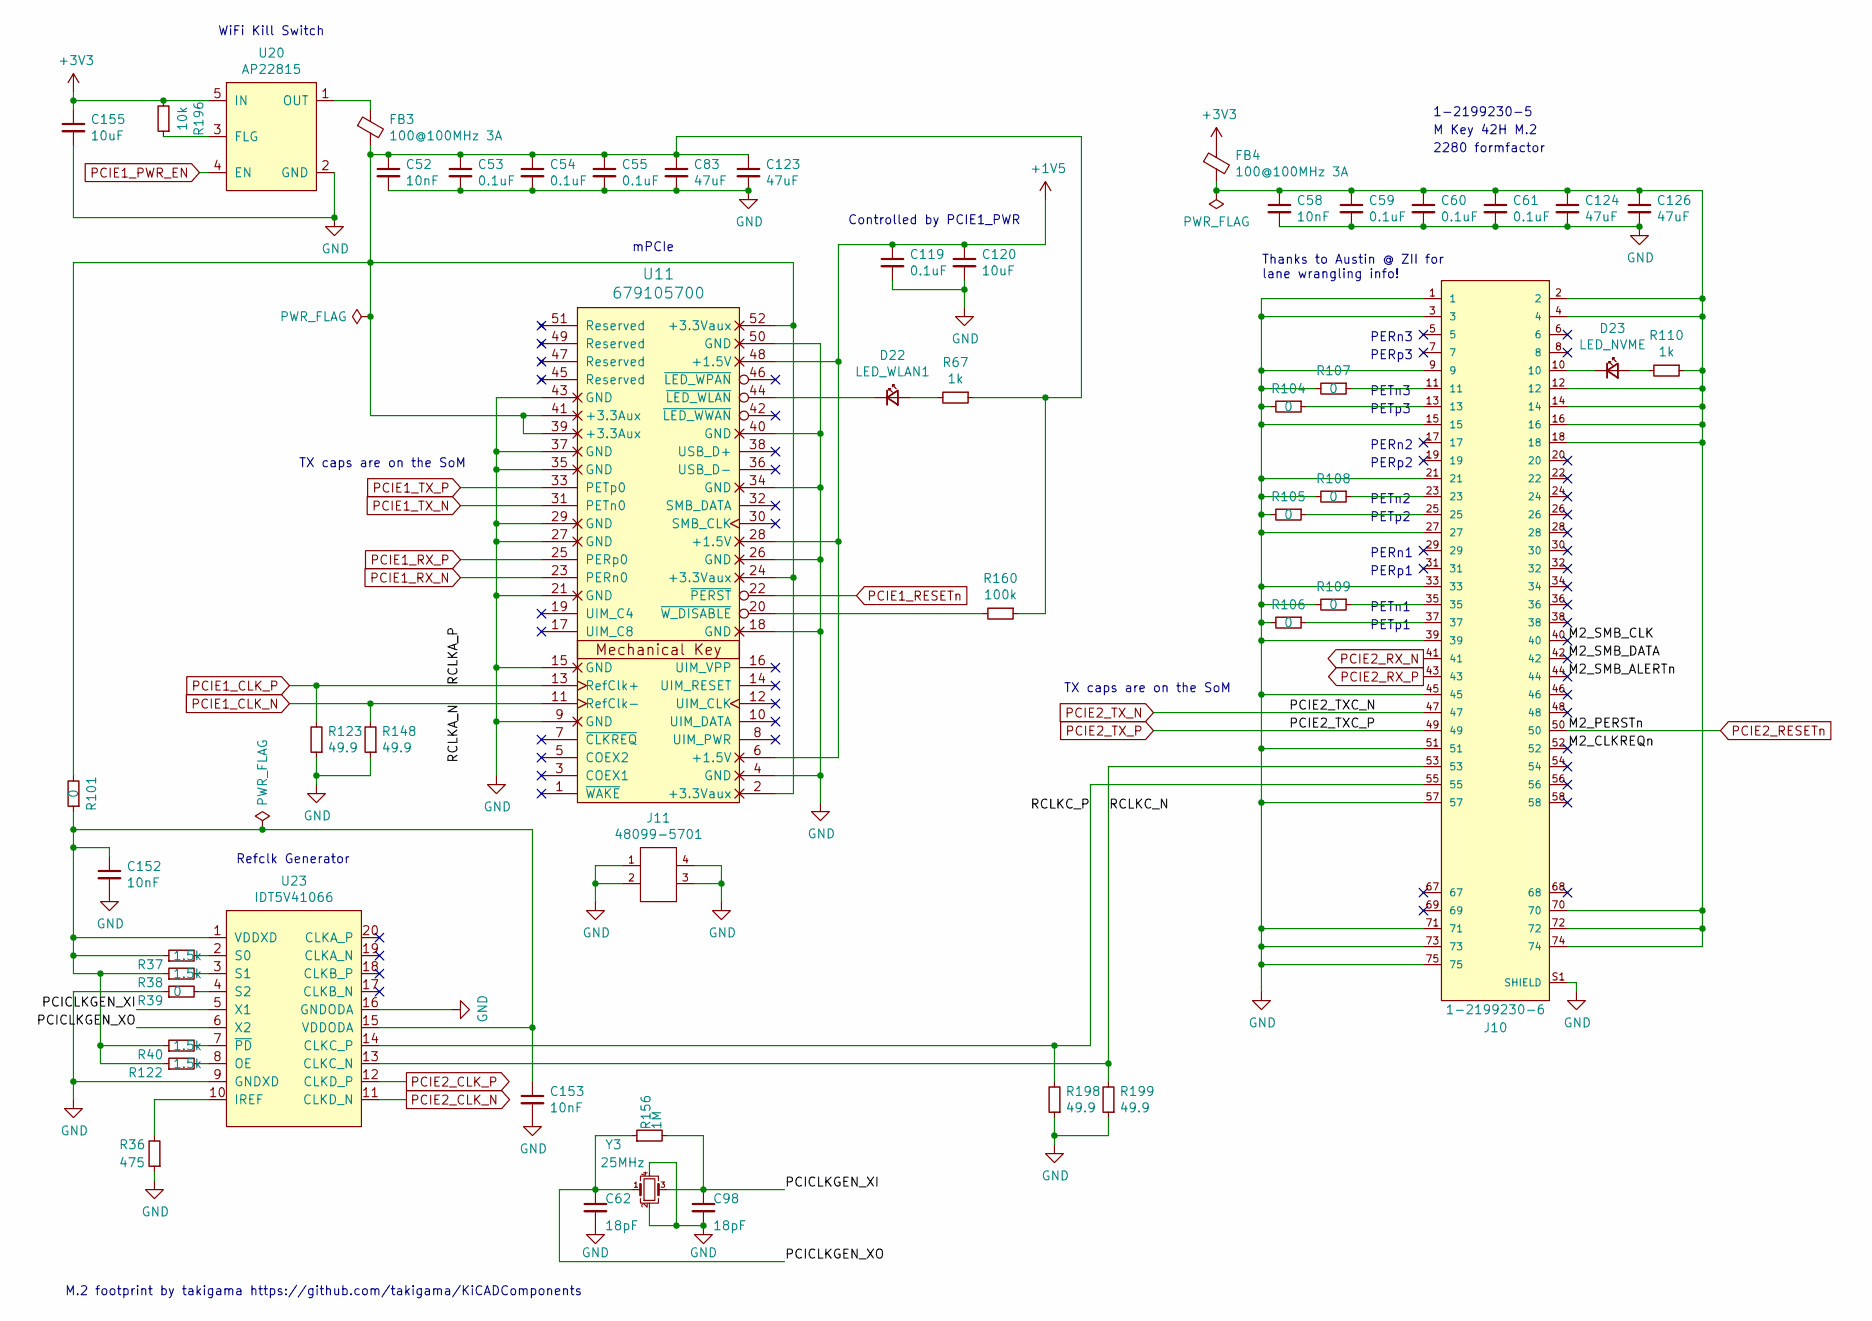
[picture p55: schematic reform2-pcie.kicad_sch, MNT Reform 2 PCIe]

Parts:
C52, C58, C152, C153: 10nF; C_0603_1608Metric
C53, C54, C55, C59, C60, C61, C119: 0.1uF; C_0603_1608Metric
C62, C98: 18pF; C_0603_1608Metric
C83, C123, C124, C126: 47uF; C_0603_1608Metric
C120, C155: 10uF; C_0603_1608Metric
D22: LED_WLAN1; LED_0603_1608Metric
D23: LED_NVME; LED_0603_1608Metric
FB3, FB4: 100@100MHz 3A; L_0603_1608Metric
J10: 1-2199230-6; TE_1-2199230-6
J11: 48099-5701; MOLEX_48099-5701
R36: 475; R_0603_1608Metric
R37, R38, R40, R122: 1.5k; R_0603_1608Metric
R39, R101, R104, R105, R106, R107, R108, R109: 0; R_0603_1608Metric
R67, R110: 1k; R_0603_1608Metric
R123, R148, R198, R199: 49.9; R_0603_1608Metric
R156: 1M; R_0603_1608Metric
R160: 100k; R_0603_1608Metric
R196: 10k; R_0603_1608Metric
U11: 679105700; MOLEX_67910-5700
U20: AP22815; TSOT-25
U23: IDT5V41066; TSSOP-20_4.4x6.5mm_P0.65mm
Y3: 25MHz; Crystal_SMD_Abracon_ABM8G-4Pin_3.2x2.5mm

Connections:
+1V5: C119.1, C120.1, U11.6 (+1.5V), U11.28 (+1.5V), U11.48 (+1.5V); also elsewhere on the board
+3V3: C155.1, FB4.1, R196.2, U20.5 (IN); also elsewhere on the board
/Reform 2 PCIe/M2_CLKREQn: J10.52
/Reform 2 PCIe/M2_SMB_ALERTn: J10.44
/Reform 2 PCIe/M2_SMB_CLK: J10.40
/Reform 2 PCIe/M2_SMB_DATA: J10.42
/Reform 2 PCIe/PCICLKGEN_XI: C98.1, R156.2, U23.5 (X1), Y3.3
/Reform 2 PCIe/PCICLKGEN_XO: C62.1, R156.1, U23.6 (X2), Y3.1
/Reform 2 PCIe/RCLKC_N: J10.53, R199.2, U23.13 (CLKC_N)
/Reform 2 PCIe/RCLKC_P: J10.55, R198.2, U23.14 (CLKC_P)
GND: C52.2, C53.2, C54.2, C55.2, C58.2, C59.2, C60.2, C61.2, C62.2, C83.2, C98.2, C119.2, C120.2, C123.2, C124.2, C126.2, C152.2, C153.2, C155.2, J10.1, J10.3, J10.9, J10.15, J10.21, J10.27, J10.33, J10.39, J10.45, J10.51, J10.57, J10.71, J10.73, J10.75, J10.S1 (SHIELD), J10.S2 (SHIELD), J11.1, J11.2, J11.3, J11.4, R36.1, R39.1, R104.2, R105.2, R106.2, R107.2, R108.2, R109.2, R123.1, R148.1, R198.1, R199.1, U11.4 (GND), U11.9 (GND), U11.15 (GND), U11.18 (GND), U11.21 (GND), U11.26 (GND), U11.27 (GND), U11.29 (GND), U11.34 (GND), U11.35 (GND), U11.37 (GND), U11.40 (GND), U11.43 (GND), U11.50 (GND), U20.2 (GND), U23.9 (GNDXD), U23.16 (GNDODA), Y3.2, Y3.4; also elsewhere on the board
unnamed: C52.1, C53.1, C54.1, C55.1, C83.1, C123.1, FB3.2, R67.1, R101.2, R160.1, U11.2 (+3.3Vaux), U11.24 (+3.3Vaux), U11.39 (+3.3Aux), U11.41 (+3.3Aux), U11.52 (+3.3Vaux)
unnamed: C58.1, C59.1, C60.1, C61.1, C124.1, C126.1, FB4.2, J10.2, J10.4, J10.12, J10.14, J10.16, J10.18, J10.70, J10.72, J10.74, R110.1
unnamed: C152.1, C153.1, R37.1, R38.1, R40.1, R101.1, R122.1, U23.1 (VDDXD), U23.15 (VDDODA)
unnamed: D22.1 (K), U11.44 (~LED_WLAN)
unnamed: D22.2 (A), R67.2
unnamed: D23.1 (K), J10.10
unnamed: D23.2 (A), R110.2
unnamed: J10.11, R107.1
unnamed: J10.13, R104.1
unnamed: J10.23, R108.1
unnamed: J10.25, R105.1
unnamed: J10.35, R109.1
unnamed: J10.37, R106.1
unnamed: R36.2, U23.10 (IREF)
unnamed: R37.2, U23.2 (S0)
unnamed: R38.2, U23.3 (S1)
unnamed: R39.2, U23.4 (S2)
unnamed: R40.2, U23.7 (~PD)
unnamed: R122.2, U23.8 (OE)
unnamed: R160.2, U11.20 (~W_DISABLE)
unnamed: R196.1, U20.3 (FLG)
unnamed: FB3.1, U20.1 (OUT)
PCIE1_CLK_N: R148.2, U11.11 (RefClk-); also elsewhere on the board
PCIE1_CLK_P: R123.2, U11.13 (RefClk+); also elsewhere on the board
PCIE1_PWR_EN: U20.4 (EN); also elsewhere on the board
PCIE1_RESETn: U11.22 (~PERST); also elsewhere on the board
PCIE1_RX_N: U11.23 (PERn0); also elsewhere on the board
PCIE1_RX_P: U11.25 (PERp0); also elsewhere on the board
PCIE1_TX_N: U11.31 (PETn0); also elsewhere on the board
PCIE1_TX_P: U11.33 (PETp0); also elsewhere on the board
PCIE2_CLK_N: U23.11 (CLKD_N); also elsewhere on the board
PCIE2_CLK_P: U23.12 (CLKD_P); also elsewhere on the board
PCIE2_RESETn: J10.50; also elsewhere on the board
PCIE2_RX_N: J10.41; also elsewhere on the board
PCIE2_RX_P: J10.43; also elsewhere on the board
PCIE2_TX_N: J10.47; also elsewhere on the board
PCIE2_TX_P: J10.49; also elsewhere on the board

Notes on the sheet:
1-2199230-5
Controlled by PCIE1_PWR
Thanks to Austin @ ZII for lane wrangling info!
PERp1
PERn3
TX caps are on the SoM
M.2 footprint by takigama https://github.com/takigama/KiCADComponents
PETn3
PETn1
2280 formfactor
Refclk Generator
PETp2
PETn2
PERp2
M Key 42H M.2
PERn2
mPCIe
PERp3
WiFi Kill Switch
PETp1
PERn1
PETp3

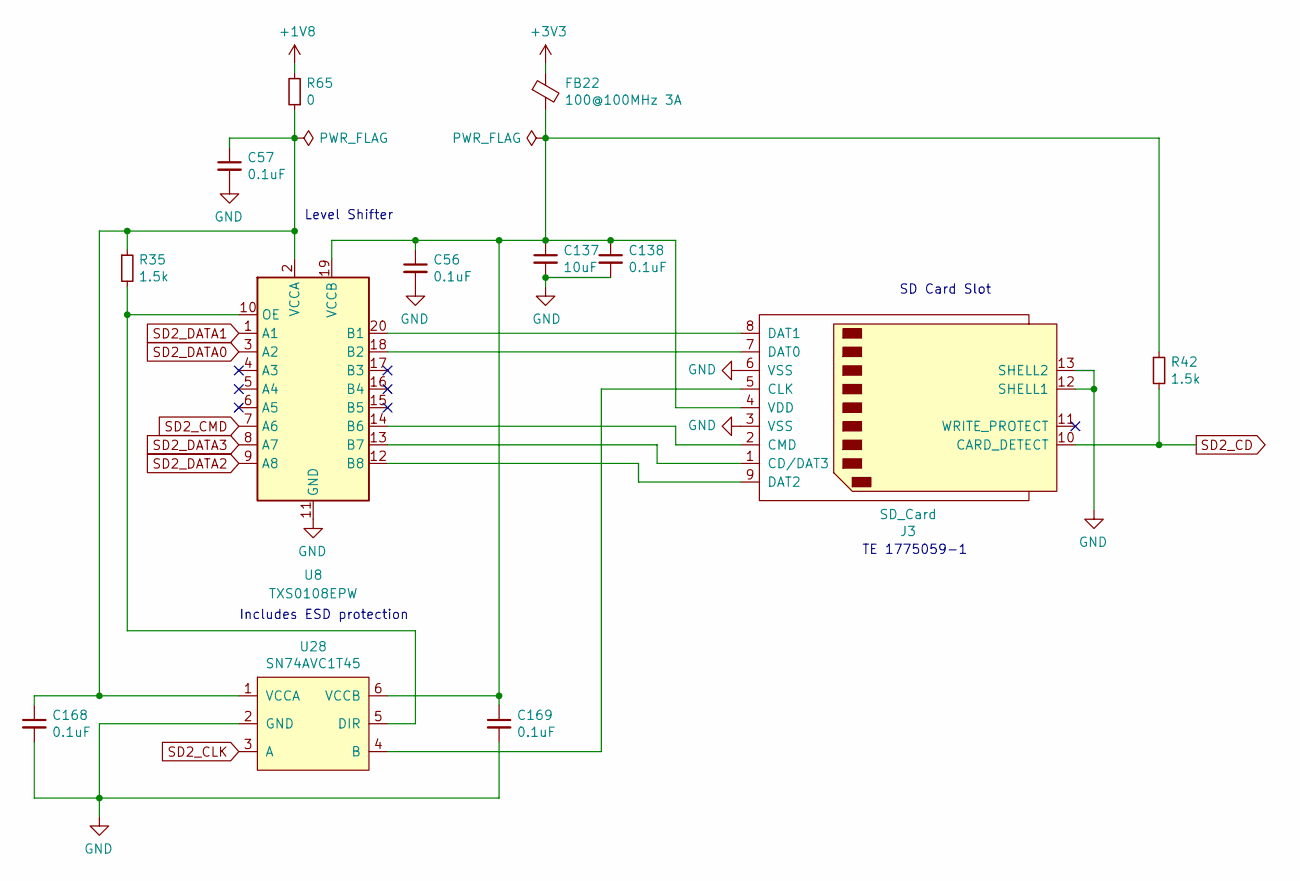
[picture p56: schematic reform2-sd.kicad_sch, MNT Reform 2 SD Card]

Parts:
C56, C57, C138, C168, C169: 0.1uF; C_0603_1608Metric
C137: 10uF; C_0603_1608Metric
FB22: 100@100MHz 3A; L_0603_1608Metric
J3: SD_Card; TE_1775059-1
R35, R42: 1.5k; R_0603_1608Metric
R65: 0; R_0603_1608Metric
U8: TXS0108EPW; TSSOP-20_4.4x6.5mm_P0.65mm
U28: SN74AVC1T45; SOT-23-6

Connections:
+1V8: R65.2; also elsewhere on the board
+3V3: FB22.1; also elsewhere on the board
GND: C56.2, C57.2, C137.2, C138.2, C168.2, C169.2, J3.3 (VSS), J3.6 (VSS), J3.12 (SHELL1), J3.13 (SHELL2), U8.11 (GND), U28.2 (GND); also elsewhere on the board
unnamed: C56.1, C137.1, C138.1, C169.1, FB22.2, J3.4 (VDD), R42.1, U8.19 (VCCB), U28.6 (VCCB)
unnamed: C57.1, C168.1, R35.1, R65.1, U8.2 (VCCA), U28.1 (VCCA)
unnamed: J3.1 (CD/DAT3), U8.13 (B7)
unnamed: J3.2 (CMD), U8.14 (B6)
unnamed: J3.5 (CLK), U28.4 (B)
unnamed: J3.7 (DAT0), U8.18 (B2)
unnamed: J3.8 (DAT1), U8.20 (B1)
unnamed: J3.9 (DAT2), U8.12 (B8)
unnamed: R35.2, U8.10 (OE), U28.5 (DIR)
SD2_CD: J3.10 (CARD_DETECT), R42.2; also elsewhere on the board
SD2_CLK: U28.3 (A); also elsewhere on the board
SD2_CMD: U8.7 (A6); also elsewhere on the board
SD2_DATA0: U8.3 (A2); also elsewhere on the board
SD2_DATA1: U8.1 (A1); also elsewhere on the board
SD2_DATA2: U8.9 (A8); also elsewhere on the board
SD2_DATA3: U8.8 (A7); also elsewhere on the board

Notes on the sheet:
TE 1775059-1
SD Card Slot
Level Shifter
Includes ESD protection

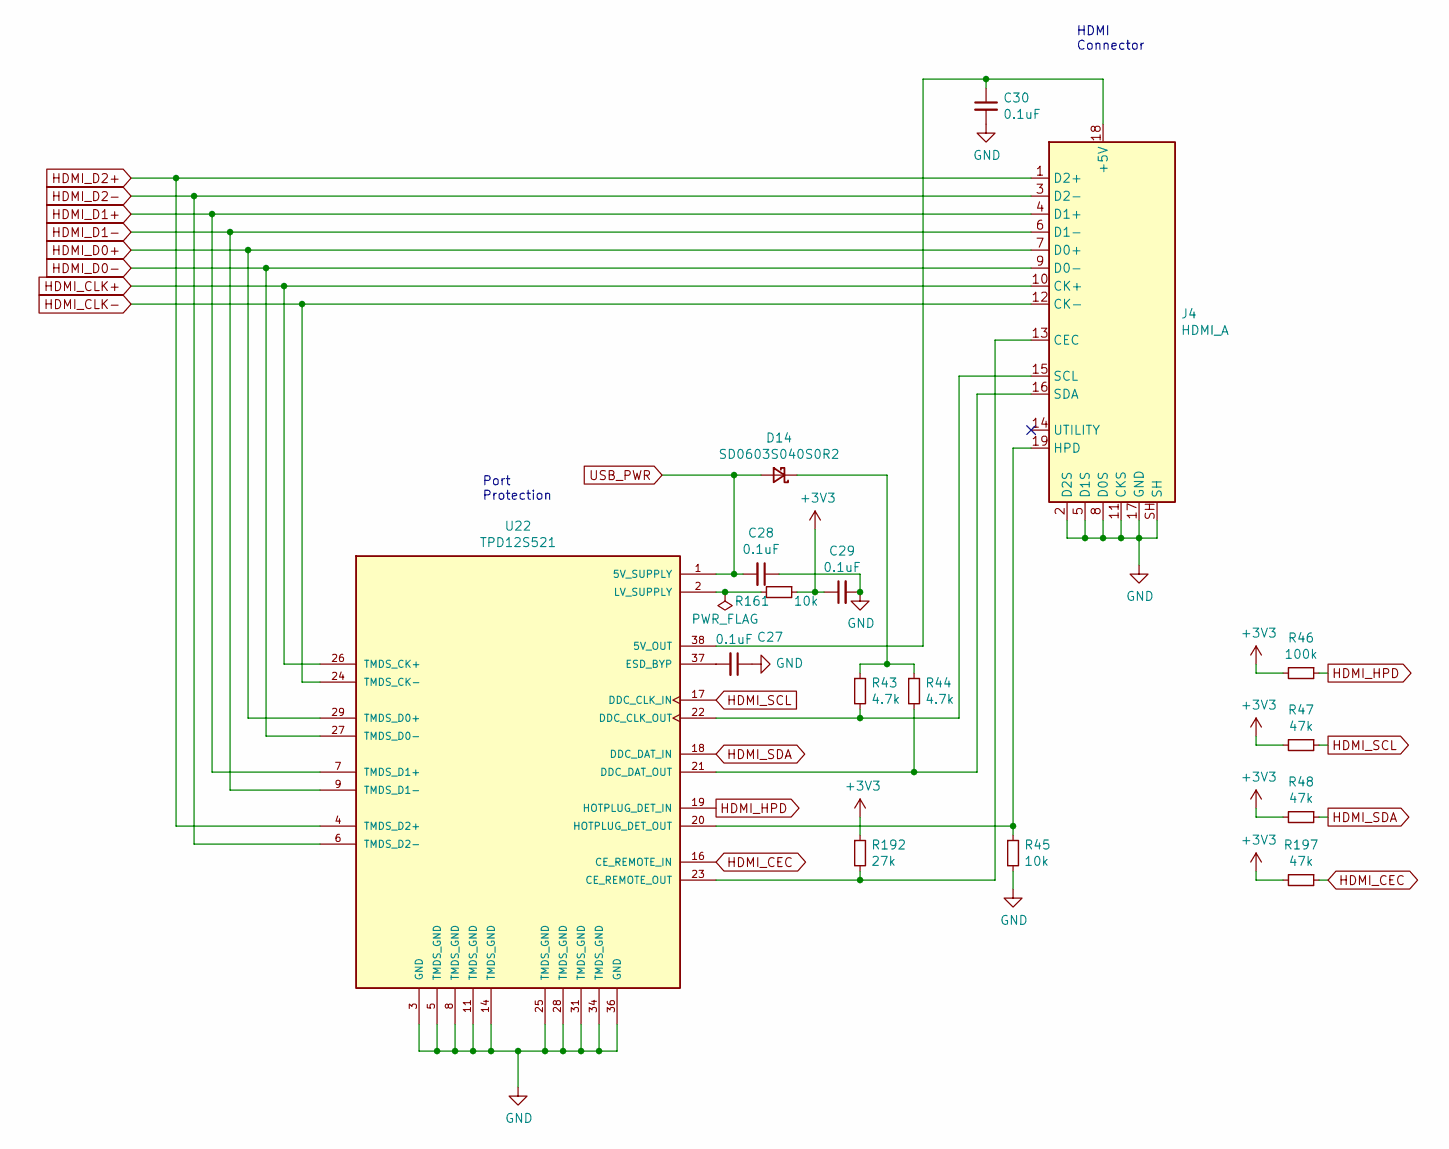
[picture p57: schematic reform2-hdmi.kicad_sch, MNT Reform 2 External Display]

Parts:
C27, C28, C29, C30: 0.1uF; C_0603_1608Metric
D14: SD0603S040S0R2; D_0603_1608Metric_Castellated
J4: HDMI_A; HDMI-685119134923
R43, R44: 4.7k; R_0603_1608Metric
R45, R161: 10k; R_0603_1608Metric
R46: 100k; R_0603_1608Metric
R47, R48, R197: 47k; R_0603_1608Metric
R192: 27k; R_0603_1608Metric
U22: TPD12S521; TSSOP50P640X120-38N

Connections:
+3V3: C29.1, R46.2, R47.2, R48.2, R161.1, R192.1, R197.2; also elsewhere on the board
GND: C27.1, C28.1, C29.2, C30.2, J4.2 (D2S), J4.5 (D1S), J4.8 (D0S), J4.11 (CKS), J4.17 (GND), J4.SH, R45.2, U22.3 (GND), U22.5 (TMDS_GND), U22.8 (TMDS_GND), U22.11 (TMDS_GND), U22.14 (TMDS_GND), U22.25 (TMDS_GND), U22.28 (TMDS_GND), U22.31 (TMDS_GND), U22.34 (TMDS_GND), U22.36 (GND); also elsewhere on the board
HDMI_CEC: R197.1, U22.16 (CE_REMOTE_IN); also elsewhere on the board
HDMI_CLK+: J4.10 (CK+), U22.13 (TMDS_CK+), U22.26 (TMDS_CK+); also elsewhere on the board
HDMI_CLK-: J4.12 (CK-), U22.15 (TMDS_CK-), U22.24 (TMDS_CK-); also elsewhere on the board
HDMI_D0+: J4.7 (D0+), U22.10 (TMDS_D0+), U22.29 (TMDS_D0+); also elsewhere on the board
HDMI_D0-: J4.9 (D0-), U22.12 (TMDS_D0-), U22.27 (TMDS_D0-); also elsewhere on the board
HDMI_D1+: J4.4 (D1+), U22.7 (TMDS_D1+), U22.32 (TMDS_D1+); also elsewhere on the board
HDMI_D1-: J4.6 (D1-), U22.9 (TMDS_D1-), U22.30 (TMDS_D1-); also elsewhere on the board
HDMI_D2+: J4.1 (D2+), U22.4 (TMDS_D2+), U22.35 (TMDS_D2+); also elsewhere on the board
HDMI_D2-: J4.3 (D2-), U22.6 (TMDS_D2-), U22.33 (TMDS_D2-); also elsewhere on the board
HDMI_HPD: R46.1, U22.19 (HOTPLUG_DET_IN); also elsewhere on the board
HDMI_SCL: R47.1, U22.17 (DDC_CLK_IN); also elsewhere on the board
HDMI_SDA: R48.1, U22.18 (DDC_DAT_IN); also elsewhere on the board
unnamed: C27.2, U22.37 (ESD_BYP)
unnamed: C30.1, J4.18 (+5V), U22.38 (5V_OUT)
unnamed: D14.1 (K), R43.1, R44.1
unnamed: J4.13 (CEC), R192.2, U22.23 (CE_REMOTE_OUT)
unnamed: J4.15 (SCL), R43.2, U22.22 (DDC_CLK_OUT)
unnamed: J4.16 (SDA), R44.2, U22.21 (DDC_DAT_OUT)
unnamed: J4.19 (HPD), R45.1, U22.20 (HOTPLUG_DET_OUT)
unnamed: R161.2, U22.2 (LV_SUPPLY)
USB_PWR: C28.2, D14.2 (A), U22.1 (5V_SUPPLY); also elsewhere on the board

Notes on the sheet:
HDMI Connector
Port Protection

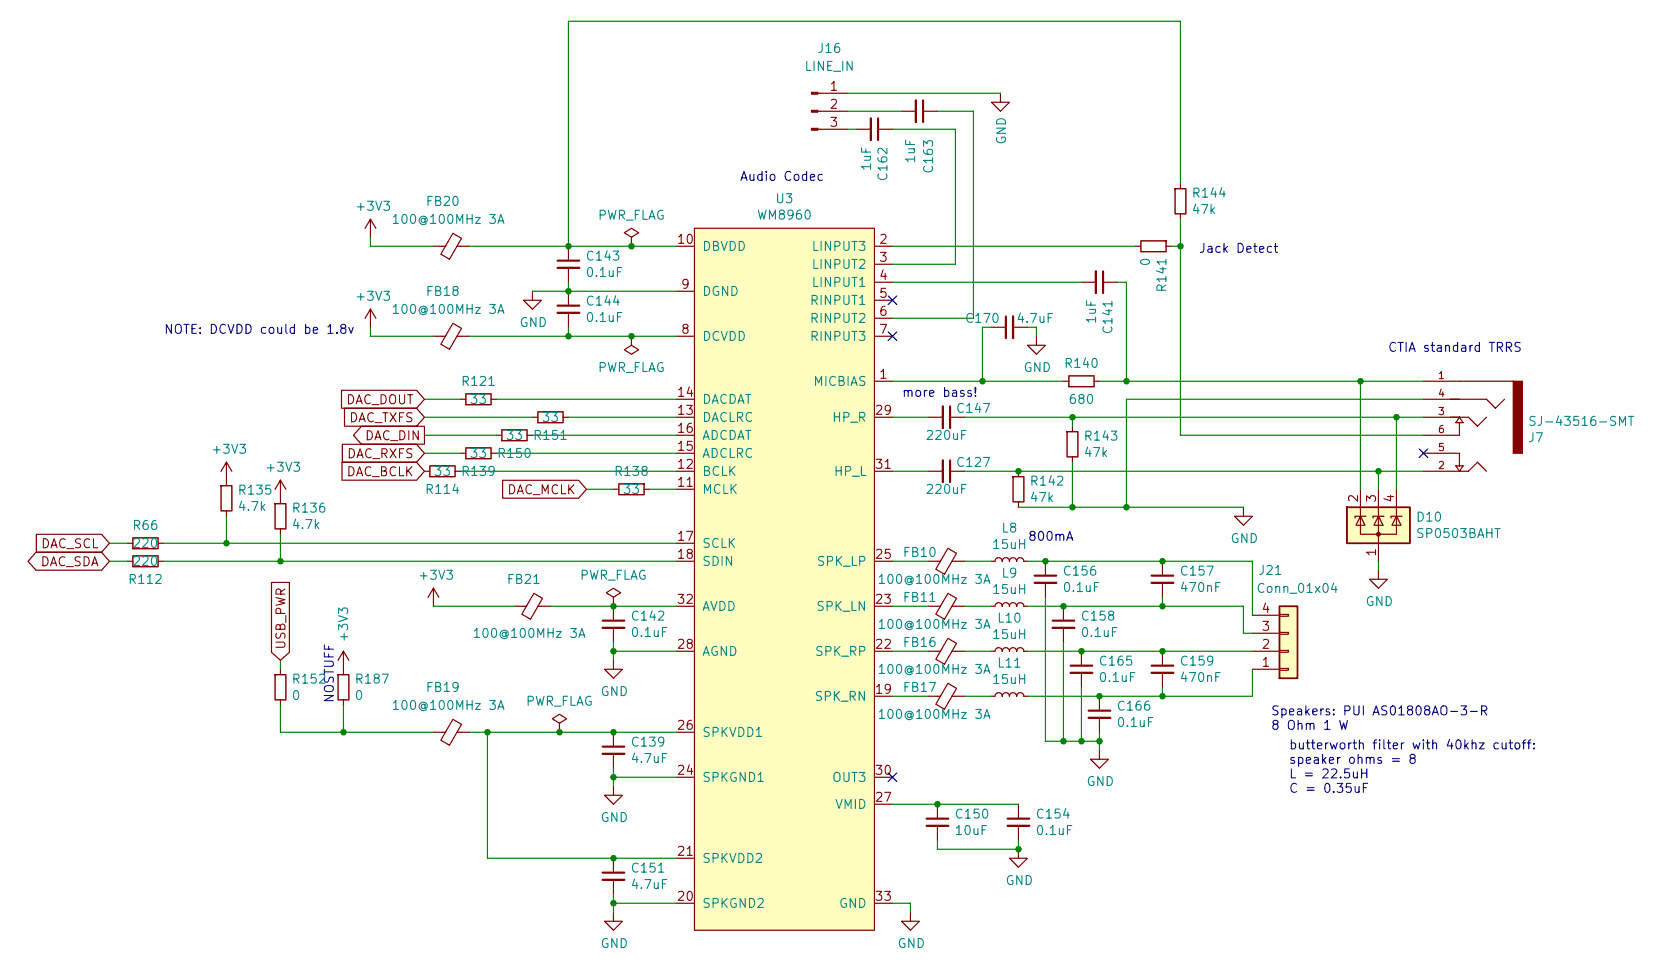
[picture p58: schematic reform2-audio.kicad_sch, Reform 2 Audio]

Parts:
C127, C147: 220uF; C_1210_3225Metric
C139, C151, C170: 4.7uF; C_0603_1608Metric
C141, C162, C163: 1uF; C_0603_1608Metric
C142, C143, C144, C154, C156, C158, C165, C166: 0.1uF; C_0603_1608Metric
C150: 10uF; C_0603_1608Metric
C157, C159: 470nF; C_0603_1608Metric
D10: SP0503BAHT; SOT-143
FB10, FB11, FB16, FB17, FB18, FB19, FB20, FB21: 100@100MHz 3A; L_0603_1608Metric
J7: SJ-43516-SMT
J16: LINE_IN; PinHeader_1x03_P2.00mm_Vertical
J21: Conn_01x04; JST_PH_B4B-PH-K_1x04_P2.00mm_Vertical
L8, L9, L10, L11: 15uH; L_1210_3225Metric
R66, R112: 220; R_0603_1608Metric
R114, R121, R138, R139, R150, R151: 33; R_0603_1608Metric
R135, R136: 4.7k; R_0603_1608Metric
R140: 680; R_0603_1608Metric
R141, R152, R187: 0; R_0603_1608Metric
R142, R143, R144: 47k; R_0603_1608Metric
U3: WM8960; QFN-32-1EP_5x5mm_P0.5mm_EP3.45x3.45mm_ThermalVias

Connections:
+3V3: FB18.1, FB20.1, FB21.1, R135.1, R136.1, R187.1; also elsewhere on the board
DAC_BCLK: R114.1; also elsewhere on the board
DAC_DIN: R150.1; also elsewhere on the board
DAC_DOUT: R121.1; also elsewhere on the board
DAC_MCLK: R138.2; also elsewhere on the board
DAC_RXFS: R139.1; also elsewhere on the board
DAC_SCL: R66.1; also elsewhere on the board
DAC_SDA: R112.1; also elsewhere on the board
DAC_TXFS: R151.1; also elsewhere on the board
GND: C139.2, C142.2, C143.2, C144.1, C150.2, C151.2, C154.2, C156.2, C158.2, C165.2, C166.2, C170.2, D10.1 (A), J7.4 (RING2), J16.1, R142.2, R143.2, U3.9 (DGND), U3.20 (SPKGND2), U3.24 (SPKGND1), U3.28 (AGND), U3.33 (GND); also elsewhere on the board
unnamed: C127.1, D10.3 (K), J7.2 (TIP), R142.1
unnamed: C127.2, U3.31 (HP_L)
unnamed: C139.1, C151.1, FB19.2, U3.21 (SPKVDD2), U3.26 (SPKVDD1)
unnamed: C141.1, D10.2 (K), J7.1 (SLEEVE), R140.2
unnamed: C141.2, U3.4 (LINPUT1)
unnamed: C142.1, FB21.2, U3.32 (AVDD)
unnamed: C143.1, FB20.2, R144.1, U3.10 (DBVDD)
unnamed: C144.2, FB18.2, U3.8 (DCVDD)
unnamed: C147.1, D10.4 (K), J7.3 (RING1), R143.1
unnamed: C147.2, U3.29 (HP_R)
unnamed: C150.1, C154.1, U3.27 (VMID)
unnamed: C156.1, C157.1, J21.4, L8.2
unnamed: C157.2, C158.1, J21.3, L9.2
unnamed: C159.1, C165.1, J21.2, L10.2
unnamed: C159.2, C166.1, J21.1, L11.2
unnamed: C162.1, U3.3 (LINPUT2)
unnamed: C162.2, J16.3
unnamed: C163.1, U3.6 (RINPUT2)
unnamed: C163.2, J16.2
unnamed: C170.1, R140.1, U3.1 (MICBIAS)
unnamed: J7.6 (RING_SWITCH), R141.1, R144.2
unnamed: FB10.2, L8.1
unnamed: FB11.2, L9.1
unnamed: FB16.2, L10.1
unnamed: FB17.2, L11.1
unnamed: R112.2, R136.2, U3.18 (SDIN)
unnamed: R114.2, U3.12 (BCLK)
unnamed: R121.2, U3.14 (DACDAT)
unnamed: R66.2, R135.2, U3.17 (SCLK)
unnamed: R138.1, U3.11 (MCLK)
unnamed: R139.2, U3.15 (ADCLRC)
unnamed: R141.2, U3.2 (LINPUT3)
unnamed: R150.2, U3.16 (ADCDAT)
unnamed: R151.2, U3.13 (DACLRC)
unnamed: FB19.1, R152.2, R187.2
unnamed: FB17.1, U3.19 (SPK_RN)
unnamed: FB16.1, U3.22 (SPK_RP)
unnamed: FB11.1, U3.23 (SPK_LN)
unnamed: FB10.1, U3.25 (SPK_LP)
USB_PWR: R152.1; also elsewhere on the board

Notes on the sheet:
CTIA standard TRRS
butterworth filter with 40khz cutoff: speaker ohms = 8 L = 22.5uH C = 0.35uF
Jack Detect
Audio Codec
Speakers: PUI AS01808AO-3-R 8 Ohm 1 W
NOSTUFF
NOTE: DCVDD could be 1.8v
more bass!
800mA

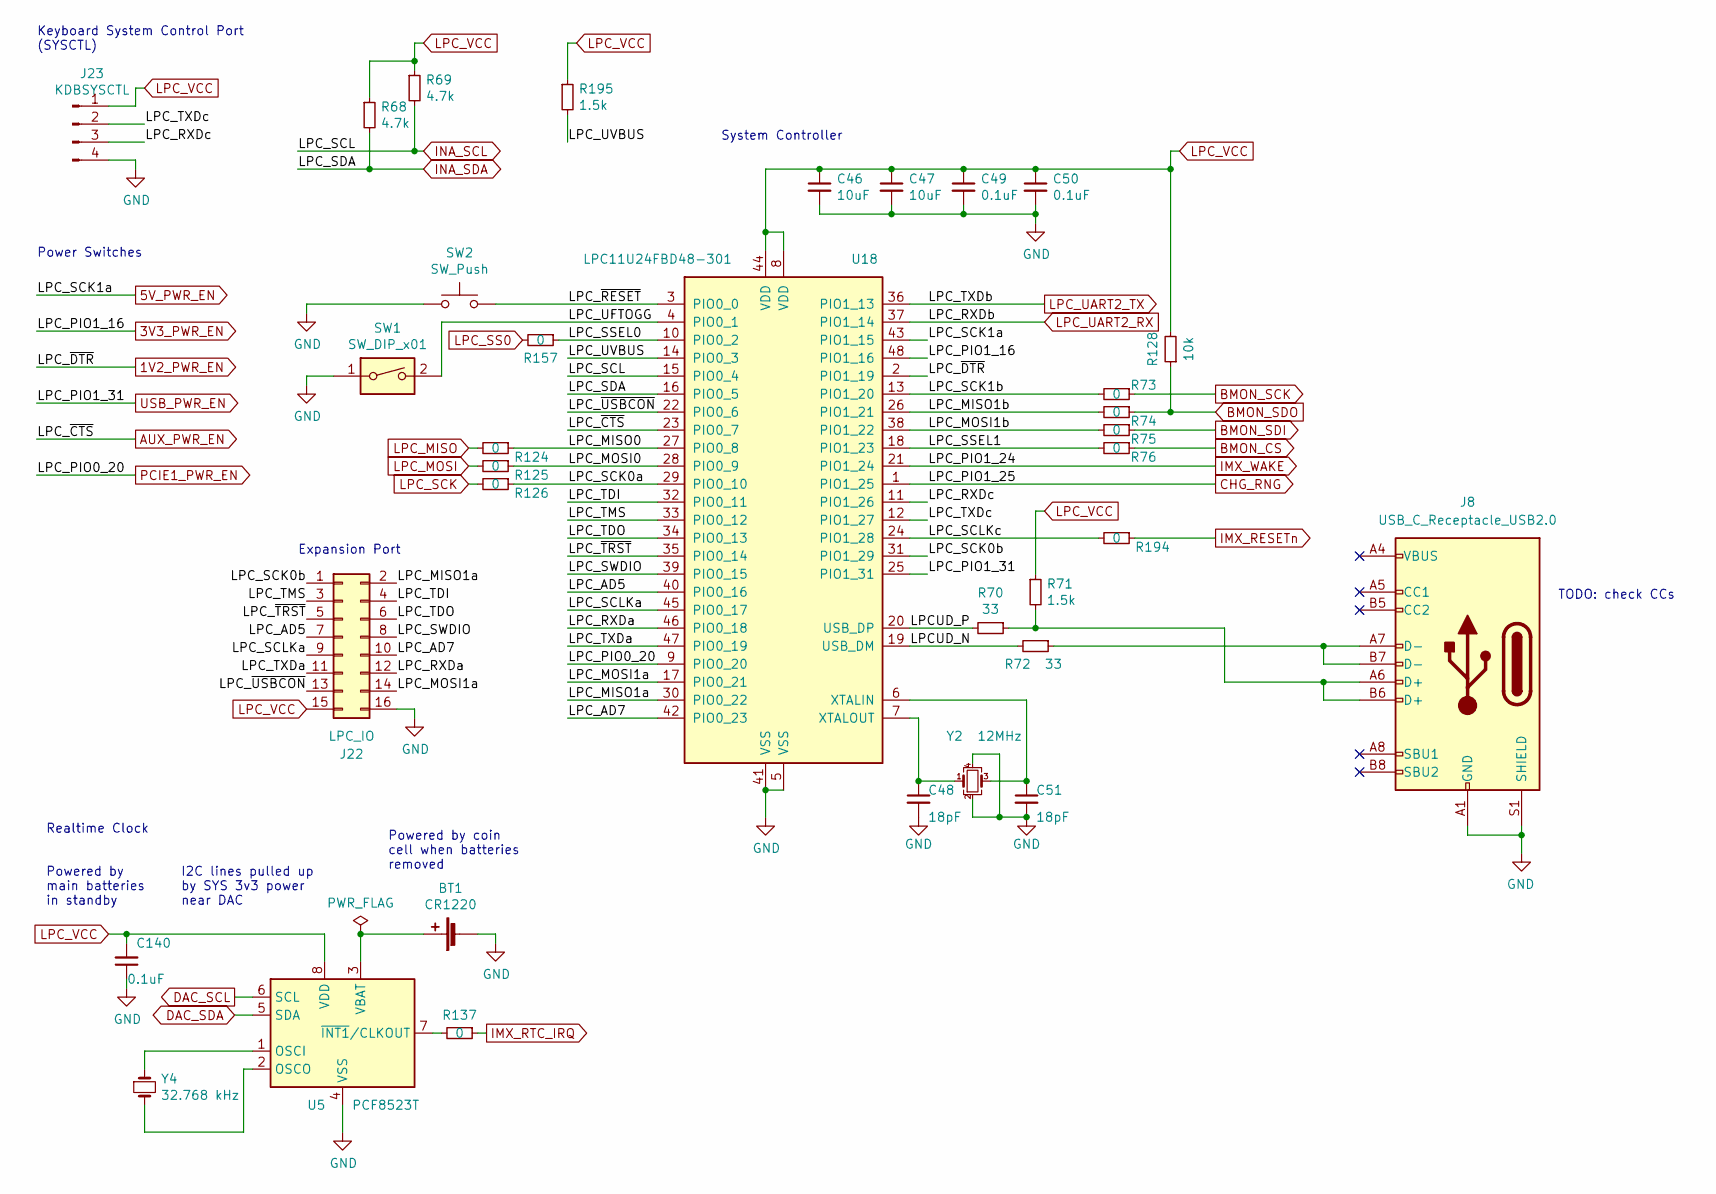
[picture p59: schematic reform2-lpc.kicad_sch, Reform 2 LPC]

Parts:
BT1: CR1220; BatteryHolder_Keystone_3000_1x12mm
C46, C47: 10uF; C_0603_1608Metric
C48, C51: 18pF; C_0603_1608Metric
C49, C50, C140: 0.1uF; C_0603_1608Metric
J8: USB_C_Receptacle_USB2.0; USB_C_Receptacle_HRO_TYPE-C-31-M-12
J22: LPC_IO; PinHeader_2x08_P2.54mm_Vertical
J23: KDBSYSCTL; JST_PH_B4B-PH-K_1x04_P2.00mm_Vertical
R68, R69: 4.7k; R_0603_1608Metric
R70, R72: 33; R_0603_1608Metric
R71, R195: 1.5k; R_0603_1608Metric
R73, R74, R75, R76, R124, R125, R126, R137, R157, R194: 0; R_0603_1608Metric
R128: 10k; R_0603_1608Metric
SW1: SW_DIP_x01; SW_DIP_SPSTx01_Slide_Omron_A6S-110x_W8.9mm_P2.54mm
SW2: SW_Push; UK-B0206-G3.8-250-JZ
U5: PCF8523T; SOIC-8_3.9x4.9mm_P1.27mm
U18: LPC11U24FBD48-301; LQFP-48_7x7mm_P0.5mm
Y2: 12MHz; Crystal_SMD_Abracon_ABM8G-4Pin_3.2x2.5mm
Y4: 32.768 kHz; Crystal_SMD_3215-2Pin_3.2x1.5mm

Connections:
1V2_PWR_EN: U18.2 (PIO1_19); also elsewhere on the board
3V3_PWR_EN: U18.48 (PIO1_16); also elsewhere on the board
5V_PWR_EN: U18.43 (PIO1_15); also elsewhere on the board
/Reform 2 Power/Reform 2 LPC/LPCUD_N: R72.2, U18.19 (USB_DM)
/Reform 2 Power/Reform 2 LPC/LPCUD_P: R70.2, U18.20 (USB_DP)
/Reform 2 Power/Reform 2 LPC/LPC_AD5: J22.7, U18.40 (PIO0_16)
/Reform 2 Power/Reform 2 LPC/LPC_AD7: J22.10, U18.42 (PIO0_23)
/Reform 2 Power/Reform 2 LPC/LPC_MISO0: R124.1, U18.27 (PIO0_8)
/Reform 2 Power/Reform 2 LPC/LPC_MISO1a: J22.2, U18.30 (PIO0_22)
/Reform 2 Power/Reform 2 LPC/LPC_MISO1b: R74.2, U18.26 (PIO1_21)
/Reform 2 Power/Reform 2 LPC/LPC_MOSI0: R125.1, U18.28 (PIO0_9)
/Reform 2 Power/Reform 2 LPC/LPC_MOSI1a: J22.14, U18.17 (PIO0_21)
/Reform 2 Power/Reform 2 LPC/LPC_MOSI1b: R75.2, U18.38 (PIO1_22)
/Reform 2 Power/Reform 2 LPC/LPC_RXDa: J22.12, U18.46 (PIO0_18)
/Reform 2 Power/Reform 2 LPC/LPC_RXDc: J23.3, U18.11 (PIO1_26)
/Reform 2 Power/Reform 2 LPC/LPC_SCK0a: R126.1, U18.29 (PIO0_10)
/Reform 2 Power/Reform 2 LPC/LPC_SCK0b: J22.1, U18.31 (PIO1_29)
/Reform 2 Power/Reform 2 LPC/LPC_SCK1b: R73.2, U18.13 (PIO1_20)
/Reform 2 Power/Reform 2 LPC/LPC_SCLKa: J22.9, U18.45 (PIO0_17)
/Reform 2 Power/Reform 2 LPC/LPC_SCLKc: R194.2, U18.24 (PIO1_28)
/Reform 2 Power/Reform 2 LPC/LPC_SSEL0: R157.1, U18.10 (PIO0_2)
/Reform 2 Power/Reform 2 LPC/LPC_SSEL1: R76.2, U18.18 (PIO1_23)
/Reform 2 Power/Reform 2 LPC/LPC_SWDIO: J22.8, U18.39 (PIO0_15)
/Reform 2 Power/Reform 2 LPC/LPC_TDI: J22.4, U18.32 (PIO0_11)
/Reform 2 Power/Reform 2 LPC/LPC_TDO: J22.6, U18.34 (PIO0_13)
/Reform 2 Power/Reform 2 LPC/LPC_TMS: J22.3, U18.33 (PIO0_12)
/Reform 2 Power/Reform 2 LPC/LPC_TXDa: J22.11, U18.47 (PIO0_19)
/Reform 2 Power/Reform 2 LPC/LPC_TXDc: J23.2, U18.12 (PIO1_27)
/Reform 2 Power/Reform 2 LPC/LPC_UFTOGG: SW1.2, U18.4 (PIO0_1)
/Reform 2 Power/Reform 2 LPC/LPC_UVBUS: R195.2, U18.14 (PIO0_3)
/Reform 2 Power/Reform 2 LPC/LPC_~RESET: SW2.2, U18.3 (PIO0_0)
/Reform 2 Power/Reform 2 LPC/LPC_~TRST: J22.5, U18.35 (PIO0_14)
/Reform 2 Power/Reform 2 LPC/LPC_~USBCON: J22.13, U18.22 (PIO0_6)
AUX_PWR_EN: U18.23 (PIO0_7); also elsewhere on the board
BMON_CS: R76.1; also elsewhere on the board
BMON_SCK: R73.1; also elsewhere on the board
BMON_SDI: R75.1; also elsewhere on the board
BMON_SDO: R74.1, R128.1; also elsewhere on the board
CHG_RNG: U18.1 (PIO1_25); also elsewhere on the board
DAC_SCL: U5.6 (SCL); also elsewhere on the board
DAC_SDA: U5.5 (SDA); also elsewhere on the board
GND: BT1.2 (-), C46.2, C47.2, C48.2, C49.2, C50.2, C51.2, C140.1, J8.A1 (GND), J8.A12 (GND), J8.B1 (GND), J8.B12 (GND), J8.S1 (SHIELD), J22.16, J23.4, SW1.1, SW2.1, U5.4 (VSS), U18.5 (VSS), U18.41 (VSS), Y2.2, Y2.4; also elsewhere on the board
IMX_RESETn: R194.1; also elsewhere on the board
IMX_RTC_IRQ: R137.1; also elsewhere on the board
IMX_WAKE: U18.21 (PIO1_24); also elsewhere on the board
INA_SCL: R69.2, U18.15 (PIO0_4); also elsewhere on the board
INA_SDA: R68.2, U18.16 (PIO0_5); also elsewhere on the board
LPC_MISO: R124.2; also elsewhere on the board
LPC_MOSI: R125.2; also elsewhere on the board
LPC_SCK: R126.2; also elsewhere on the board
LPC_SS0: R157.2; also elsewhere on the board
LPC_UART2_RX: U18.37 (PIO1_14); also elsewhere on the board
LPC_UART2_TX: U18.36 (PIO1_13); also elsewhere on the board
LPC_VCC: C46.1, C47.1, C49.1, C50.1, C140.2, J22.15, J23.1, R68.1, R69.1, R71.1, R128.2, R195.1, U5.8 (VDD), U18.8 (VDD), U18.44 (VDD); also elsewhere on the board
unnamed: BT1.1 (+), U5.3 (VBAT)
unnamed: C48.1, U18.7 (XTALOUT), Y2.1
unnamed: C51.1, U18.6 (XTALIN), Y2.3
unnamed: J8.A6 (D+), J8.B6 (D+), R70.1, R71.2
unnamed: J8.A7 (D-), J8.B7 (D-), R72.1
unnamed: R137.2, U5.7 (~INT1/CLKOUT)
unnamed: U5.1 (OSCI), Y4.1
unnamed: U5.2 (OSCO), Y4.2
PCIE1_PWR_EN: U18.9 (PIO0_20); also elsewhere on the board
USB_PWR_EN: U18.25 (PIO1_31); also elsewhere on the board

Notes on the sheet:
TODO: check CCs
System Controller
Expansion Port
I2C lines pulled up by SYS 3v3 power near DAC
Power Switches
Keyboard System Control Port (SYSCTL)
Powered by coin cell when batteries removed
Powered by main batteries in standby
Realtime Clock

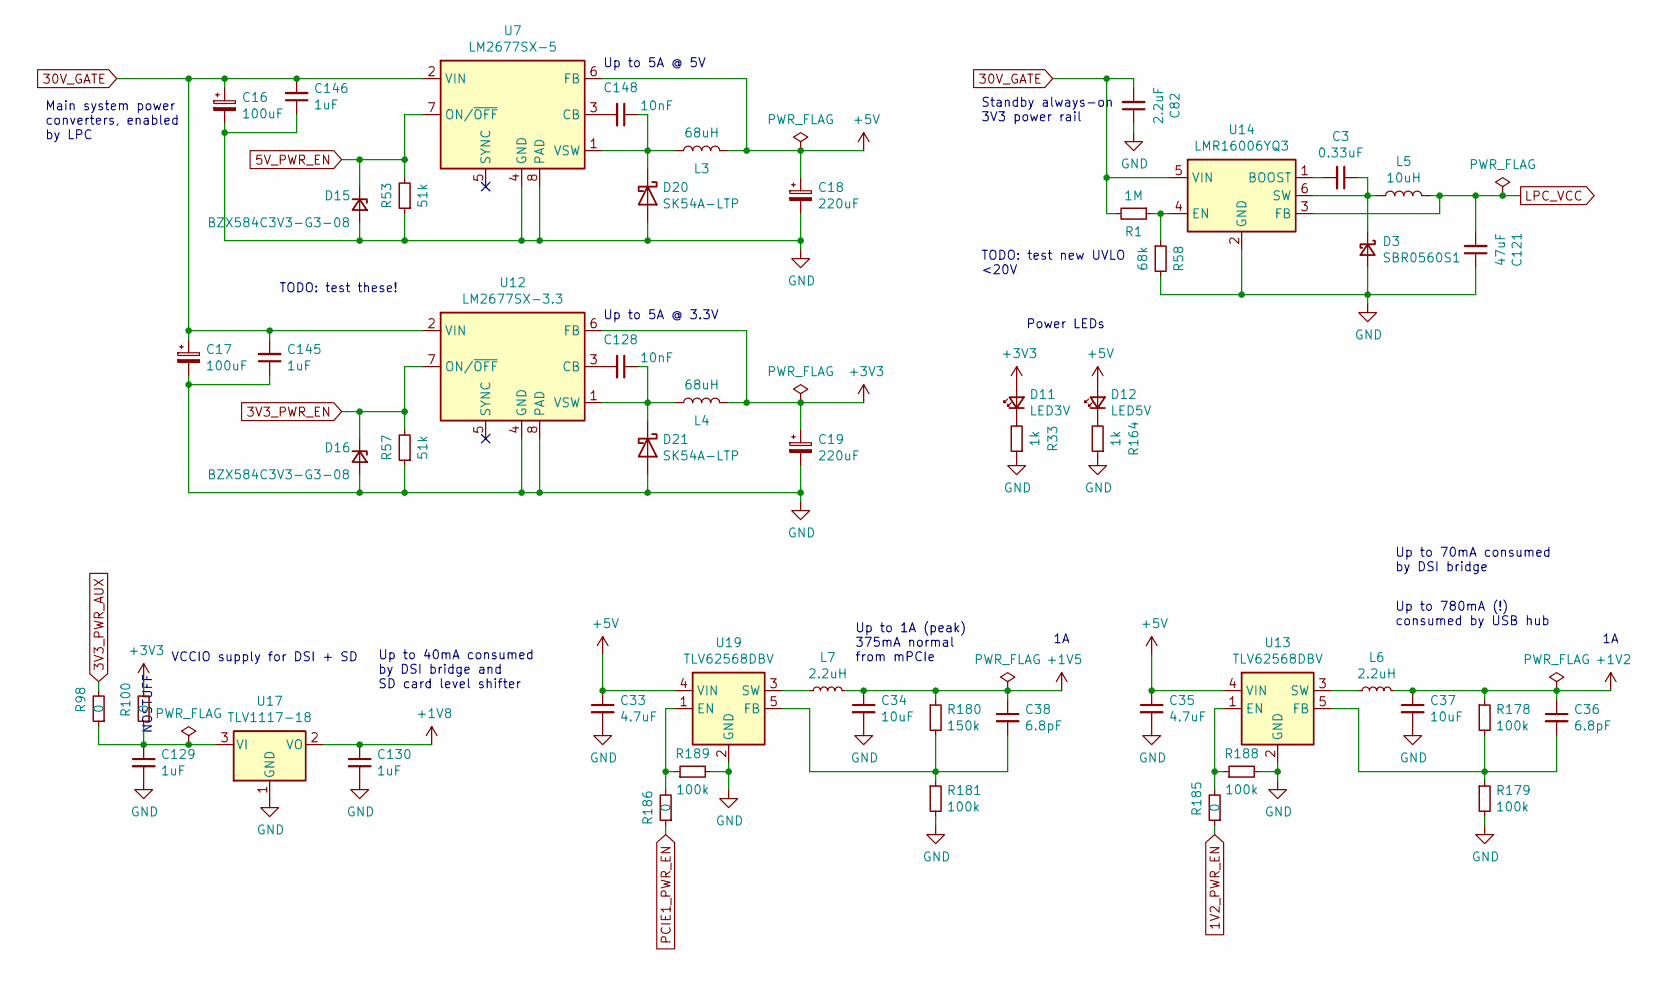
[picture p60: schematic reform2-regulators.kicad_sch, Reform 2 Regulators]

Parts:
C3: 0.33uF; C_0603_1608Metric
C16, C17: 100uF; CP_Elec_8x10
C18, C19: 220uF; CP_Elec_8x10
C33, C35: 4.7uF; C_0603_1608Metric
C34, C37: 10uF; C_0603_1608Metric
C36, C38: 6.8pF; C_0603_1608Metric
C82: 2.2uF; C_0603_1608Metric
C121: 47uF; C_0603_1608Metric
C128, C148: 10nF; C_0603_1608Metric
C129, C130, C145, C146: 1uF; C_0603_1608Metric
D3: SBR0560S1; D_SOD-123
D11: LED3V; LED_0603_1608Metric
D12: LED5V; LED_0603_1608Metric
D15, D16: BZX584C3V3-G3-08; D_SOD-523
D20, D21: SK54A-LTP; D_SMA
L3, L4: 68uH; L_Bourns_SRR1210A
L5: 10uH; L_1210_3225Metric
L6, L7: 2.2uH; L_1210_3225Metric
R1: 1M; R_0603_1608Metric
R33, R164: 1k; R_0603_1608Metric
R53, R57: 51k; R_0603_1608Metric
R58: 68k; R_0603_1608Metric
R98, R100, R185, R186: 0; R_0603_1608Metric
R178, R179, R181, R188, R189: 100k; R_0603_1608Metric
R180: 150k; R_0603_1608Metric
U7: LM2677SX-5; TO-263-7_TabPin8
U12: LM2677SX-3.3; TO-263-7_TabPin8
U13, U19: TLV62568DBV; SOT-23-5
U14: LMR16006YQ3; TSOT-23-6
U17: TLV1117-18; SOT-223

Connections:
1V2_PWR_EN: R185.1; also elsewhere on the board
3V3_PWR_AUX: R98.2; also elsewhere on the board
3V3_PWR_EN: D16.1 (K), R57.2, U12.7 (ON/~OFF); also elsewhere on the board
5V_PWR_EN: D15.1 (K), R53.2, U7.7 (ON/~OFF); also elsewhere on the board
30V_GATE: C16.1, C17.1, C82.2, C145.2, C146.2, R1.2, U7.2 (VIN), U12.2 (VIN), U14.5 (VIN); also elsewhere on the board
+1V2: C36.1, C37.1, L6.2, R178.1; also elsewhere on the board
+1V5: C34.1, C38.1, L7.2, R180.1; also elsewhere on the board
+1V8: C130.1, U17.2 (VO); also elsewhere on the board
+3V3: C19.1, D11.2 (A), L4.2, R100.2, U12.6 (FB); also elsewhere on the board
+5V: C18.1, C33.1, C35.1, D12.2 (A), L3.2, U7.6 (FB), U13.4 (VIN), U19.4 (VIN); also elsewhere on the board
GND: C16.2, C17.2, C18.2, C19.2, C33.2, C34.2, C35.2, C37.2, C82.1, C121.1, C129.2, C130.2, C145.1, C146.1, D3.2 (A), D15.2 (A), D16.2 (A), D20.2 (A), D21.2 (A), R33.1, R53.1, R57.1, R58.2, R164.1, R179.2, R181.2, R188.2, R189.2, U7.4 (GND), U7.8 (PAD), U12.4 (GND), U12.8 (PAD), U13.2 (GND), U14.2 (GND), U17.1 (GND), U19.2 (GND); also elsewhere on the board
LPC_VCC: C121.2, L5.2, U14.3 (FB); also elsewhere on the board
unnamed: C3.1, D3.1 (K), L5.1, U14.6 (SW)
unnamed: C3.2, U14.1 (BOOST)
unnamed: C36.2, R178.2, R179.1, U13.5 (FB)
unnamed: C38.2, R180.2, R181.1, U19.5 (FB)
unnamed: C128.1, D21.1 (K), L4.1, U12.1 (VSW)
unnamed: C128.2, U12.3 (CB)
unnamed: C129.1, R98.1, R100.1, U17.3 (VI)
unnamed: C148.1, D20.1 (K), L3.1, U7.1 (VSW)
unnamed: C148.2, U7.3 (CB)
unnamed: D11.1 (K), R33.2
unnamed: D12.1 (K), R164.2
unnamed: L6.1, U13.3 (SW)
unnamed: L7.1, U19.3 (SW)
unnamed: R1.1, R58.1, U14.4 (EN)
unnamed: R185.2, R188.1, U13.1 (EN)
unnamed: R186.2, R189.1, U19.1 (EN)
PCIE1_PWR_EN: R186.1; also elsewhere on the board

Notes on the sheet:
Standby always-on 3V3 power rail
Power LEDs
TODO: test new UVLO <20V
NOSTUFF
Up to 1A (peak) 375mA normal from mPCIe
Up to 70mA consumed by DSI bridge
Up to 780mA (!) consumed by USB hub
Up to 5A @ 5V
TODO: test these!
Up to 5A @ 3.3V
VCCIO supply for DSI + SD
Up to 40mA consumed by DSI bridge and SD card level shifter
Main system power converters, enabled by LPC

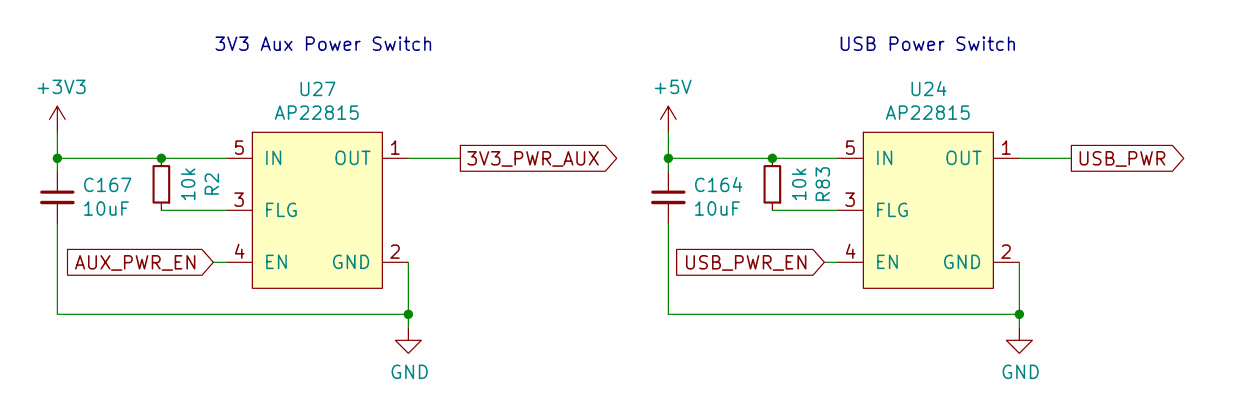
[picture p61: schematic reform2-usbpwr.kicad_sch, Reform 2 USB Power]

Parts:
C164, C167: 10uF; C_0603_1608Metric
R2, R83: 10k; R_0603_1608Metric
U24, U27: AP22815; TSOT-25

Connections:
3V3_PWR_AUX: U27.1 (OUT); also elsewhere on the board
+3V3: C167.1, R2.2, U27.5 (IN); also elsewhere on the board
+5V: C164.1, R83.2, U24.5 (IN); also elsewhere on the board
AUX_PWR_EN: U27.4 (EN); also elsewhere on the board
GND: C164.2, C167.2, U24.2 (GND), U27.2 (GND); also elsewhere on the board
unnamed: R2.1, U27.3 (FLG)
unnamed: R83.1, U24.3 (FLG)
USB_PWR: U24.1 (OUT); also elsewhere on the board
USB_PWR_EN: U24.4 (EN); also elsewhere on the board

Notes on the sheet:
3V3 Aux Power Switch
USB Power Switch
