jackhumbert/reform/reform2-motherboard25-pcb/reform2-motherboard25.kicad_pcb

## KiCad design reform2-motherboard25-pcb/reform2-motherboard25.kicad_pcb (continued)

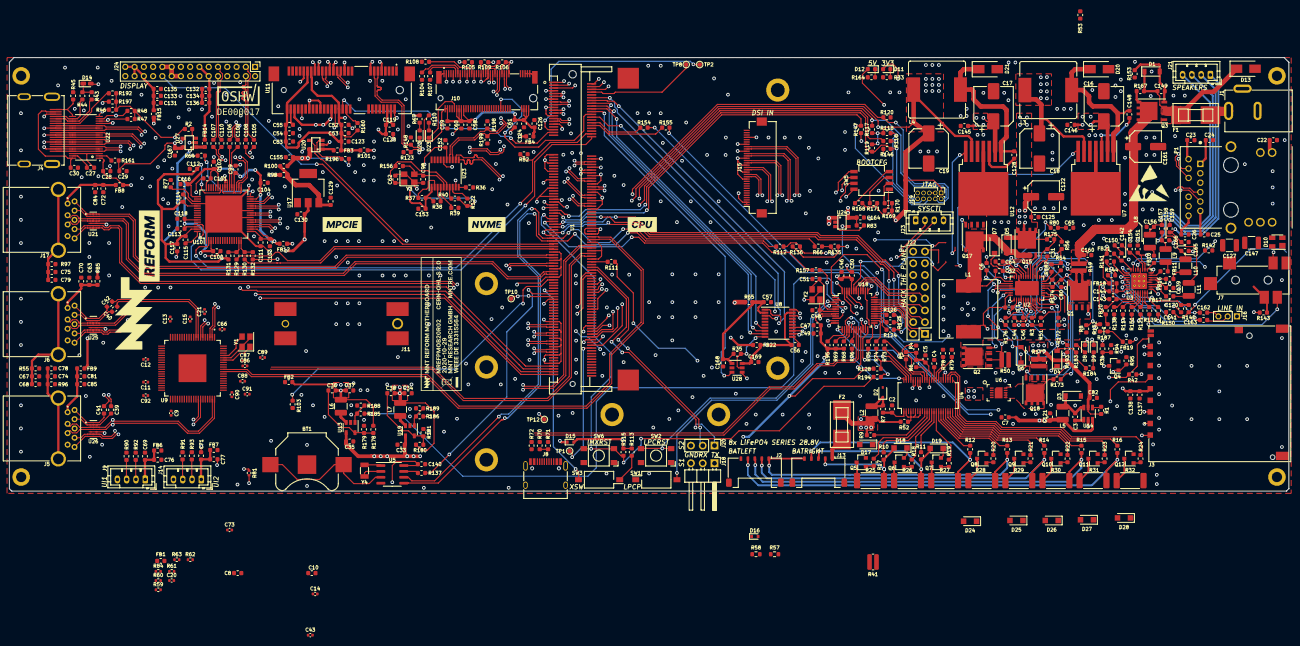
[picture p62: board reform2-motherboard25.kicad_pcb from above]

Board: 6 copper layers, 276.0 x 93.5 mm, 504 parts (0 on the bottom side), 439 nets.
