jackhumbert/reform/reform2-batterypack-pcb/reform2-batterypack-upstream.kicad_pcb

## KiCad design reform2-batterypack-pcb/reform2-batterypack-upstream.kicad_pcb (2022-09-01)

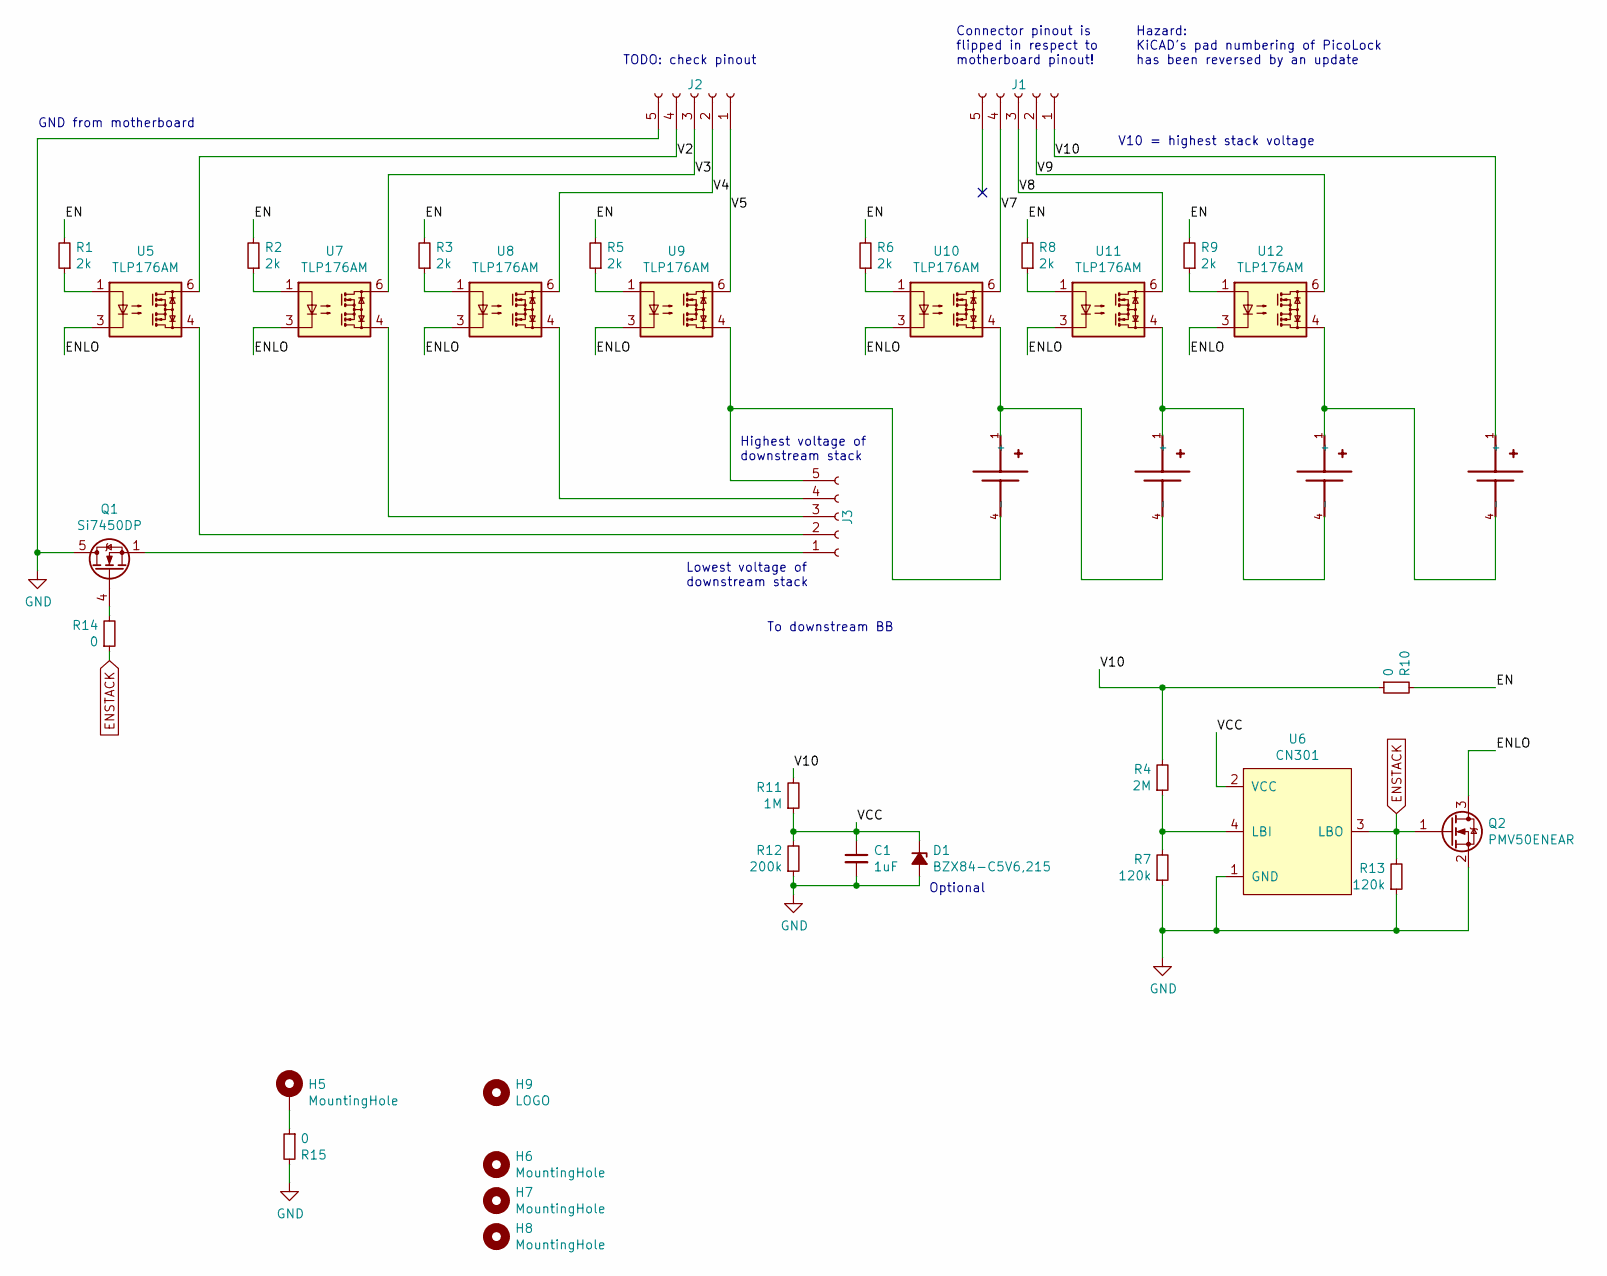
[picture p63: schematic reform2-batterypack-upstream.sch, MNT Reform 2 Upstream Battery Pack]

Parts:
C1: 1uF; C_0603_1608Metric
D1: BZX84-C5V6,215; D_SOT-23_ANK
H5, H6, H7, H8: MountingHole; MountingHole_2.2mm_M2
H9: LOGO; reform2-batterypack-badge-d5
J1, J2, J3: Conn_01x05_Female; Molex_Pico-Lock_504050-0591_1x05-1MP_P1.50mm_Horizontal
Q1: Si7450DP; PowerPAK_SO-8_Single
Q2: PMV50ENEAR; SOT-23
R1, R2, R3, R5, R6, R8, R9: 2k; R_0603_1608Metric
R4: 2M; R_0603_1608Metric
R7, R13: 120k; R_0603_1608Metric
R10, R14, R15: 0; R_0603_1608Metric
R11: 1M; R_0603_1608Metric
R12: 200k; R_0603_1608Metric
U1, U2, U3, U4: KEYSTONE_54; Keystone54
U5, U7, U8, U9, U10, U11, U12: TLP176AM; MFSOP6-4_4.4x3.6mm_P1.27mm
U6: CN301; SOT-23-5

Connections:
/EN: R1.2, R2.2, R3.2, R5.2, R6.2, R8.2, R9.2, R10.2
/ENLO: Q2.3 (D), U5.3, U7.3, U8.3, U9.3, U10.3, U11.3, U12.3
/V2: J2.4, U5.6
/V3: J2.3, U7.6
/V4: J2.2, U8.6
/V5: J2.1, U9.6
/V7: J1.4, U10.6
/V8: J1.3, U11.6
/V9: J1.2, U12.6
/V10: J1.1, R4.2, R10.1, R11.2, U4.1 (+), U4.2 (+), U4.3 (+)
/VCC: C1.1, D1.1 (K), R11.1, R12.2, U6.2 (VCC)
ENSTACK: Q1.4 (G), Q2.1 (G), R13.2, R14.1, R14.2, U6.3 (LBO)
GND: C1.2, D1.2 (A), J2.5, Q1.5 (D), Q2.2 (S), R7.1, R12.1, R13.1, R15.2, U6.1 (GND)
unnamed: J3.1, Q1.1 (S), Q1.2 (S), Q1.3 (S)
unnamed: J3.2, U5.4
unnamed: J3.3, U7.4
unnamed: J3.4, U8.4
unnamed: J3.5, U1.4 (-), U1.5 (-), U1.6 (-), U9.4
unnamed: R1.1, U5.1
unnamed: R2.1, U7.1
unnamed: R3.1, U8.1
unnamed: R4.1, R7.2, U6.4 (LBI)
unnamed: R5.1, U9.1
unnamed: R6.1, U10.1
unnamed: R8.1, U11.1
unnamed: R9.1, U12.1
unnamed: H5.1, R15.1
unnamed: U1.1 (+), U1.2 (+), U1.3 (+), U2.4 (-), U2.5 (-), U2.6 (-), U10.4
unnamed: U2.1 (+), U2.2 (+), U2.3 (+), U3.4 (-), U3.5 (-), U3.6 (-), U11.4
unnamed: U3.1 (+), U3.2 (+), U3.3 (+), U4.4 (-), U4.5 (-), U4.6 (-), U12.4

Notes on the sheet:
Connector pinout is flipped in respect to motherboard pinout!
V10 = highest stack voltage
To downstream BB
TODO: check pinout
GND from motherboard
Lowest voltage of downstream stack
Highest voltage of downstream stack
Optional
Hazard: KiCAD's pad numbering of PicoLock has been reversed by an update

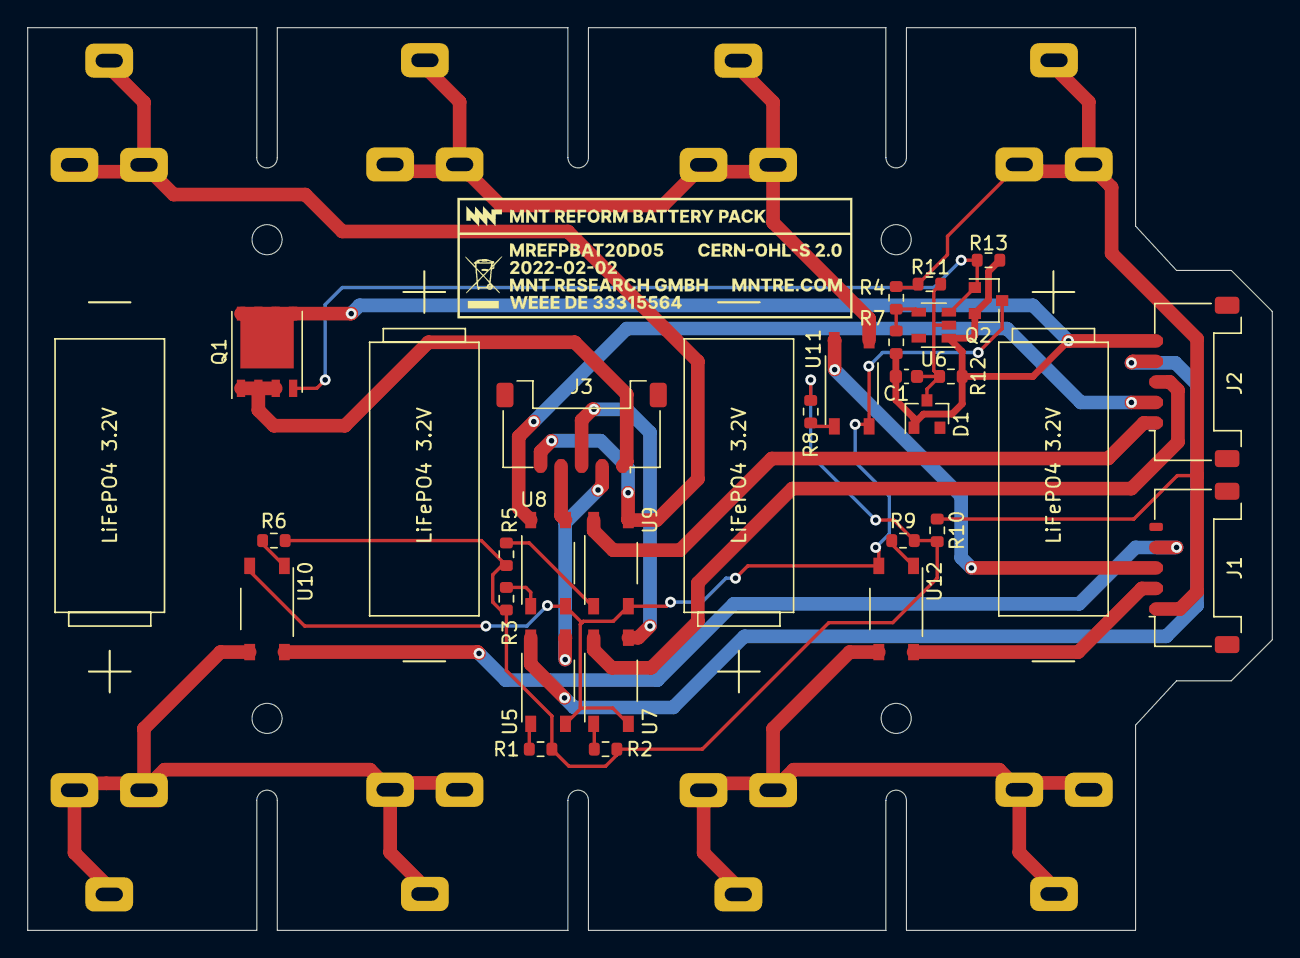
[picture p64: board reform2-batterypack-upstream.kicad_pcb from above]

Board: 2 copper layers, 91.0 x 66.0 mm, 37 parts (0 on the bottom side), 29 nets.
