jackhumbert/reform/reform2-trackball2-pcb/reform2-trackball2.kicad_pcb

## KiCad design reform2-trackball2-pcb/reform2-trackball2.kicad_pcb (2022-09-01)

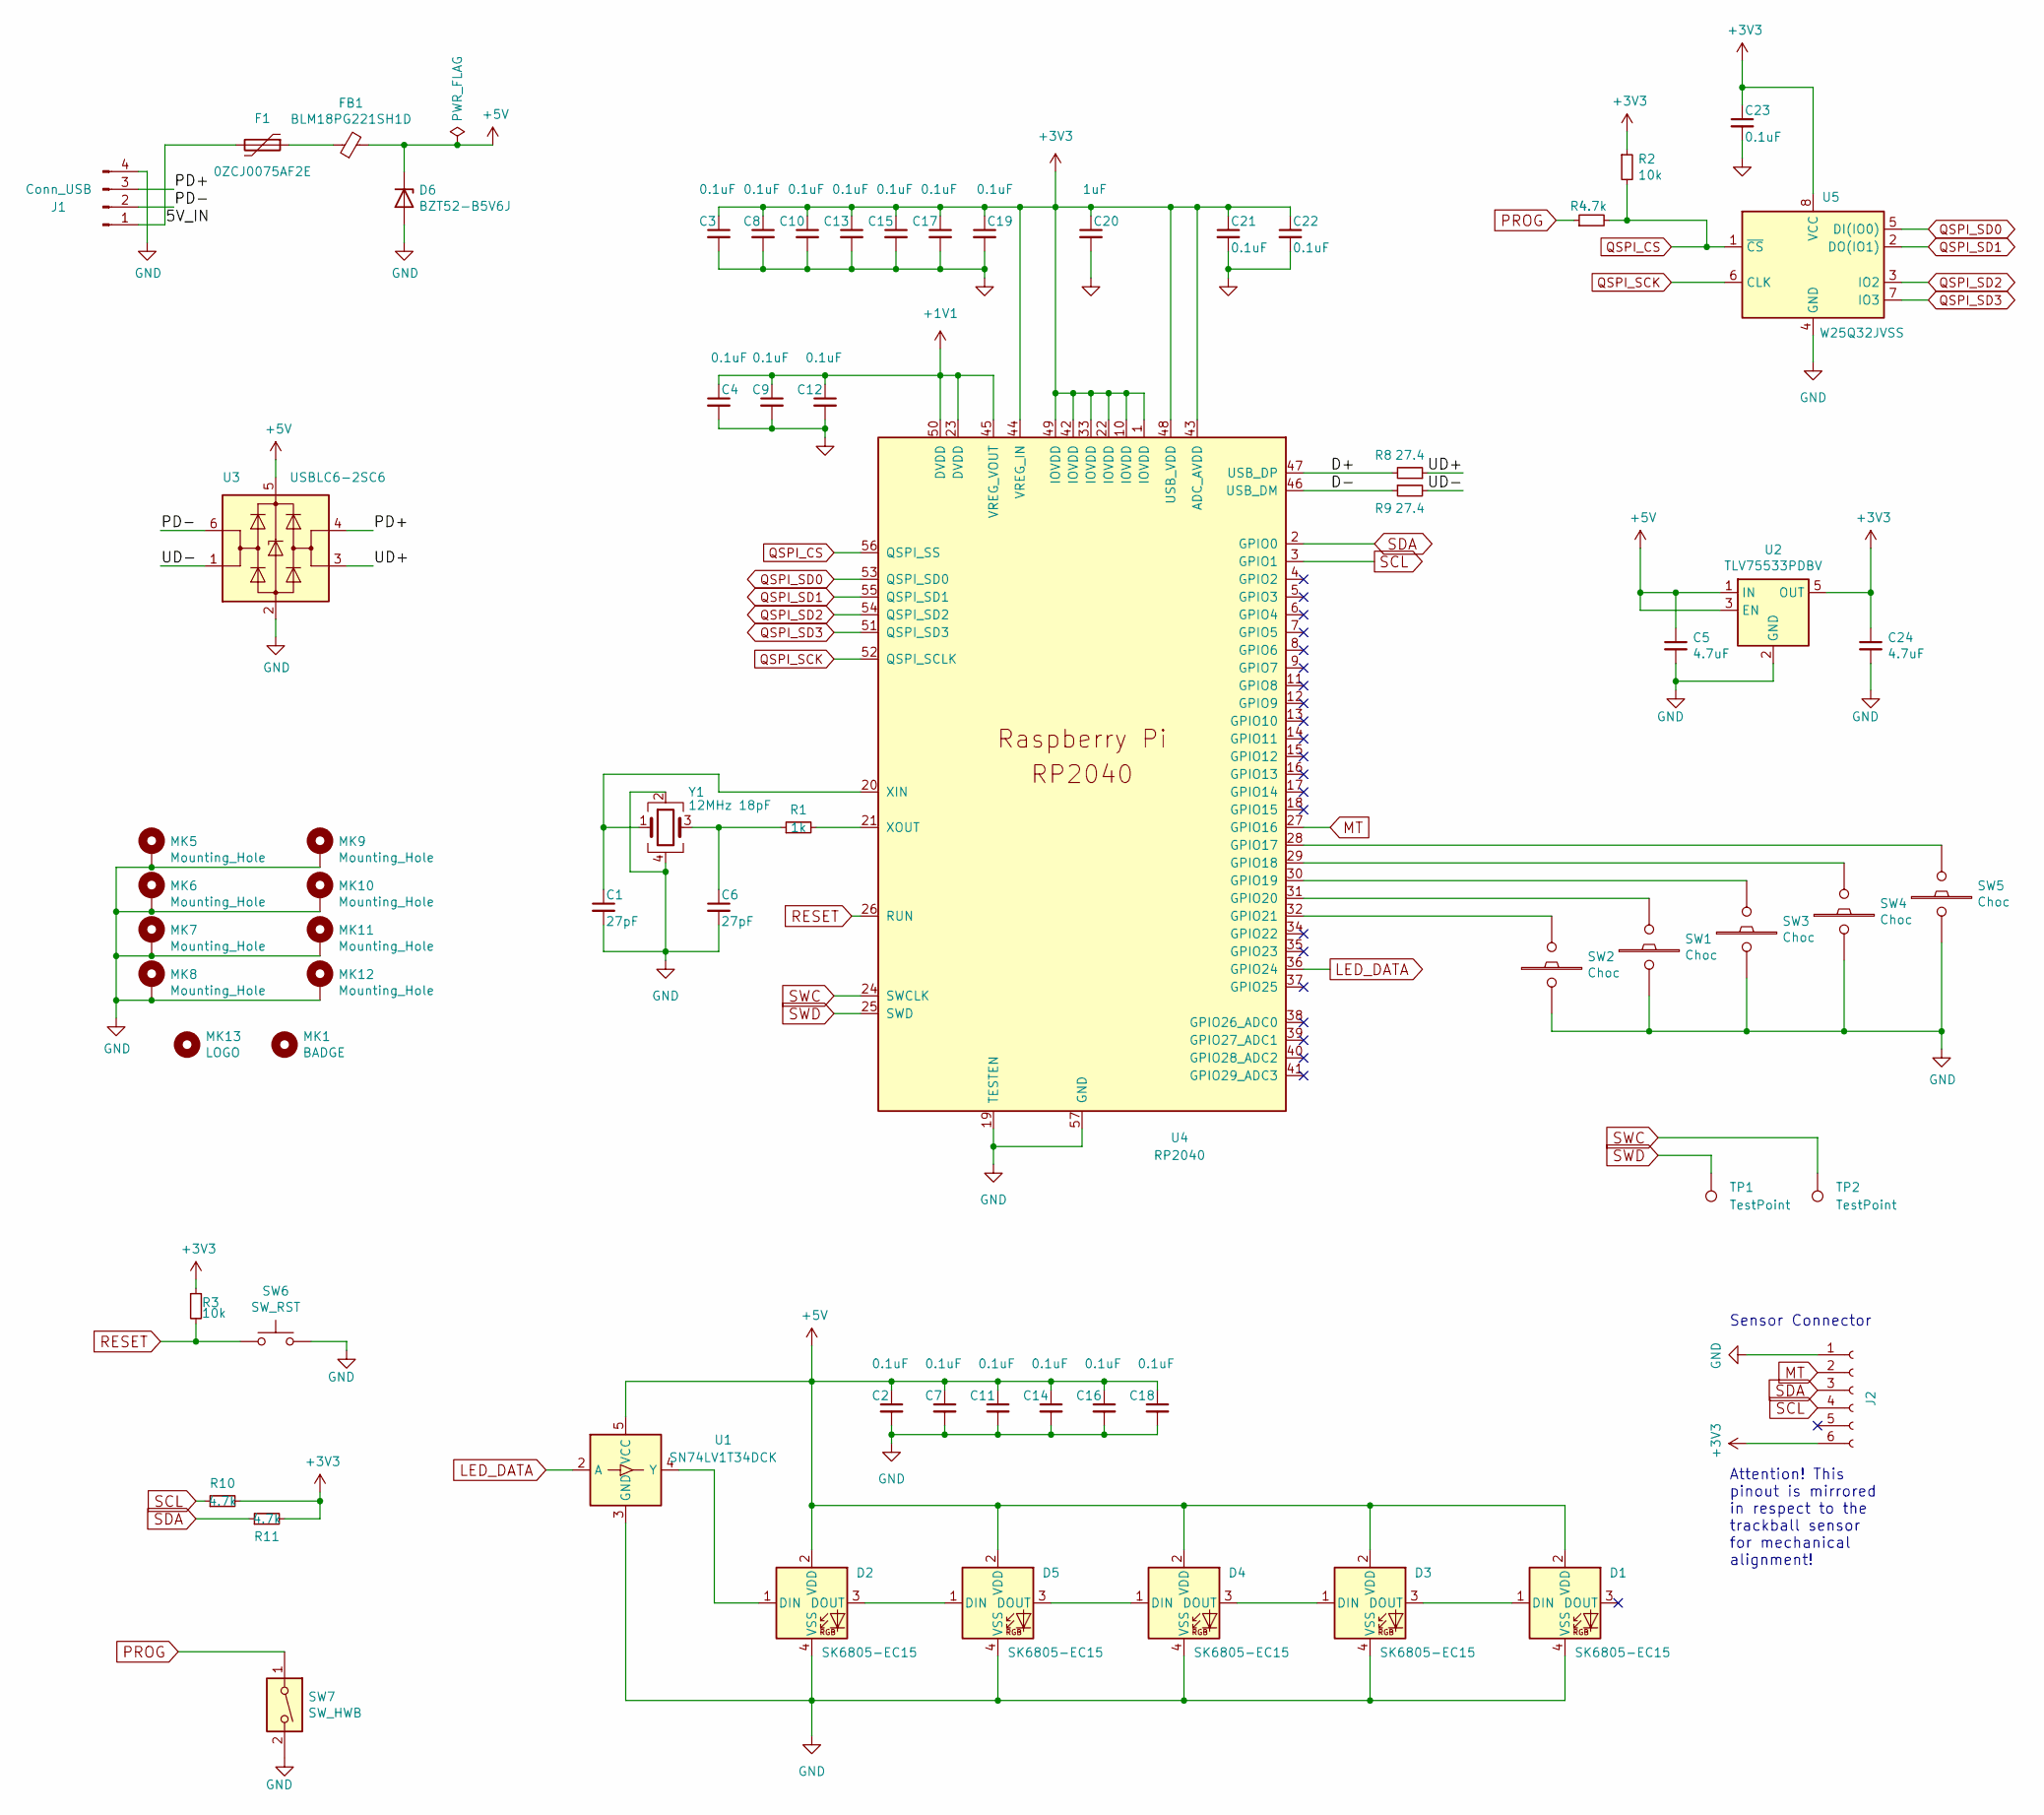
[picture p65: schematic reform2-trackball2.kicad_sch, MNT Reform 2 Trackball 2.0 (Fixed)]

Parts:
C1, C6: 27pF; C_0603_1608Metric; LCSC C107045
C2, C3, C4, C7, C8, C9, C10, C11, C12, C13, C14, C15, C16, C17, C18, C19, C21, C22, C23: 0.1uF; C_0603_1608Metric; LCSC C14663
C5, C24: 4.7uF; C_0603_1608Metric; LCSC C90057
C20: 1uF; C_0603_1608Metric; LCSC C14664
D1, D2, D3, D4, D5: SK6805-EC15; LCSC C2890035
D6: BZT52-B5V6J; D_SOD-123; LCSC C173406
F1: 0ZCJ0075AF2E; Fuse_1206_3216Metric_Castellated; LCSC C70082
FB1: BLM18PG221SH1D; L_0603_1608Metric; LCSC C14709
J1: Conn_USB; JST_PH_B4B-PH-K_1x04_P2.00mm_Vertical; LCSC C131334
J2: Conn_01x06_Female; Hirose_FH12-6S-0.5SH_1x06-1MP_P0.50mm_Horizontal; LCSC C202118
MK1: BADGE; mntreform-trackball-badge; LCSC DNP
MK5, MK6, MK7, MK8, MK9, MK10, MK11, MK12: Mounting_Hole; MountingHole_2.2mm_M2_Pad; LCSC DNP
MK13: LOGO; mntreform; LCSC DNP
R1: 1k; R_0603_1608Metric
R2, R3: 10k; R_0603_1608Metric; LCSC C99198
R4, R10, R11: 4.7k; R_0603_1608Metric; LCSC C105428
R8, R9: 27.4; R_0603_1608Metric; LCSC C185346
SW1, SW2, SW3, SW4, SW5: Choc; PG1350; LCSC C400231
SW6: SW_RST; Diptronics-PTLP2; LCSC C318893
SW7: SW_HWB; SW_DIP_SPSTx01_Slide_Omron_A6S-110x_W8.9mm_P2.54mm; LCSC C402914
TP1, TP2: TestPoint; TestPoint_Pad_D1.0mm; LCSC DNP
U1: SN74LV1T34DCK; SOT-353_SC-70-5; LCSC C78541
U2: TLV75533PDBV; SOT-23-5; LCSC C404027
U3: USBLC6-2SC6; SOT-23-6; LCSC C7519
U4: RP2040; RP2040-QFN-56; LCSC C2040
U5: W25Q32JVSS; SOIC-8_5.23x5.23mm_P1.27mm; LCSC C82344
Y1: 12MHz 18pF; Crystal_SMD_3225-4Pin_3.2x2.5mm; LCSC C91749

Connections:
+1V1: C4.1, C9.1, C12.1, U4.23 (DVDD), U4.45 (VREG_VOUT), U4.50 (DVDD)
/5V_IN: F1.2, J1.1
/D+: R8.2, U4.47 (USB_DP)
/D-: R9.1, U4.46 (USB_DM)
/PD+: J1.3, U3.4 (I/O2)
/PD-: J1.2, U3.6 (I/O1)
/UD+: R8.1, U3.3 (I/O2)
/UD-: R9.2, U3.1 (I/O1)
LED_DATA: U1.2 (A), U4.36 (GPIO24)
MT: J2.2, U4.27 (GPIO16)
unnamed: C1.1, U4.20 (XIN), Y1.1
unnamed: C6.1, R1.1, Y1.3
unnamed: D1.1 (DIN), D3.3 (DOUT)
unnamed: D2.1 (DIN), U1.4 (Y)
unnamed: D2.3 (DOUT), D5.1 (DIN)
unnamed: D3.1 (DIN), D4.3 (DOUT)
unnamed: D4.1 (DIN), D5.3 (DOUT)
unnamed: F1.1, FB1.1
unnamed: R1.2, U4.21 (XOUT)
unnamed: SW1.1, U4.31 (GPIO20)
unnamed: SW2.1, U4.32 (GPIO21)
unnamed: SW3.1, U4.30 (GPIO19)
unnamed: SW4.1, U4.29 (GPIO18)
unnamed: SW5.1, U4.28 (GPIO17)
PROG: R4.1, SW7.1
QSPI_CS: R2.2, R4.2, U4.56 (QSPI_SS), U5.1 (~CS)
QSPI_SCK: U4.52 (QSPI_SCLK), U5.6 (CLK)
QSPI_SD0: U4.53 (QSPI_SD0), U5.5 (DI(IO0))
QSPI_SD1: U4.55 (QSPI_SD1), U5.2 (DO(IO1))
QSPI_SD2: U4.54 (QSPI_SD2), U5.3 (IO2)
QSPI_SD3: U4.51 (QSPI_SD3), U5.7 (IO3)
RESET: R3.2, SW6.1, U4.26 (RUN)
SCL: J2.4, R10.1, U4.3 (GPIO1)
SDA: J2.3, R11.1, U4.2 (GPIO0)
SWC: TP2.1, U4.24 (SWCLK)
SWD: TP1.1, U4.25 (SWD)

Notes on the sheet:
Sensor Connector
Attention! This pinout is mirrored in respect to the trackball sensor for mechanical alignment!

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
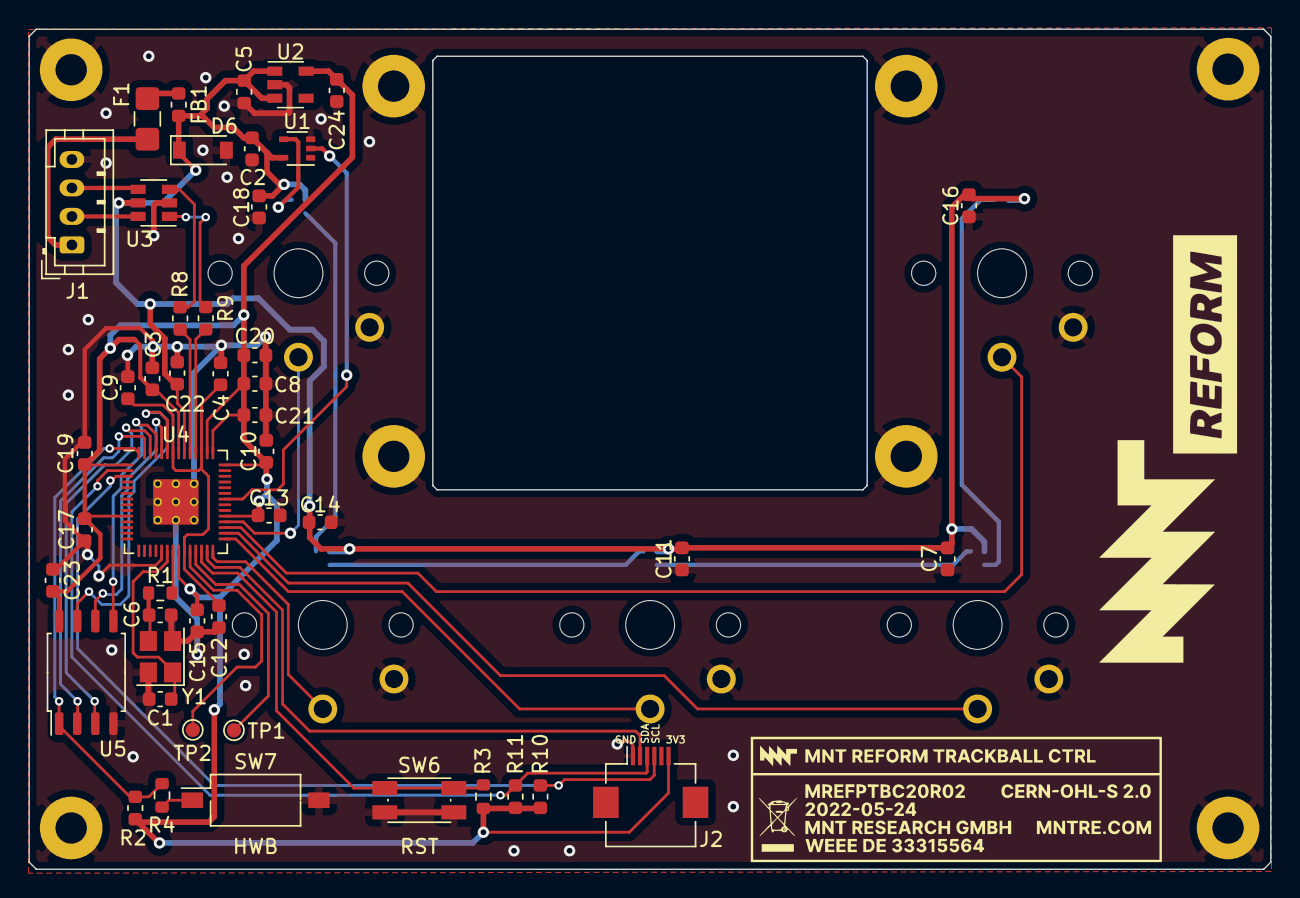
[picture p66: board reform2-trackball2.kicad_pcb from above]

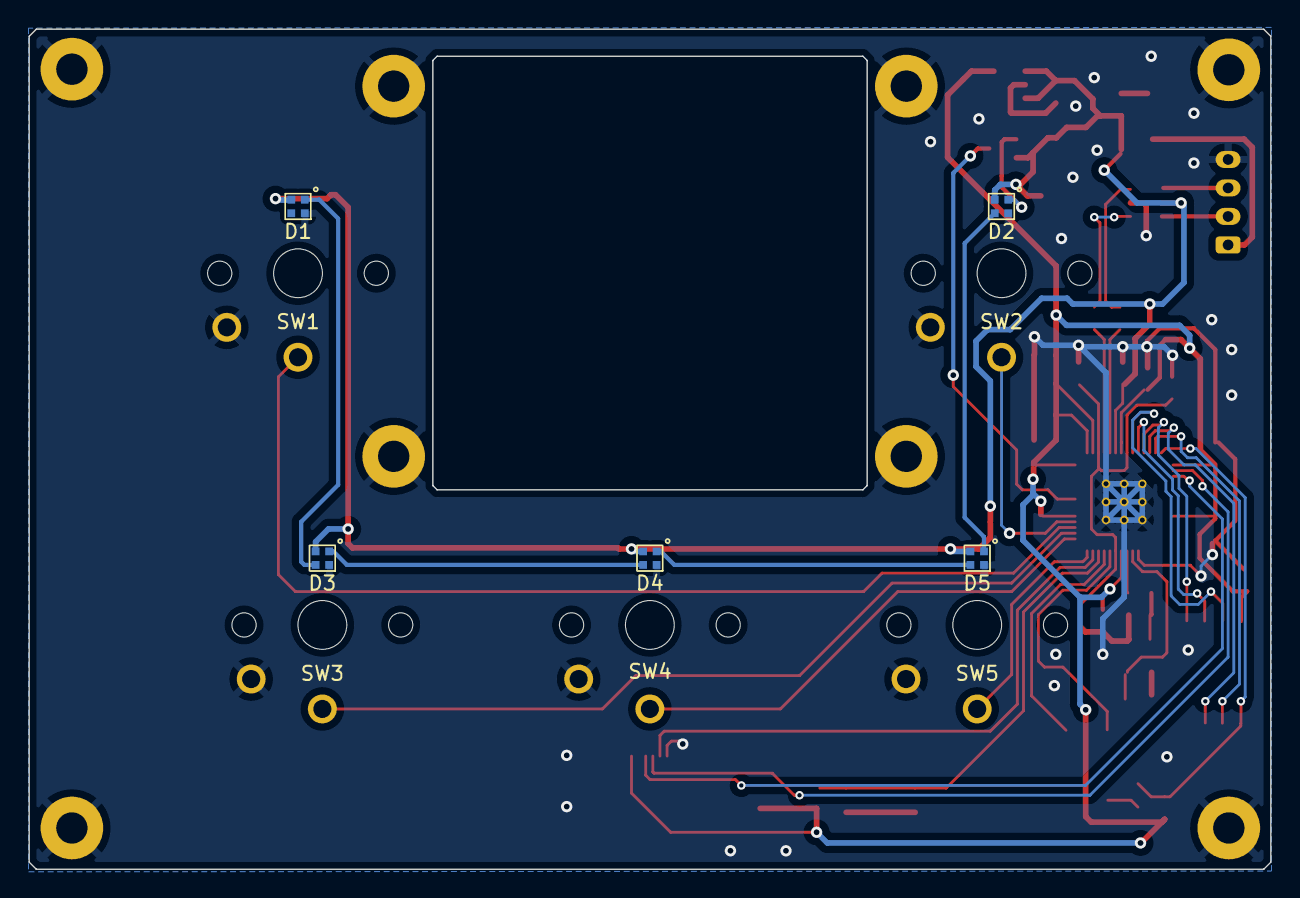
[picture p67: board reform2-trackball2.kicad_pcb from below]

Board: 2 copper layers, 87.2 x 59.0 mm, 67 parts (10 on the bottom side), 39 nets.
