jackhumbert/reform/reform2-keyboard-pcb/reform2-keyboard.kicad_pcb

## KiCad design reform2-keyboard-pcb/reform2-keyboard.kicad_pcb (continued)

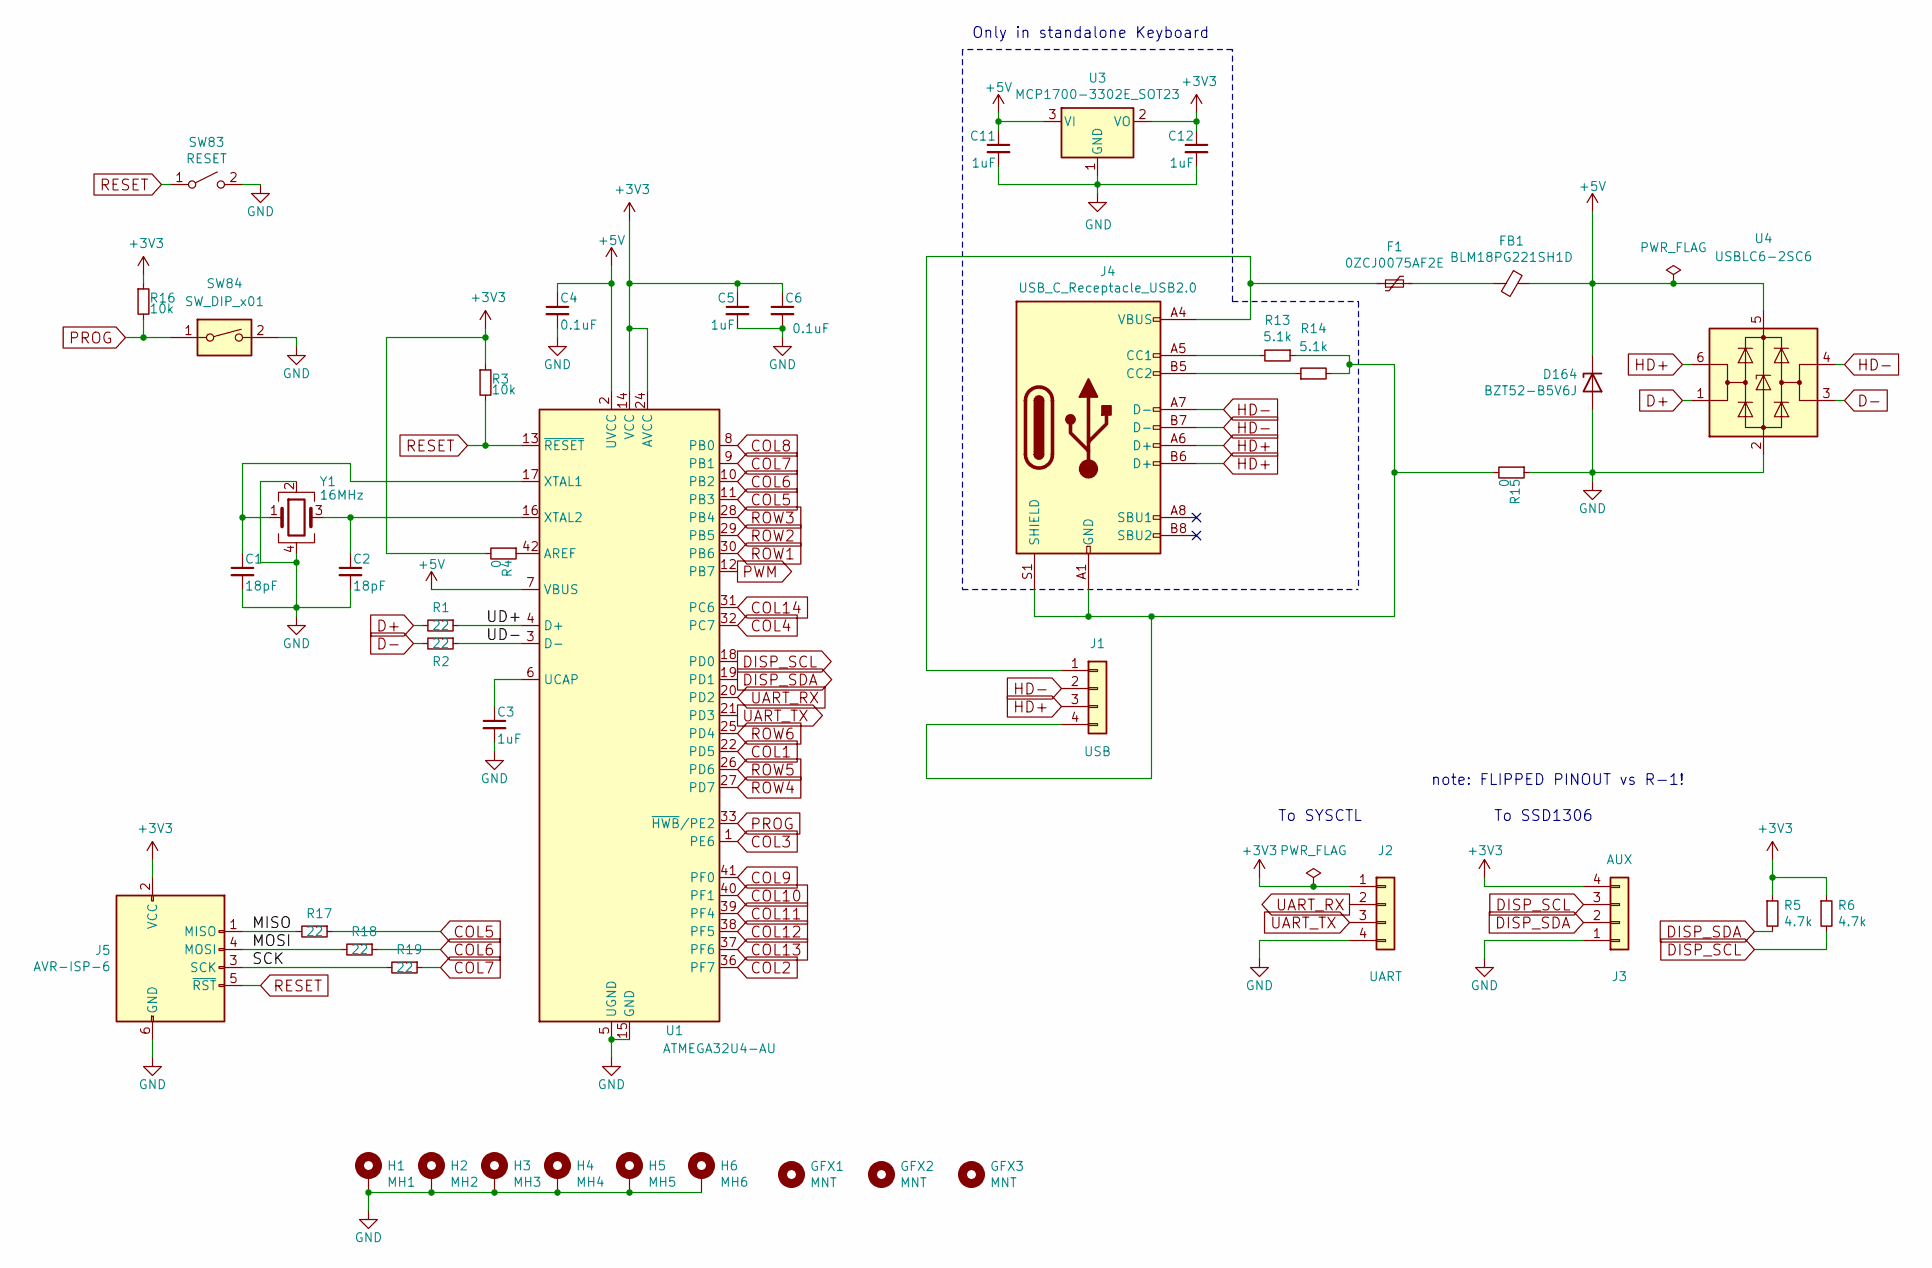
[picture p69: schematic reform-kbd-mcu.sch, MNT Reform 2 Keyboard]

Parts:
C1, C2: 18pF; C_0603_1608Metric; LCSC C107040
C3, C5, C11, C12: 1uF; C_0603_1608Metric; LCSC C14664
C4, C6: 0.1uF; C_0603_1608Metric; LCSC C14663
D164: BZT52-B5V6J; D_SOD-123; LCSC C173406
F1: 0ZCJ0075AF2E; R_1206_3216Metric; LCSC C70082
FB1: BLM18PG221SH1D; L_0603_1608Metric; LCSC C14709
GFX1, GFX2: MNT; mntreform
GFX3: MNT; mnt-reform-keyboard-r2-badge
H1: MH1; MountingHole_2.2mm_M2_Pad
H2: MH2; MountingHole_2.2mm_M2_Pad
H3: MH3; MountingHole_2.2mm_M2_Pad
H4: MH4; MountingHole_2.2mm_M2_Pad
H5: MH5; MountingHole_2.2mm_M2_Pad
H6: MH6; MountingHole_2.2mm_M2_Pad
J1: USB; JST_PH_S4B-PH-SM4-TB_1x04-1MP_P2.00mm_Horizontal; LCSC C265332
J2: UART; JST_PH_S4B-PH-SM4-TB_1x04-1MP_P2.00mm_Horizontal; LCSC C265332
J3: AUX; Molex_200528-0040_1x04-1MP_P1.00mm_Horizontal; LCSC C555410
J4: USB_C_Receptacle_USB2.0; USB_C_Receptacle_HRO_TYPE-C-31-M-12; LCSC C165948
J5: AVR-ISP-6; PinHeader_2x03_P2.54mm_Vertical
R1, R2, R17, R18, R19: 22; R_0603_1608Metric; LCSC C107701
R3, R16: 10k; R_0603_1608Metric; LCSC C99198
R4, R15: 0; R_0603_1608Metric; LCSC C95177
R5, R6: 4.7k; R_0603_1608Metric; LCSC C105428
R13, R14: 5.1k; R_0603_1608Metric; LCSC C105580
SW83: RESET; SW_Push_1P1T_NO_CK_KMR2; LCSC C318893
SW84: SW_DIP_x01; SW_DIP_SPSTx01_Slide_Omron_A6S-110x_W8.9mm_P2.54mm; LCSC C402914
U1: ATMEGA32U4-AU; TQFP-44_10x10mm_Pitch0.8mm
U3: MCP1700-3302E_SOT23; SOT-23; LCSC C39051
U4: USBLC6-2SC6; SOT-23-6; LCSC C2687116
Y1: 16MHz; Crystal_SMD_3225-4Pin_3.2x2.5mm; LCSC C70562

Connections:
+3V3: C5.1, C6.1, C12.1, J2.1, J3.4, J5.2 (VCC), R3.1, R4.2, R5.1, R6.1, R16.1, U1.14 (VCC), U1.24 (AVCC), U1.34 (VCC), U1.44 (AVCC), U3.2 (VO)
+5V: C4.1, C11.1, D164.1 (K), FB1.1, U1.2 (UVCC), U1.7 (VBUS), U3.3 (VI), U4.5 (VBUS); also elsewhere on the board
/Reform KBD MCU/MISO: J5.1 (MISO), R17.2
/Reform KBD MCU/MOSI: J5.4 (MOSI), R18.2
/Reform KBD MCU/SCK: J5.3 (SCK), R19.2
/Reform KBD MCU/UD+: R1.1, U1.4 (D+)
/Reform KBD MCU/UD-: R2.1, U1.3 (D-)
COL1: U1.22 (PD5); also elsewhere on the board
COL2: U1.36 (PF7); also elsewhere on the board
COL3: U1.1 (PE6); also elsewhere on the board
COL4: U1.32 (PC7); also elsewhere on the board
COL5: R17.1, U1.11 (PB3); also elsewhere on the board
COL6: R18.1, U1.10 (PB2); also elsewhere on the board
COL7: R19.1, U1.9 (PB1); also elsewhere on the board
COL8: U1.8 (PB0); also elsewhere on the board
COL9: U1.41 (PF0); also elsewhere on the board
COL10: U1.40 (PF1); also elsewhere on the board
COL11: U1.39 (PF4); also elsewhere on the board
COL12: U1.38 (PF5); also elsewhere on the board
COL13: U1.37 (PF6); also elsewhere on the board
COL14: U1.31 (PC6); also elsewhere on the board
D+: R1.2, U4.1 (I/O1)
D-: R2.2, U4.3 (I/O2)
DISP_SCL: J3.3, R6.2, U1.18 (PD0)
DISP_SDA: J3.2, R5.2, U1.19 (PD1)
GND: C1.2, C2.2, C3.2, C4.2, C5.2, C6.2, C11.2, C12.2, D164.2 (A), H1.1, H2.1, H3.1, H4.1, H5.1, H6.1, J2.4, J3.1, J5.6 (GND), R15.1, SW83.2 (B), SW84.2, U1.5 (UGND), U1.15 (GND), U1.23 (GND), U1.35 (GND), U1.43 (GND), U3.1 (GND), U4.2 (GND), Y1.2, Y1.4; also elsewhere on the board
HD+: J1.3, J4.A6 (D+), J4.B6 (D+), U4.6 (I/O1)
HD-: J1.2, J4.A7 (D-), J4.B7 (D-), U4.4 (I/O2)
unnamed: C1.1, U1.17 (XTAL1), Y1.1
unnamed: C2.1, U1.16 (XTAL2), Y1.3
unnamed: C3.1, U1.6 (UCAP)
unnamed: F1.1, J1.1, J4.A4 (VBUS), J4.A9 (VBUS), J4.B4 (VBUS), J4.B9 (VBUS)
unnamed: F1.2, FB1.2
unnamed: J1.4, J4.A1 (GND), J4.A12 (GND), J4.B1 (GND), J4.B12 (GND), J4.S1 (SHIELD), R13.1, R14.2, R15.2
unnamed: J4.A5 (CC1), R13.2
unnamed: J4.B5 (CC2), R14.1
unnamed: R4.1, U1.42 (AREF)
PROG: R16.2, SW84.1, U1.33 (~HWB~/PE2)
PWM: U1.12 (PB7); also elsewhere on the board
RESET: J5.5 (~RST), R3.2, SW83.1 (A), U1.13 (~RESET)
ROW1: U1.30 (PB6); also elsewhere on the board
ROW2: U1.29 (PB5); also elsewhere on the board
ROW3: U1.28 (PB4); also elsewhere on the board
ROW4: U1.27 (PD7); also elsewhere on the board
ROW5: U1.26 (PD6); also elsewhere on the board
ROW6: U1.25 (PD4); also elsewhere on the board
UART_RX: J2.2, U1.20 (PD2)
UART_TX: J2.3, U1.21 (PD3)

Notes on the sheet:
To SSD1306
Only in standalone Keyboard
To SYSCTL
note: FLIPPED PINOUT vs R-1!

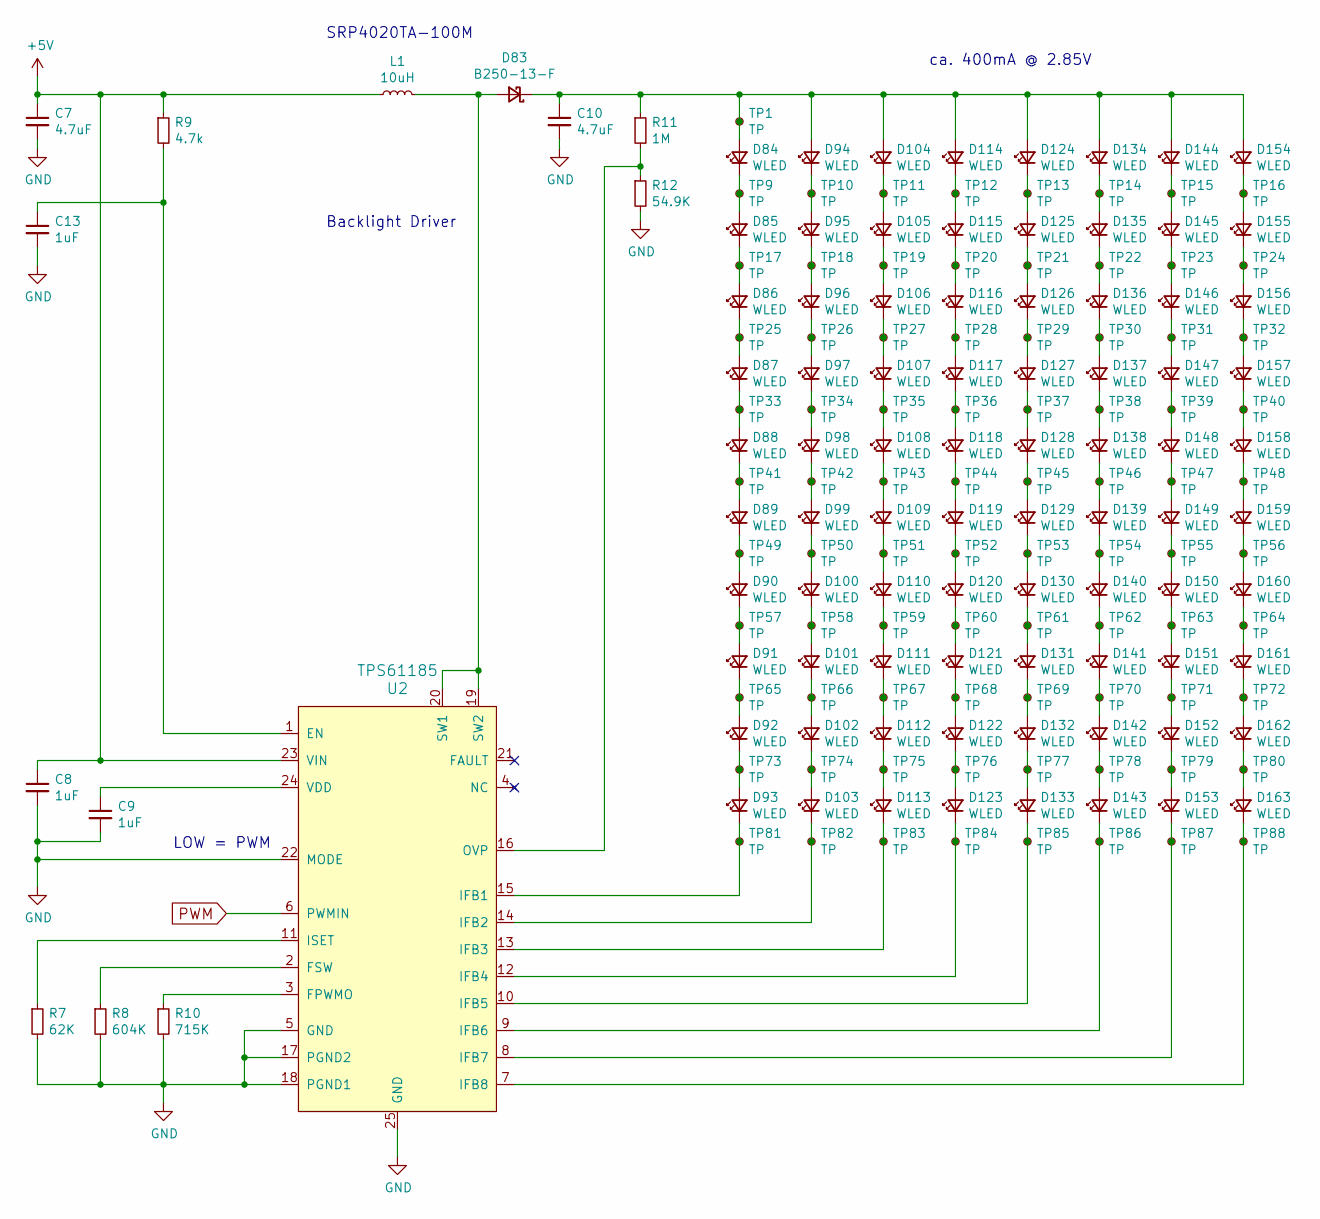
[picture p70: schematic reform2-keyboard-backlight.sch, MNT Reform 2 Keyboard]

Parts:
C7, C10: 4.7uF; C_0603_1608Metric; LCSC C90057
C8, C9, C13: 1uF; C_0603_1608Metric; LCSC C14664
D83: B250-13-F; D_SMB_Handsoldering; LCSC C719400
D84, D85, D86, D87, D88, D89, D90, D91, D92, D93, D94, D95, D96, D97, D98, D99, D100, D101, D102, D103, D104, D105, D106, D107, D108, D109, D110, D111, D112, D113, D114, D115, D116, D117, D118, D119, D120, D121, D122, D123, D124, D125, D126, D127, D128, D129, D130, D131, D132, D133, D134, D135, D136, D137, D138, D139, D140, D141, D142, D143, D144, D145, D146, D147, D148, D149, D150, D151, D152, D153, D154, D155, D156, D157, D158, D159, D160, D161, D162, D163: WLED; LED_0603_1608Metric; LCSC C389521
L1: 10uH; IND_SRP4020TA-150M; LCSC C98364
R7: 62K; R_0603_1608Metric; LCSC C137694
R8: 604K; R_0603_1608Metric; LCSC C245986
R9: 4.7k; R_0603_1608Metric; LCSC C105428
R10: 715K; R_0603_1608Metric; LCSC C137685
R11: 1M; R_0603_1608Metric; LCSC C107698
R12: 54.9K; R_0603_1608Metric; LCSC C227961
TP1, TP9, TP10, TP11, TP12, TP13, TP14, TP15, TP16, TP17, TP18, TP19, TP20, TP21, TP22, TP23, TP24, TP25, TP26, TP27, TP28, TP29, TP30, TP31, TP32, TP33, TP34, TP35, TP36, TP37, TP38, TP39, TP40, TP41, TP42, TP43, TP44, TP45, TP46, TP47, TP48, TP49, TP50, TP51, TP52, TP53, TP54, TP55, TP56, TP57, TP58, TP59, TP60, TP61, TP62, TP63, TP64, TP65, TP66, TP67, TP68, TP69, TP70, TP71, TP72, TP73, TP74, TP75, TP76, TP77, TP78, TP79, TP80, TP81, TP82, TP83, TP84, TP85, TP86, TP87, TP88: TP; TestPoint_Pad_1.0x1.0mm
U2: TPS61185; VQFN-24-1EP_4x4mm_P0.5mm_EP2.45x2.45mm; LCSC C2867853

Connections:
+5V: C7.1, C8.1, L1.1, R9.1, U2.23 (VIN); also elsewhere on the board
GND: C7.2, C8.2, C9.2, C10.2, C13.2, R7.2, R8.2, R10.2, R12.2, U2.5 (GND), U2.17 (PGND2), U2.18 (PGND1), U2.22 (MODE), U2.25 (GND); also elsewhere on the board
unnamed: C9.1, U2.24 (VDD)
unnamed: C10.1, D83.1 (K), D84.2 (A), D94.2 (A), D104.2 (A), D114.2 (A), D124.2 (A), D134.2 (A), D144.2 (A), D154.2 (A), R11.1, TP1.1
unnamed: C13.1, R9.2, U2.1 (EN)
unnamed: D83.2 (A), L1.2, U2.19 (SW2), U2.20 (SW1)
unnamed: D84.1 (K), D85.2 (A), TP9.1
unnamed: D85.1 (K), D86.2 (A), TP17.1
unnamed: D86.1 (K), D87.2 (A), TP25.1
unnamed: D87.1 (K), D88.2 (A), TP33.1
unnamed: D88.1 (K), D89.2 (A), TP41.1
unnamed: D89.1 (K), D90.2 (A), TP49.1
unnamed: D90.1 (K), D91.2 (A), TP57.1
unnamed: D91.1 (K), D92.2 (A), TP65.1
unnamed: D92.1 (K), D93.2 (A), TP73.1
unnamed: D93.1 (K), TP81.1, U2.15 (IFB1)
unnamed: D94.1 (K), D95.2 (A), TP10.1
unnamed: D95.1 (K), D96.2 (A), TP18.1
unnamed: D96.1 (K), D97.2 (A), TP26.1
unnamed: D97.1 (K), D98.2 (A), TP34.1
unnamed: D98.1 (K), D99.2 (A), TP42.1
unnamed: D100.1 (K), D101.2 (A), TP58.1
unnamed: D99.1 (K), D100.2 (A), TP50.1
unnamed: D101.1 (K), D102.2 (A), TP66.1
unnamed: D102.1 (K), D103.2 (A), TP74.1
unnamed: D103.1 (K), TP82.1, U2.14 (IFB2)
unnamed: D104.1 (K), D105.2 (A), TP11.1
unnamed: D105.1 (K), D106.2 (A), TP19.1
unnamed: D106.1 (K), D107.2 (A), TP27.1
unnamed: D107.1 (K), D108.2 (A), TP35.1
unnamed: D108.1 (K), D109.2 (A), TP43.1
unnamed: D109.1 (K), D110.2 (A), TP51.1
unnamed: D110.1 (K), D111.2 (A), TP59.1
unnamed: D111.1 (K), D112.2 (A), TP67.1
unnamed: D112.1 (K), D113.2 (A), TP75.1
unnamed: D113.1 (K), TP83.1, U2.13 (IFB3)
unnamed: D114.1 (K), D115.2 (A), TP12.1
unnamed: D115.1 (K), D116.2 (A), TP20.1
unnamed: D116.1 (K), D117.2 (A), TP28.1
unnamed: D117.1 (K), D118.2 (A), TP36.1
unnamed: D118.1 (K), D119.2 (A), TP44.1
unnamed: D119.1 (K), D120.2 (A), TP52.1
unnamed: D120.1 (K), D121.2 (A), TP60.1
unnamed: D121.1 (K), D122.2 (A), TP68.1
unnamed: D122.1 (K), D123.2 (A), TP76.1
unnamed: D123.1 (K), TP84.1, U2.12 (IFB4)
unnamed: D124.1 (K), D125.2 (A), TP13.1
unnamed: D125.1 (K), D126.2 (A), TP21.1
unnamed: D126.1 (K), D127.2 (A), TP29.1
unnamed: D127.1 (K), D128.2 (A), TP37.1
unnamed: D128.1 (K), D129.2 (A), TP45.1
unnamed: D129.1 (K), D130.2 (A), TP53.1
unnamed: D130.1 (K), D131.2 (A), TP61.1
unnamed: D131.1 (K), D132.2 (A), TP69.1
unnamed: D132.1 (K), D133.2 (A), TP77.1
unnamed: D133.1 (K), TP85.1, U2.10 (IFB5)
unnamed: D134.1 (K), D135.2 (A), TP14.1
unnamed: D135.1 (K), D136.2 (A), TP22.1
unnamed: D136.1 (K), D137.2 (A), TP30.1
unnamed: D137.1 (K), D138.2 (A), TP38.1
unnamed: D138.1 (K), D139.2 (A), TP46.1
unnamed: D139.1 (K), D140.2 (A), TP54.1
unnamed: D140.1 (K), D141.2 (A), TP62.1
unnamed: D141.1 (K), D142.2 (A), TP70.1
unnamed: D142.1 (K), D143.2 (A), TP78.1
unnamed: D143.1 (K), TP86.1, U2.9 (IFB6)
unnamed: D144.1 (K), D145.2 (A), TP15.1
unnamed: D145.1 (K), D146.2 (A), TP23.1
unnamed: D146.1 (K), D147.2 (A), TP31.1
unnamed: D147.1 (K), D148.2 (A), TP39.1
unnamed: D148.1 (K), D149.2 (A), TP47.1
unnamed: D149.1 (K), D150.2 (A), TP55.1
unnamed: D150.1 (K), D151.2 (A), TP63.1
unnamed: D151.1 (K), D152.2 (A), TP71.1
unnamed: D152.1 (K), D153.2 (A), TP79.1
unnamed: D153.1 (K), TP87.1, U2.8 (IFB7)
unnamed: D154.1 (K), D155.2 (A), TP16.1
unnamed: D155.1 (K), D156.2 (A), TP24.1
unnamed: D156.1 (K), D157.2 (A), TP32.1
unnamed: D157.1 (K), D158.2 (A), TP40.1
unnamed: D158.1 (K), D159.2 (A), TP48.1
unnamed: D159.1 (K), D160.2 (A), TP56.1
unnamed: D160.1 (K), D161.2 (A), TP64.1
unnamed: D161.1 (K), D162.2 (A), TP72.1
unnamed: D162.1 (K), D163.2 (A), TP80.1
unnamed: D163.1 (K), TP88.1, U2.7 (IFB8)
unnamed: R7.1, U2.11 (ISET)
unnamed: R8.1, U2.2 (FSW)
unnamed: R10.1, U2.3 (FPWMO)
unnamed: R11.2, R12.1, U2.16 (OVP)
PWM: U2.6 (PWMIN); also elsewhere on the board

Notes on the sheet:
LOW = PWM
SRP4020TA-100M
ca. 400mA @ 2.85V
Backlight Driver

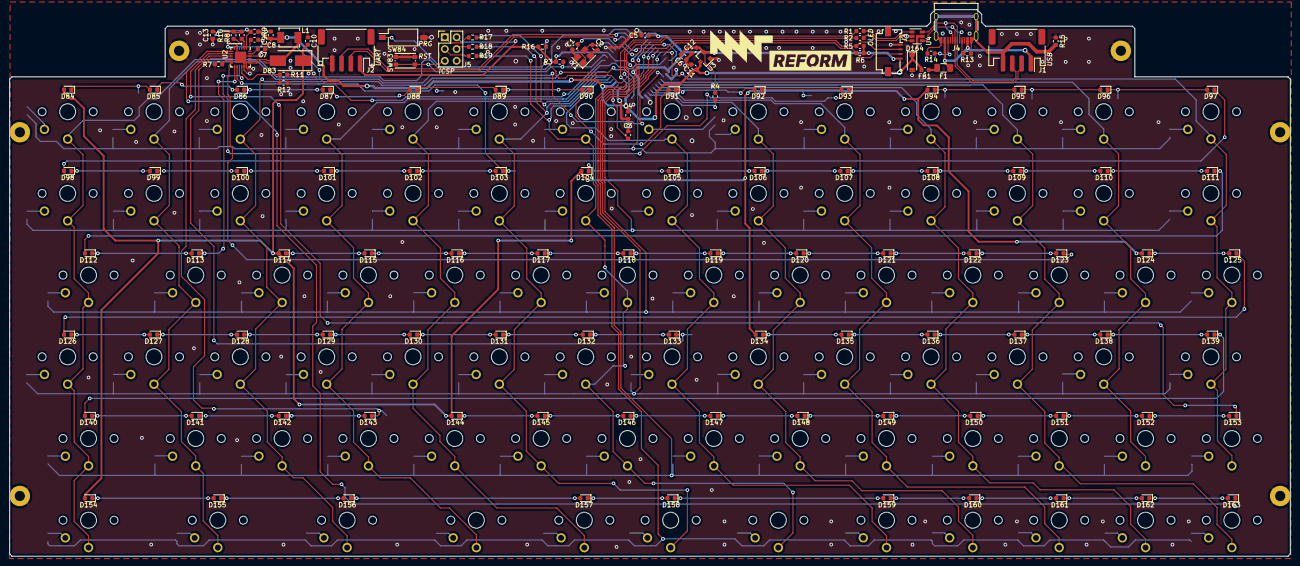
[picture p71: board reform2-keyboard.kicad_pcb from above]

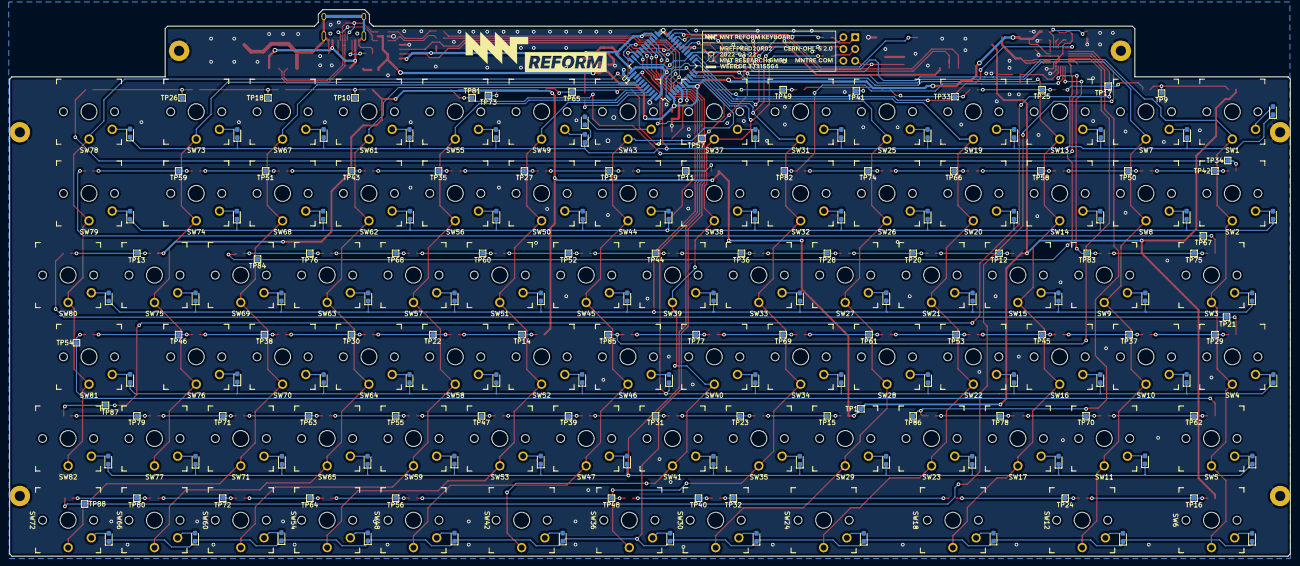
[picture p72: board reform2-keyboard.kicad_pcb from below]

Board: 2 copper layers, 275.9 x 117.8 mm, 383 parts (166 on the bottom side), 218 nets.
