jackhumbert/reform/reform2-protected-batterypack-pcb/reform2-protected-batterypack-pcb.kicad_pcb

## KiCad design reform2-protected-batterypack-pcb/reform2-protected-batterypack-pcb.kicad_pcb (2022-09-01)

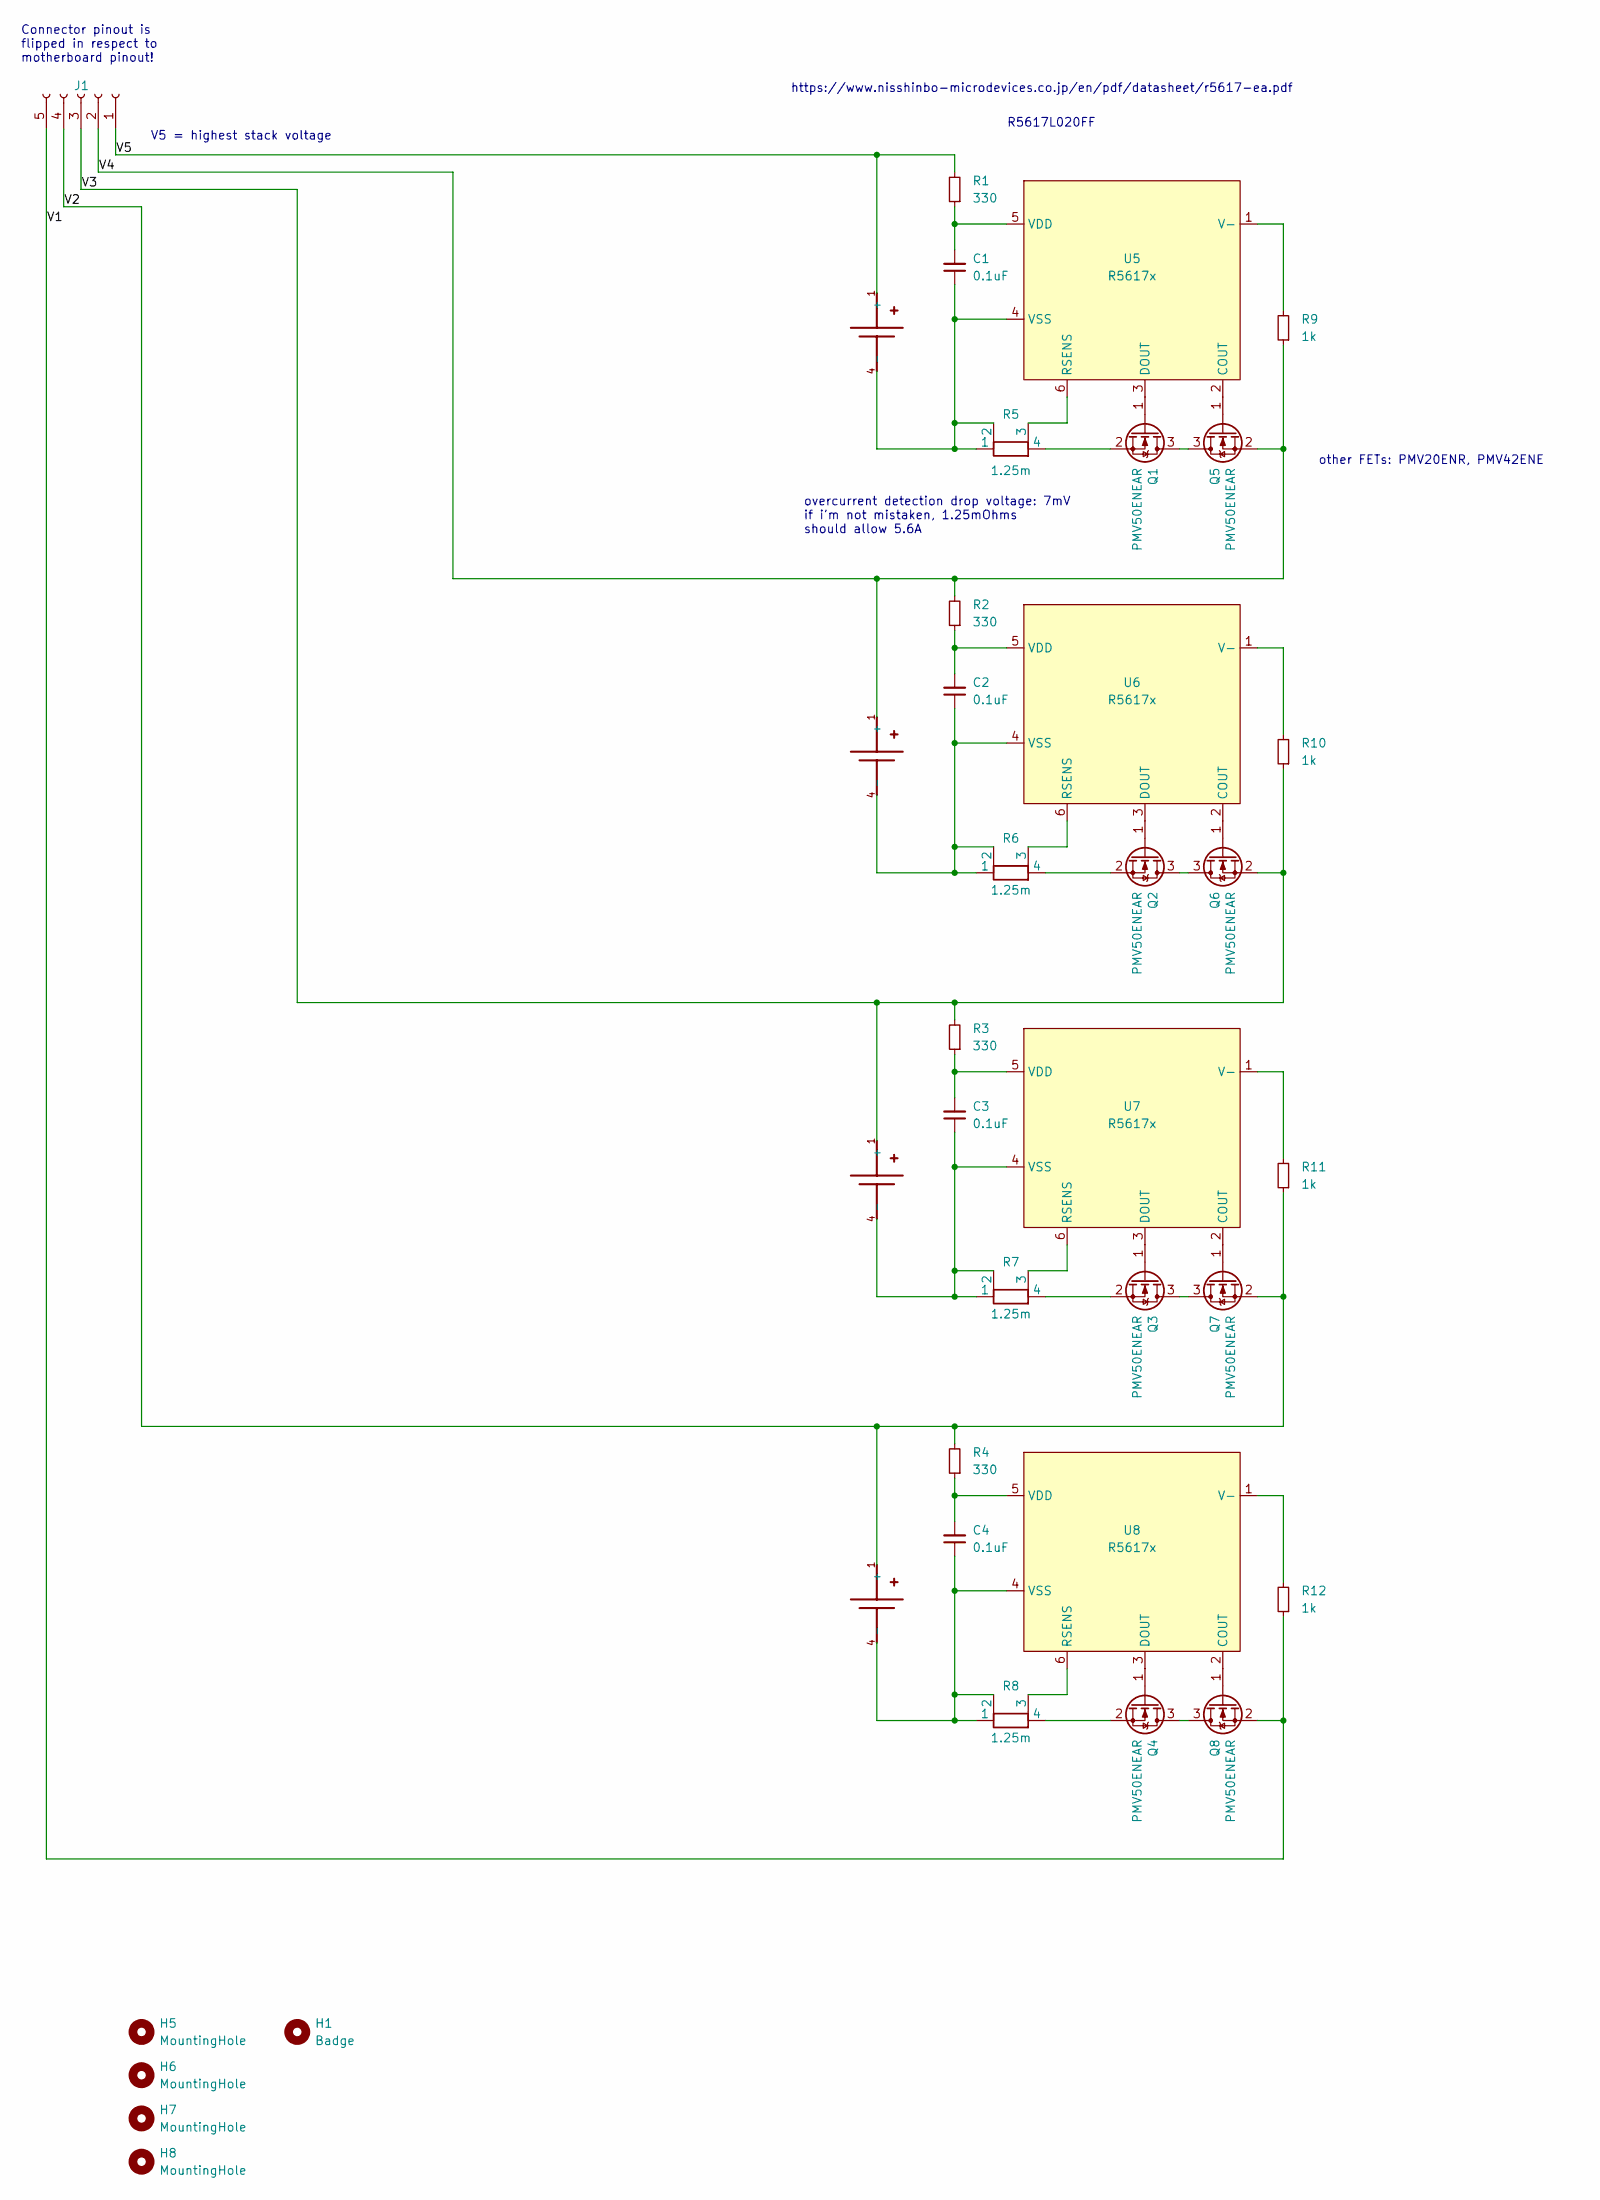
[picture p73: schematic reform2-protected-batterypack-pcb.kicad_sch, MNT Reform Protected Battery Pack]

Parts:
C1, C2, C3, C4: 0.1uF; C_0603_1608Metric
H1: Badge; mref-protected-batterypack-badge
H5, H6, H7, H8: MountingHole; MountingHole_2.2mm_M2
J1: Conn_01x05_Female; Molex_Pico-Lock_504050-0591_1x05-1MP_P1.50mm_Horizontal
Q1, Q2, Q3, Q4, Q5, Q6, Q7, Q8: PMV50ENEAR; SOT-23
R1, R2, R3, R4: 330; R_0603_1608Metric
R5, R6, R7, R8: 1.25m; R_1206_3216Metric_Kelvin
R9, R10, R11, R12: 1k; R_0603_1608Metric
U1, U2, U3, U4: KEYSTONE_54; Keystone54
U5, U6, U7, U8: R5617x; DFN-R5617_P0.5mm

Connections:
/V1: J1.5, Q8.2 (S), R12.1
/V2: J1.4, Q7.2 (S), R4.2, R11.1, U4.1 (+), U4.2 (+), U4.3 (+)
/V3: J1.3, Q6.2 (S), R3.2, R10.1, U3.1 (+), U3.2 (+), U3.3 (+)
/V4: J1.2, Q5.2 (S), R2.2, R9.1, U2.1 (+), U2.2 (+), U2.3 (+)
/V5: J1.1, R1.2, U1.1 (+), U1.2 (+), U1.3 (+)
unnamed: C1.1, R5.1, R5.2, U1.4 (-), U1.5 (-), U1.6 (-), U5.4 (VSS)
unnamed: C1.2, R1.1, U5.5 (VDD)
unnamed: C2.1, R6.1, R6.2, U2.4 (-), U2.5 (-), U2.6 (-), U6.4 (VSS)
unnamed: C2.2, R2.1, U6.5 (VDD)
unnamed: C3.1, R7.1, R7.2, U3.4 (-), U3.5 (-), U3.6 (-), U7.4 (VSS)
unnamed: C3.2, R3.1, U7.5 (VDD)
unnamed: C4.1, R8.1, R8.2, U4.4 (-), U4.5 (-), U4.6 (-), U8.4 (VSS)
unnamed: C4.2, R4.1, U8.5 (VDD)
unnamed: Q1.1 (G), U5.3 (DOUT)
unnamed: Q1.2 (S), R5.4
unnamed: Q1.3 (D), Q5.3 (D)
unnamed: Q2.1 (G), U6.3 (DOUT)
unnamed: Q2.2 (S), R6.4
unnamed: Q2.3 (D), Q6.3 (D)
unnamed: Q3.1 (G), U7.3 (DOUT)
unnamed: Q3.2 (S), R7.4
unnamed: Q3.3 (D), Q7.3 (D)
unnamed: Q4.1 (G), U8.3 (DOUT)
unnamed: Q4.2 (S), R8.4
unnamed: Q4.3 (D), Q8.3 (D)
unnamed: Q5.1 (G), U5.2 (COUT)
unnamed: Q6.1 (G), U6.2 (COUT)
unnamed: Q7.1 (G), U7.2 (COUT)
unnamed: Q8.1 (G), U8.2 (COUT)
unnamed: R6.3, U6.6 (RSENS)
unnamed: R7.3, U7.6 (RSENS)
unnamed: R8.3, U8.6 (RSENS)
unnamed: R9.2, U5.1 (V-)
unnamed: R10.2, U6.1 (V-)
unnamed: R11.2, U7.1 (V-)
unnamed: R12.2, U8.1 (V-)
unnamed: R5.3, U5.6 (RSENS)

Notes on the sheet:
other FETs: PMV20ENR, PMV42ENE
overcurrent detection drop voltage: 7mV if i'm not mistaken, 1.25mOhms should allow 5.6A
R5617L020FF
https://www.nisshinbo-microdevices.co.jp/en/pdf/datasheet/r5617-ea.pdf
V5 = highest stack voltage
Connector pinout is flipped in respect to motherboard pinout!

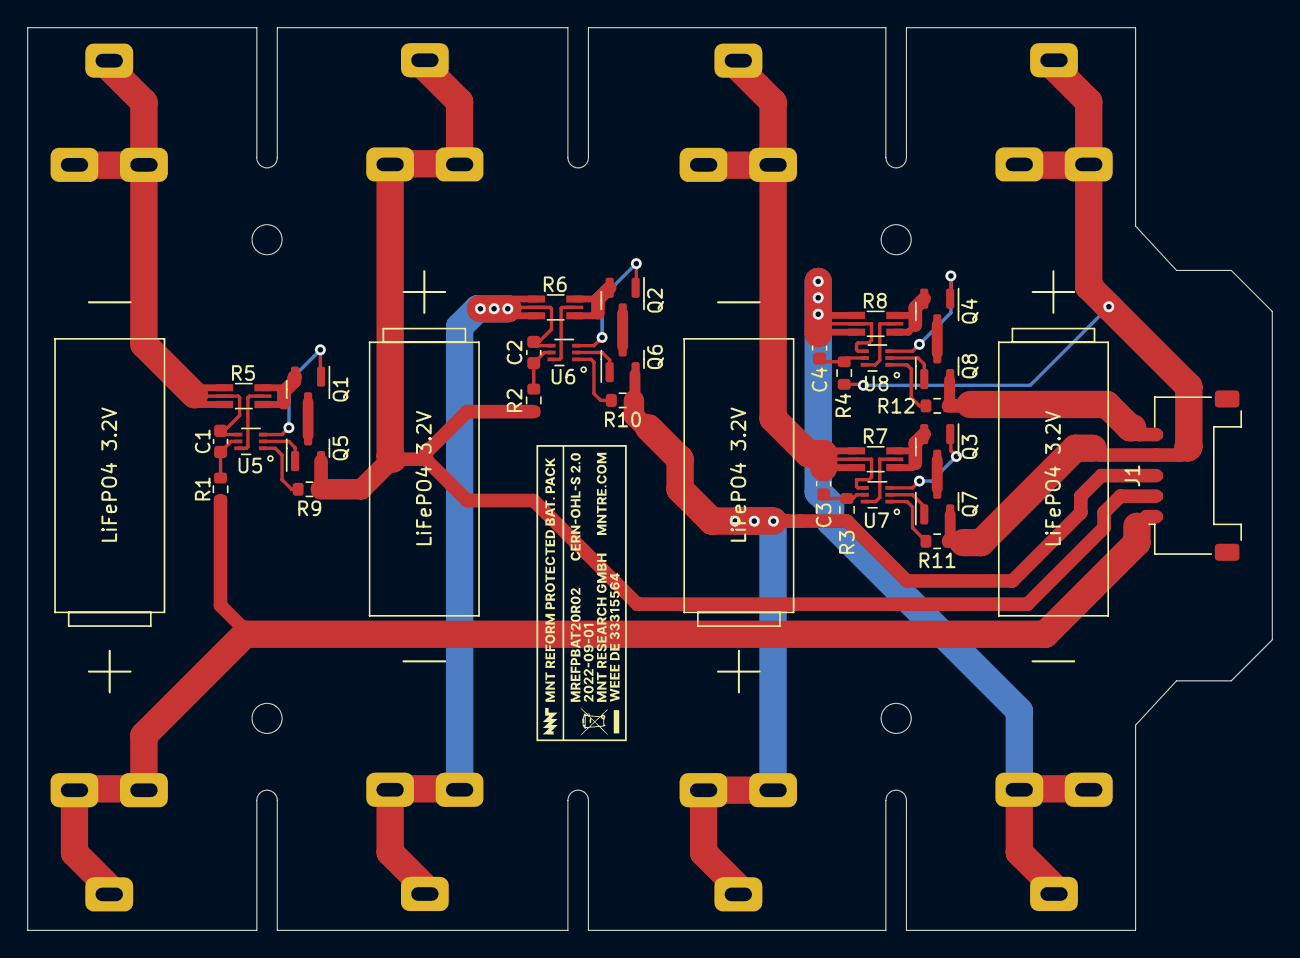
[picture p74: board reform2-protected-batterypack-pcb.kicad_pcb from above]

Board: 2 copper layers, 91.0 x 66.0 mm, 38 parts (0 on the bottom side), 37 nets.
