jackhumbert/reform/reform2-batterypack-pcb/reform2-batterypack.kicad_pcb

## KiCad design reform2-batterypack-pcb/reform2-batterypack.kicad_pcb (2021-07-25)

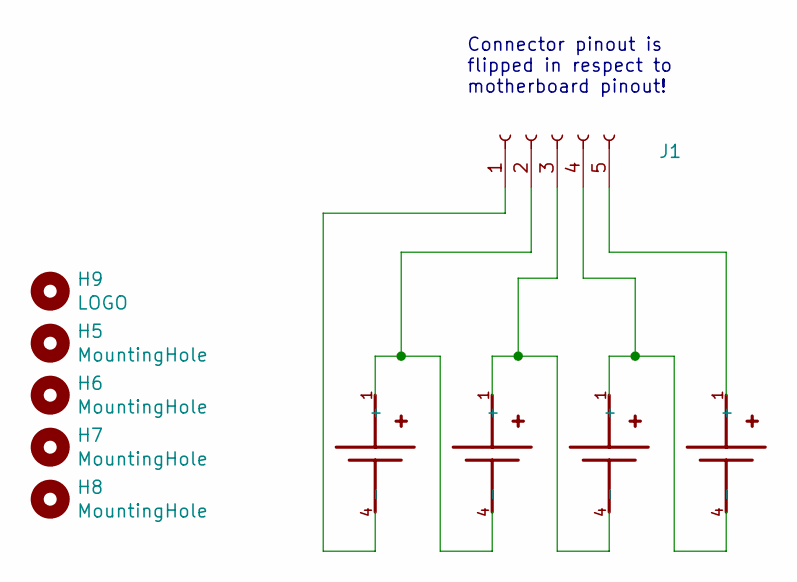
[picture p75: schematic reform2-batterypack.sch, MNT Reform 2 Battery Pack]

Parts:
H5, H6, H7, H8: MountingHole; MountingHole_2.2mm_M2
H9: LOGO; mnt-minilogo
J1: Conn_01x05_Female; Molex_Pico-Lock_504050-0591_1x05-1MP_P1.50mm_Horizontal
U1, U2, U3, U4: KEYSTONE_54; Keystone54

Connections:
unnamed: J1.1, U1.4 (-), U1.5 (-), U1.6 (-)
unnamed: J1.2, U1.1 (+), U1.2 (+), U1.3 (+), U2.4 (-), U2.5 (-), U2.6 (-)
unnamed: J1.3, U2.1 (+), U2.2 (+), U2.3 (+), U3.4 (-), U3.5 (-), U3.6 (-)
unnamed: J1.4, U3.1 (+), U3.2 (+), U3.3 (+), U4.4 (-), U4.5 (-), U4.6 (-)
unnamed: J1.5, U4.1 (+), U4.2 (+), U4.3 (+)

Notes on the sheet:
Connector pinout is flipped in respect to motherboard pinout!

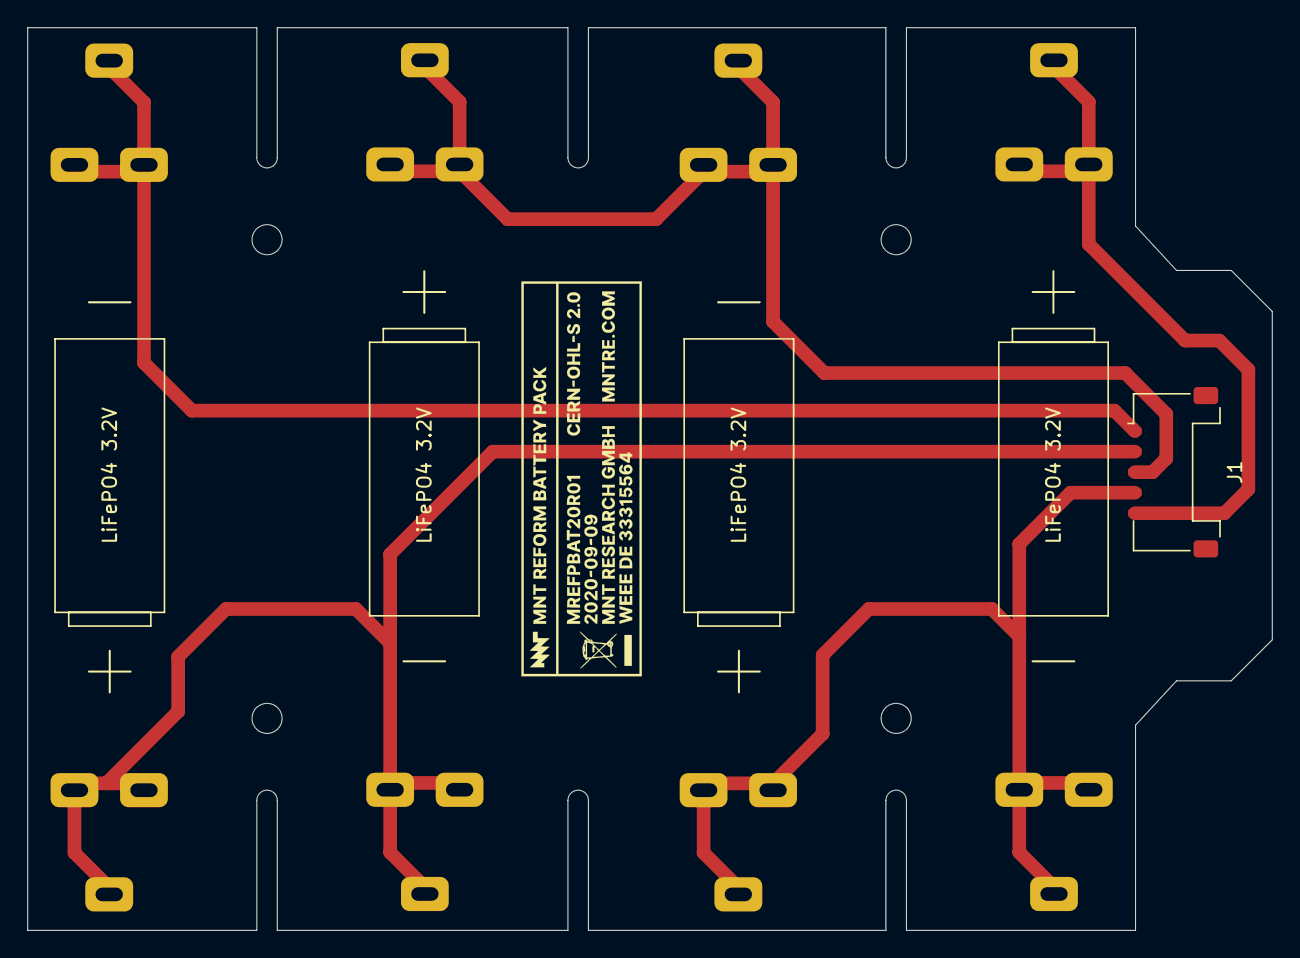
[picture p76: board reform2-batterypack.kicad_pcb from above]

Board: 2 copper layers, 91.0 x 66.0 mm, 9 parts (0 on the bottom side), 5 nets.
