jackhumbert/reform/reform2-trackball-pcb/reform2-trackball.kicad_pcb

## KiCad design reform2-trackball-pcb/reform2-trackball.kicad_pcb (2021-07-25)

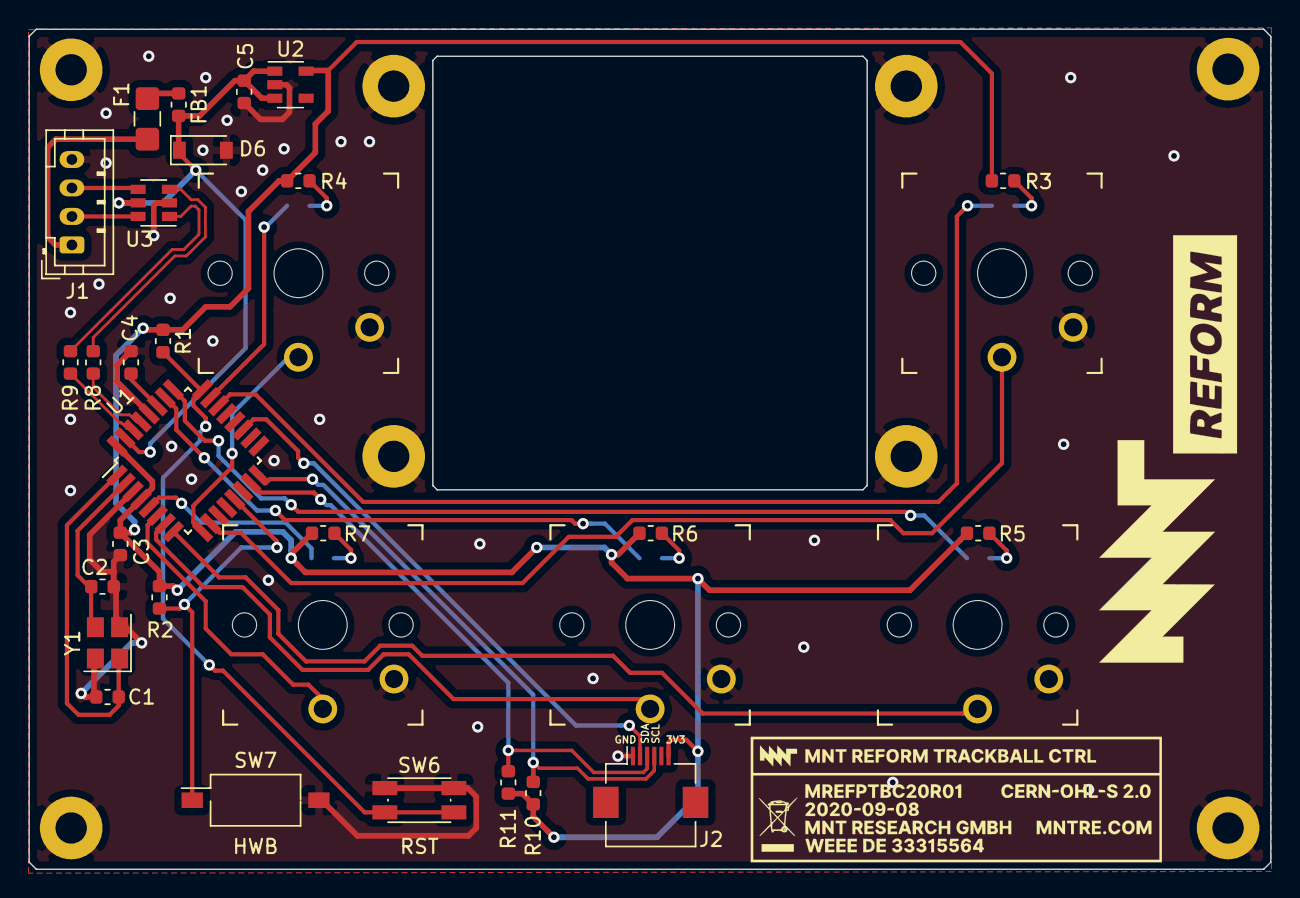
[picture p77: board reform2-trackball.kicad_pcb from above]

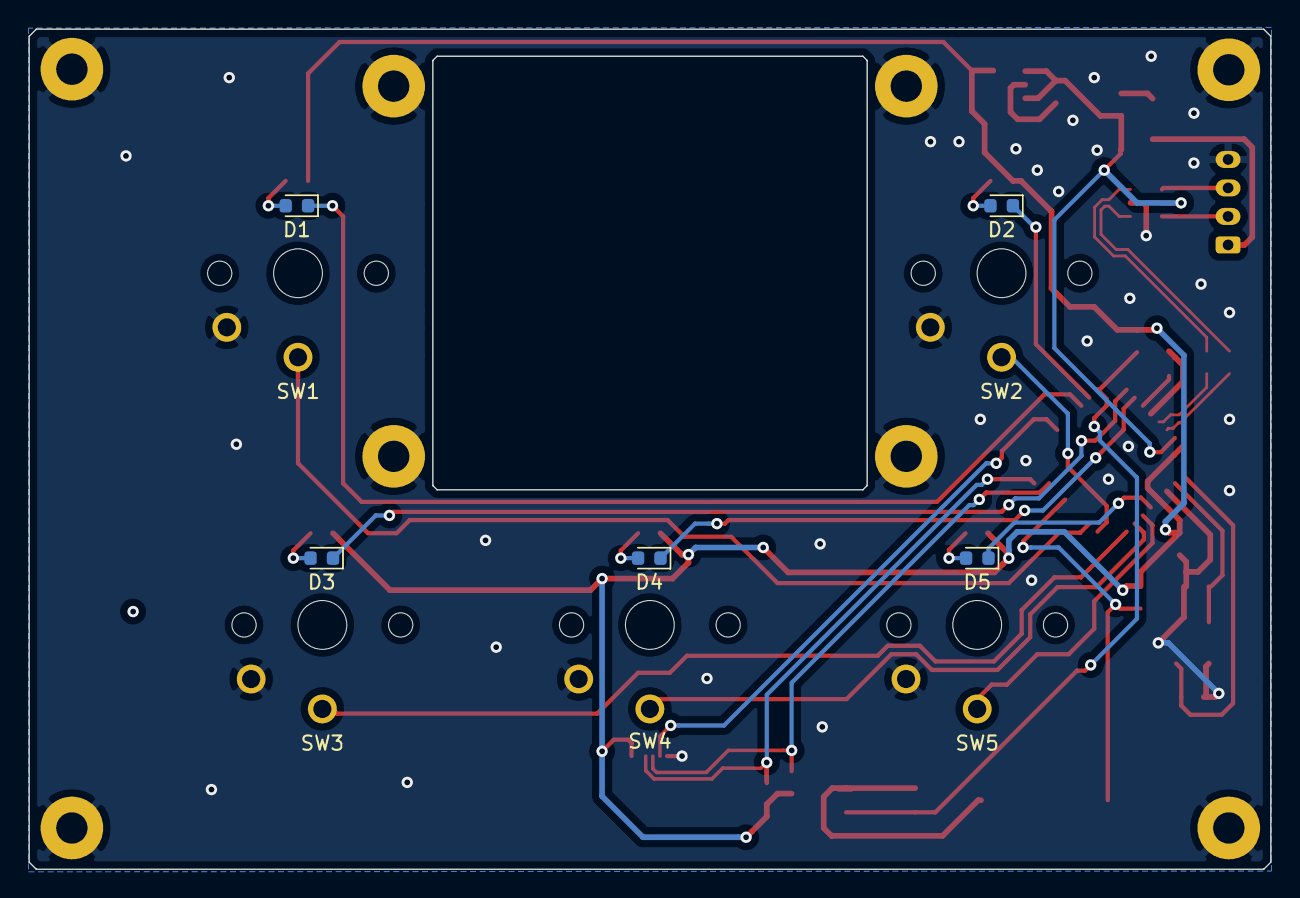
[picture p78: board reform2-trackball.kicad_pcb from below]

Board: 2 copper layers, 87.2 x 59.0 mm, 47 parts (10 on the bottom side), 34 nets.

Parts:
C1, C2: 18pF; C_0603_1608Metric
C3, C5: 0.1uF; C_0603_1608Metric
C4: 1uF; C_0603_1608Metric
D1, D2, D3, D4, D5: LED_Small; LED_0603_1608Metric
D6: BZT52-B5V6J; D_SOD-123
F1: 0ZCJ0075AF2E; Fuse_1206_3216Metric_Castellated
FB1: BLM18PG221SH1D; L_0603_1608Metric
J1: Conn_USB; JST_PH_B4B-PH-K_1x04_P2.00mm_Vertical
J2: Conn_01x06_Female; Hirose_FH12-6S-0.5SH_1x06-1MP_P0.50mm_Horizontal
MK1: BADGE; mntreform-trackball-badge
MK5, MK6, MK7, MK8, MK9, MK10, MK11, MK12: Mounting_Hole; MountingHole_2.2mm_M2_Pad
MK13: LOGO; mntreform
R1, R2: 10k; R_0603_1608Metric
R3, R4, R5, R6, R7: 475; R_0603_1608Metric
R8, R9: 22; R_0603_1608Metric
R10, R11: 4.7k; R_0603_1608Metric
SW1, SW2, SW3, SW4, SW5: Choc; PG1350
SW6: SW_RST; Diptronics-PTLP2
SW7: SW_HWB; SW_DIP_SPSTx01_Slide_Omron_A6S-110x_W8.9mm_P2.54mm
U1: ATmega32U2-AU; TQFP-32_7x7mm_Pitch0.8mm
U2: TLV75533PDBV; SOT-23-5
U3: USBLC6-2SC6; SOT-23-6
Y1: Crystal_GND24; Crystal_SMD_3225-4Pin_3.2x2.5mm

Connections:
+3V3: C3.1, J2.6, R1.1, R2.2, R3.2, R4.2, R5.2, R6.2, R7.2, R10.2, R11.2, U1.4, U1.32, U2.5
+5V: C5.1, D6.1, FB1.2, U1.31, U2.1, U2.3, U3.5
/5V_IN: F1.2, J1.1
/D+: R8.2, U1.29
/D-: R9.1, U1.30
/PD+: J1.3, U3.4
/PD-: J1.2, U3.6
/UD+: R8.1, U3.3
/UD-: R9.2, U3.1
GND: C1.2, C2.1, C3.2, C4.2, C5.2, D6.2, J1.4, J2.1, MK5.1, MK6.1, MK7.1, MK8.1, MK9.1, MK10.1, MK11.1, MK12.1, SW1.2, SW2.2, SW3.2, SW4.2, SW5.2, SW6.1, SW7.2, U1.3, U1.28, U2.2, U3.2, Y1.2, Y1.4
MT: J2.2, U1.19
unnamed: C1.1, U1.1, Y1.1
unnamed: C2.2, U1.2, Y1.3
unnamed: C4.1, U1.27
unnamed: D1.1, U1.22
unnamed: D1.2, R3.1
unnamed: D2.1, U1.23
unnamed: D2.2, R4.1
unnamed: D3.1, U1.25
unnamed: D3.2, R5.1
unnamed: D4.1, U1.26
unnamed: D4.2, R6.1
unnamed: D5.1, U1.5
unnamed: D5.2, R7.1
unnamed: F1.1, FB1.1
unnamed: R1.2, SW6.2, U1.24
unnamed: R2.1, SW7.1, U1.13
unnamed: SW1.1, U1.10
unnamed: SW2.1, U1.9
unnamed: SW3.1, U1.8
unnamed: SW4.1, U1.7
unnamed: SW5.1, U1.6
SCL: J2.4, R10.1, U1.16
SDA: J2.3, R11.1, U1.15
