jackhumbert/reform/reform2-trackball-sensor-pcb/reform2-trackball-sensor.kicad_pcb

## KiCad design reform2-trackball-sensor-pcb/reform2-trackball-sensor.kicad_pcb (2021-07-25)

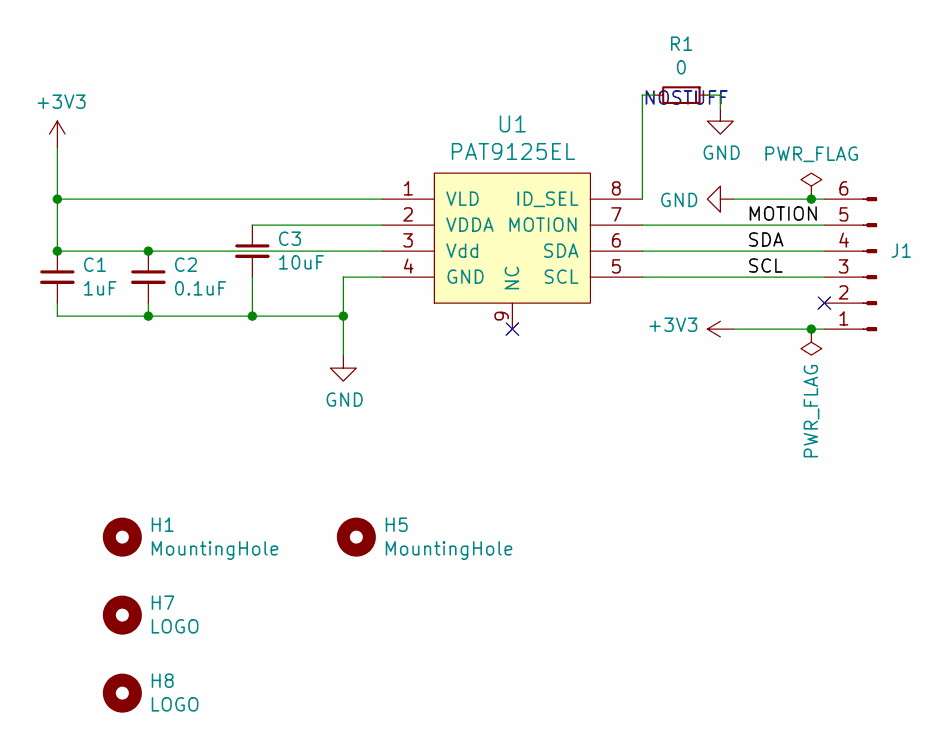
[picture p79: schematic reform2-trackball-sensor.sch, MNT Reform Trackball Sensor]

Parts:
C1: 1uF; C_0603_1608Metric
C2: 0.1uF; C_0603_1608Metric
C3: 10uF; C_0603_1608Metric
H1, H5: MountingHole; MountingHole_2.2mm_M2
H7: LOGO; mnt-minilogo
H8: LOGO; reform2-trackball-sensor-badge
J1: Conn_01x06_Male; Hirose_FH12-6S-0.5SH_1x06-1MP_P0.50mm_Horizontal
R1: 0; R_0603_1608Metric
U1: PAT9125EL

Connections:
+3V3: C1.1, C2.1, J1.1, U1.1 (VLD), U1.3 (Vdd)
/MOTION: J1.5, U1.7 (MOTION)
/SCL: J1.3, U1.5 (SCL)
/SDA: J1.4, U1.6 (SDA)
GND: C1.2, C2.2, C3.2, J1.6, R1.1, U1.4 (GND)
unnamed: C3.1, U1.2 (VDDA)
unnamed: R1.2, U1.8 (ID_SEL)

Notes on the sheet:
NOSTUFF

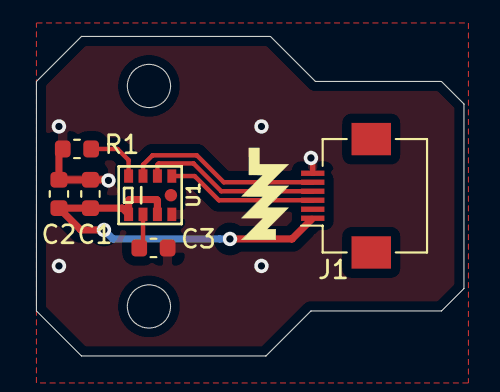
[picture p80: board reform2-trackball-sensor.kicad_pcb from above]

Board: 2 copper layers, 23.8 x 17.8 mm, 10 parts (1 on the bottom side), 7 nets.

Other parts of the board:
H2: MountingHole; MountingHole_2.2mm_M2
