jackhumbert/reform/reform2-oled-pcb/reform2-oled.kicad_pcb

## KiCad design reform2-oled-pcb/reform2-oled.kicad_pcb (2021-07-25)

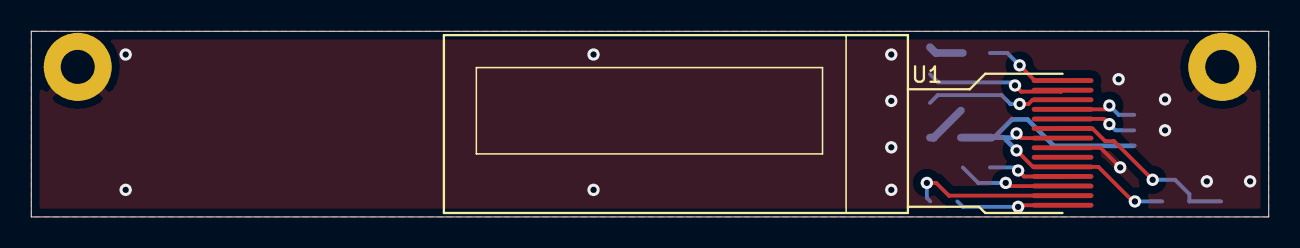
[picture p81: board reform2-oled.kicad_pcb from above]

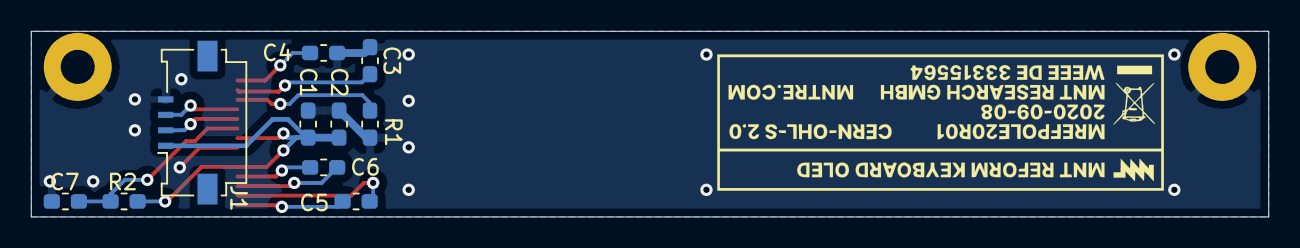
[picture p82: board reform2-oled.kicad_pcb from below]

Board: 2 copper layers, 80.0 x 12.0 mm, 14 parts (11 on the bottom side), 12 nets.

Parts:
C1, C2, C5, C6, C7: 1uF; C_0603_1608Metric_Pad1.05x0.95mm_HandSolder
C3, C4: 10uF; C_0603_1608Metric_Pad1.05x0.95mm_HandSolder
GFX2: BADGE; reform2-oled-badge
H1: MH1; MountingHole_2.2mm_M2_Pad
H2: MH2; MountingHole_2.2mm_M2_Pad
J1: AUX; Molex_200528-0040_1x04-1MP_P1.00mm_Horizontal
R1: 330k; R_0603_1608Metric_Pad1.05x0.95mm_HandSolder
R2: 4.7k; R_0603_1608Metric_Pad1.05x0.95mm_HandSolder
U1: SSD1306; SSD1306_OLED-0.91-128x32

Connections:
+3V3: C1.1, C2.1, J1.1, R2.2, U1.5, U1.8
DISP_SCL: J1.2, U1.10
DISP_SDA: J1.3, U1.11
GND: C1.2, C2.2, C3.2, C4.2, C7.2, H1.1, H2.1, J1.4, R1.2, U1.7
unnamed: C3.1, U1.13
unnamed: C4.1, U1.14
unnamed: C5.1, U1.1
unnamed: C5.2, U1.2
unnamed: C6.1, U1.3
unnamed: C6.2, U1.4
unnamed: C7.1, R2.1, U1.9
unnamed: R1.1, U1.12
