jackhumbert/reform/reform2-keyboard-fw/matrix.h

/*
  MNT Reform 2.0 Keyboard Firmware
  See keyboard.c for Copyright
  SPDX-License-Identifier: MIT
*/

#include "keyboard.h"

// Every line of `matrix` is a row of the keyboard, starting from the top.
// Check keyboard.h for the definitions of the default rows.
uint8_t matrix[KBD_MATRIX_SZ] = {
  MATRIX_DEFAULT_ROW_1,
  MATRIX_DEFAULT_ROW_2,
  MATRIX_DEFAULT_ROW_3,
  MATRIX_DEFAULT_ROW_4,
  MATRIX_DEFAULT_ROW_5,
  MATRIX_DEFAULT_ROW_6,

  // Marker for layout editor (FIXME)
  KBD_EDITOR_MARKER
};

// When holding down HYPER
uint8_t matrix_fn[KBD_MATRIX_SZ] = {
  // Media keys on Hyper + F7-F12
  KEY_ESCAPE,
  HID_KEYBOARD_SC_MEDIA_BRIGHTNESS_DOWN,
  HID_KEYBOARD_SC_MEDIA_BRIGHTNESS_UP,
  KEY_F3,
  KEY_F4,
  KEY_F5,
  KEY_F6,
  HID_KEYBOARD_SC_MEDIA_PREVIOUS_TRACK,
  HID_KEYBOARD_SC_MEDIA_PLAY,
  HID_KEYBOARD_SC_MEDIA_NEXT_TRACK,
  HID_KEYBOARD_SC_MEDIA_MUTE,
  HID_KEYBOARD_SC_MEDIA_VOLUME_DOWN,
  HID_KEYBOARD_SC_MEDIA_VOLUME_UP,
  KEY_CIRCLE,

  MATRIX_DEFAULT_ROW_2,
  MATRIX_DEFAULT_ROW_3,
  MATRIX_DEFAULT_ROW_4,
  MATRIX_DEFAULT_ROW_5,
  MATRIX_DEFAULT_ROW_6
};

// Second layer (toggled by HYPER+CIRCLE)
uint8_t matrix_fn_toggled[KBD_MATRIX_SZ] = {
  // Custom top row
  KEY_ESCAPE,
  HID_KEYBOARD_SC_MEDIA_BRIGHTNESS_DOWN,
  HID_KEYBOARD_SC_MEDIA_BRIGHTNESS_UP,
  KEY_F3,
  KEY_F4,
  KEY_F5,
  KEY_F6,
  HID_KEYBOARD_SC_MEDIA_PREVIOUS_TRACK,
  HID_KEYBOARD_SC_MEDIA_PLAY,
  HID_KEYBOARD_SC_MEDIA_NEXT_TRACK,
  HID_KEYBOARD_SC_MEDIA_MUTE,
  HID_KEYBOARD_SC_MEDIA_VOLUME_DOWN,
  HID_KEYBOARD_SC_MEDIA_VOLUME_UP,
  KEY_CIRCLE,

  MATRIX_DEFAULT_ROW_2,
  MATRIX_DEFAULT_ROW_3,
  MATRIX_DEFAULT_ROW_4,
  MATRIX_DEFAULT_ROW_5,
  MATRIX_DEFAULT_ROW_6
};
