jackhumbert/reform/reform2-keyboard-fw/menu.h

/*
  MNT Reform 2.0 Keyboard Firmware
  See keyboard.c for Copyright
  SPDX-License-Identifier: MIT
*/

#ifndef _MENU_H_
#define _MENU_H_

typedef struct MenuItem {
  char* title;
  int keycode;
} MenuItem;

#define MENU_PAGE_NONE 0
#define MENU_PAGE_OTHER 1
#define MENU_PAGE_BATTERY_STATUS 2

void reset_and_render_menu(void);
void reset_menu(void);
void render_menu(int y);
void refresh_menu_page(void);
int execute_menu_function(int y);
int execute_meta_function(int keycode);
void anim_hello(void);
void anim_goodbye(void);

#endif
