jackhumbert/reform/(commit log)

2020-12-27 try to determine charge state based on current, not only voltage
2021-01-20 lpc-fw: remove unhelpful powerdown
2021-02-18 lpc-fw: commands for uart imx report toggle and wake; include FW rev date in status
2021-02-18 trackball-fw: don't light up on wheel mode; make LEDs addressable via HID
2021-03-02 keyboard: prototype low batt polling and alert
2021-03-05 fix status labels, bump release
    [board_reform2.c]
2021-03-09 kbd/lpc: fix alignment of amps/battery gauge
    [board_reform2.c]
2021-03-09 lpc: fix mA sign type
    [board_reform2.c]
2021-03-15 add keyboard lettering v5: qwerty-us and qwertz-de
2021-04-13 motherboard: add the split-up and cleaned up schematics that were made for the book
    [reform2-audio.sch, reform2-display.sch, reform2-eth.sch, reform2-hdmi.sch, reform2-lpc.sch, reform2-motherboard.sch, reform2-pcie.sch, reform2-power.sch]
2021-04-19 reform2-lpc: fix battery percentage; fix overvoltage for fixed R2 board; more status info
    [board_reform2.c]
2021-04-19 reform2-keyboard-fw: fix battery gauge offset
2021-04-19 reform2-lpc-fw: different end-of-charge recognition currents for r2/r3
2021-06-10 add reform2 case sources in fusion format
2021-06-10 reform2: update PCBs incl. badges to production revs, add keyboard lettering, misc docs
    [527450697.stp, 687106183722_Download_STP_687106183722_rev1.stp, FH12-6S-0.5SH.stp, FH12-6S-0.stl, KMR221GLFS.step, SMD_Polyfuse_1206.stp, assembly-components.csv, c-1734839-6-c-3d.stp]
2021-07-14 trackball: don't send left click on left wheel button
2021-07-25 add horizontal wheel (pan) and hi res scrolling
2021-07-25 trackball: tweak wheel sensitivity
2021-07-30 trackpad: add glass/glue/gasket assembly STEP
    [trackpad-glass-glue-gasket-20200807.step]
2021-07-30 add speakers and serial cables spec
2021-07-30 add full assembly instructions
2021-07-30 assembly: add motherboard, battery pack pcba references
2021-07-30 assembly: reduce image size
2021-07-30 add csv BOMs
    [reform2-batterypack.csv, reform2-keyboard.csv, reform2-motherboard.csv, reform2-oled.csv, reform2-other-parts.csv, reform2-trackball-sensor.csv, reform2-trackball.csv, reform2-trackpad.csv]
2021-07-30 assembly: add CNC parts sources and fix some references
2021-08-16 Initial Watchdog Based Power-off test
2021-08-16 Working power-down test, with screen off
2021-08-16 Power down ADC to save even more power.
2021-08-16 Renamed power-down menu item
2021-08-16 Enabled keyboard power-off when system turned off
2021-09-06 LPC: when not charging, regularly go to deep sleep for 1 second
2021-09-24 kbd: LPC wakeup routine and wrapper for commands with retry; power off kbd on shutdown via main CPU
2021-09-24 lpc: sleep in 3 states; next_state; missing cells only between 1 to 7 cells; force sleep mode for testing
    [board_reform2.c]
2021-09-24 lpc: don't sleep if som is powered
2021-09-24 kbd: increase battery alert check interval
2021-09-25 lpc: report som power state; 15 mins powersave holdoff time
2021-09-27 kbd: parse and react to remote system power state in poll; poll less often
2021-09-27 kbd: hide kbd power-off menu item
2021-09-29 lpc: don't sleep in cell missing state
    [board_reform2.c]
2021-10-01 lpc: add cooldown state, try not to overheat discharge resistors when balancing
    [board_reform2.c]
2021-12-13 kbd: implement media controller device; move matrix to .h files to make make happy
2022-01-09 kbd: matrix.h: remove FIXME
    [matrix.h]
2022-02-27 case ports: add fc and step files for metal version
    [ports-r1-v2-a-extrude.FCStd, ports-r1-v2-a.step, ports-r1-v2-b-extrude.FCStd, ports-r1-v2-b.step]
2022-02-27 batterypack: add upstream pack sources
    [5040500591.stp, PowerPAK SO-8.stp, reform2-batterypack-upstream.kicad_pcb, reform2-batterypack-upstream.sch]
2022-03-18 keyboard: add pcb version that has almost all components on the front side, with parts from lcsc
    [TYPE-C-31-M-12--3DModel-STEP-56544.STEP, reform-kbd-mcu.sch, reform2-keyboard-backlight.sch, reform2-keyboard.csv, reform2-keyboard.kicad_pcb, reform2-keyboard.sch, reform2-keyboard_bom_top.csv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]
2022-05-17 keyboard-fw: don't disable WDT during its interrupt handler
2022-05-17 keyboard-fw: interrupts must be disabled while WDT parameters are set
2022-05-17 keyboard-fw: use interrupt-only WDT mode, not interrupt-and-reset
    [powersave.c]
2022-06-12 lpc+kbd: Disable circle+1 power on cmd when SoM is already on
    I encountered this a few too many times when messing around with the
    menu. Previously, this would power-cycle the machine, which seems like
    an undesirable behaviour.
2022-06-20 add spi handler to firmware
2022-06-20 minimal driver code
2022-06-21 fix encoding errors for lpc commands
    [board_reform2.c]
2022-06-21 fix driver names, add support for power supply class
    [reform2-lpc.c]
2022-06-21 give it a bettery battery name
2022-06-23 remove constant logging for perf and uart congestion reasons, switch to O2
2022-06-24 replace delay with sleep per kernel doc recomendations
    [reform2-lpc.c]
2022-07-21 keyboard: add WIP R-2D version, atmega RC notes
    [reform2-keyboard-backlight.sch, reform2-keyboard.csv, reform2-keyboard.kicad_pcb]
2022-08-22 trackball pcb: add v2 with rp2040 mcu
    [reform2-trackball2.kicad_pcb, reform2-trackball2.kicad_sch]
2022-08-30 bb2.1 snapshot
    [1053091105.stp, 5040500591.stp, 5040500891.stp, Bateria 18650 3.7 V 1300 mAh d.18 mm.STEP, KEYSTONE 54 18650.step, KEYSTONE 54 A.step, POWERPAK 1212-8.STEP, PowerPAK 1212-8 Single Pad.step]
2022-09-01 protected battery pack: add release candidate
    [reform2-protected-batterypack-pcb.kicad_pcb, reform2-protected-batterypack-pcb.kicad_sch]
2022-09-01 keyboard-fw: fix 'display' definition
    [oled.c]
2022-09-01 keyboard-fw: mechanism for menu page auto-refresh; auto-refresh battery status every 2 seconds
2022-09-06 imx8mplus adapter initial checkin
    [FH12-22S-0.5SH.stp, FH12-33S-0.5SH.stp, reform2-imx8mplus.kicad_pcb, reform2-imx8mplus.kicad_sch]
2022-10-05 keyboard-fw: fix wrong command for OLED clearing
    [hid_report.c]
2022-10-05 trackball: dont force send report
    The HID library takes care of comparing with the
    previous report sent, avoiding lots of redundant
    report processing on the host.
    [Mouse.c]
2022-10-05 keyboard-fw: fix non-functional Delete key on QWERTY US variant if Hyper is pressed or mode enabled
    [keyboard.c]
2022-10-06 keyboard-fw: use the right scancodes for prev/next track to avoid possible confusion
    [keyboard.c, matrix.h, matrix_v.h]
2022-10-06 keyboard-fw: fix the ordering of media keys
    [descriptors.c, keyboard.h]
2022-10-06 imx8mplus: first rev routed
    [reform2-imx8mplus.kicad_pcb, reform2-imx8mplus.kicad_sch]
2022-10-07 imx8mplus: moved some things around; final tweaks and export for first test order
    [reform2-imx8mplus.kicad_pcb, reform2-imx8mplus.kicad_sch]
2022-10-07 imx8mplus: last minute diff pair length tuning
    [reform2-imx8mplus.kicad_pcb]
2022-10-14 WIP motherboard 2.5 checkpoint
    [1050170001.stp, 1054051110.stp, 1747981-1.step, 2013357-1.step, 21-0140L_T1655-2.step, 436500500.stp, 480995701.stp, 483930001.stp]
2022-10-26 mb25-pcb: routing snapshot (0 unrouted)
    [reform2-lpc.kicad_sch, reform2-motherboard25.kicad_sch, reform2-power.kicad_sch, reform2-usb.kicad_sch]
2022-10-27 motherboard 2.5 snapshot: fully routed and cleaned up
    [HTQFP-80.stp, TYPE-C-31-M-12--3DModel-STEP-56544.STEP, reform2-audio.kicad_sch, reform2-display.kicad_sch, reform2-eth.kicad_sch, reform2-hdmi.kicad_sch, reform2-lpc.kicad_sch, reform2-motherboard25.kicad_sch]
2022-11-01 motherboard25: r-1 snapshot, ordered for test bringup
    [reform2-audio.kicad_sch, reform2-display.kicad_sch, reform2-eth.kicad_sch, reform2-hdmi.kicad_sch, reform2-lpc.kicad_sch, reform2-motherboard25.kicad_sch, reform2-pcie.kicad_sch, reform2-power.kicad_sch]
2022-11-08 imx8mplus: correct the mezzanine footprint, reroute everything, d-2 off to fab
    [reform2-imx8mplus.kicad_pcb, reform2-imx8mplus.kicad_sch]
2022-11-09 imx8mplus: change drill size to 0.2mm, add optional 3v3 source via reset pin
    [reform2-imx8mplus.kicad_pcb, reform2-imx8mplus.kicad_sch]
2023-01-17 reform2-keyboard3 initial design
    [2005280040.stp, 500SSPxS2M2xEA.stp, CPG135001D02 BROWN v5.step, EG1271A.step, KMR221GLFS.step, Kailh - keycap 1.5 v2.step, Kailh_keycap-switch_system_1-5x1.step, Kailh_keycap-switch_system_1.5x1.step]
2023-01-17 reform2-keyboard3: bump date, revision
    [reform2-keyboard3.kicad_sch]
2023-04-14 only talk to uart lines when needed
