jackhumbert/reform/(notices)

Notices in the files:
reform2-motherboard25-pcb/3d-models/SMD_Polyfuse_2920.stp:
Copyright (C) 2017, Joan The Spark
This program is free software: you can redistribute it and/or modify
it under the terms of the GNU General Public License as published by
the Free Software Foundation, either version 3 of the License, or
any later version.
reform2-protected-batterypack-pcb/reform2-protected-batterypack-pcb.kicad_sch:
License: CERN OHL-S 2.0
reform2-keyboard-pcb/reform-kbd-mcu.sch:
Copyright 2017-2022 MNT Research GmbH
reform2-keyboard3-pcb/reform2-keyboard-backlight.kicad_sch:
Copyright 2017-2020 MNT Research GmbH
reform2-keyboard3-pcb/reform2-keyboard3.kicad_sch:
Copyright 2017-2023 MNT Research GmbH
